Eldalote/Divelamp/BodyModel/Housing/Offerte/MainOnderkant3d.png

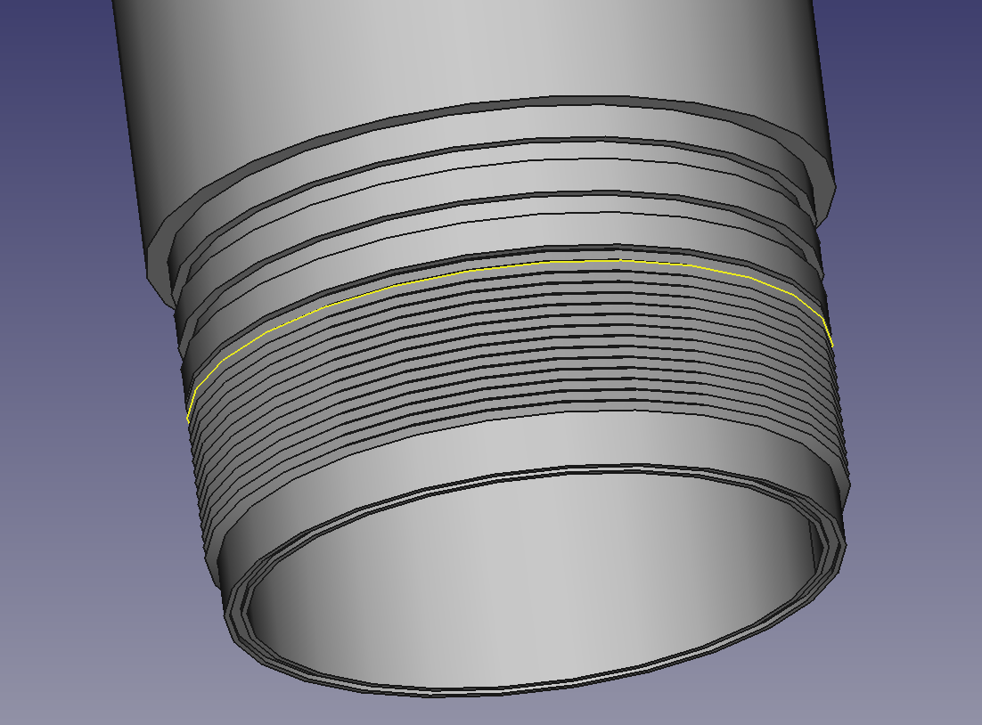
BodyModel/Housing/Offerte/MainOnderkant3d.png
