Eldalote/Divelamp/KiCadProject/OptionalOuterUSB/3D View & Output/OuterUSB Front.png

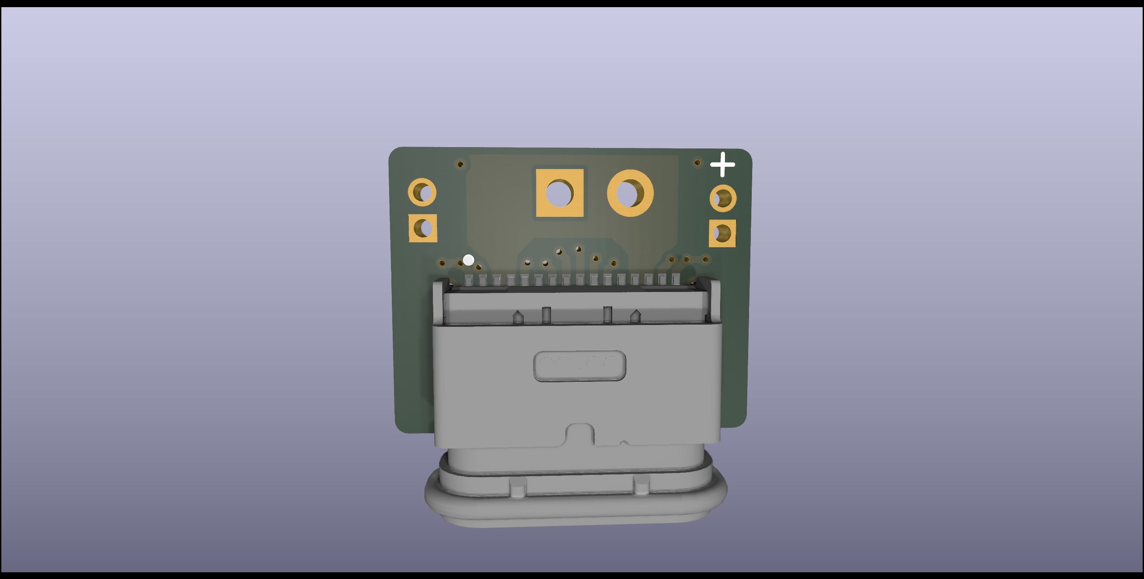
KiCadProject/OptionalOuterUSB/3D View & Output/OuterUSB Front.png
