Eldalote/Divelamp/Notes-TODOs.txt

Nog te bestellen / vergeten:
CMU 2287
SHR-05V-S connector + cables / qwicc cables /  KIT-15081

Xt60 en xt30 connectors + cable assemblies

2130830005 waterproof usb connector

assortiment aan kabeltjes

22uF ceramic caps 0805
