Eldalote/Divelamp/BodyModel/Housing/Offerte/Endstuk3d.png

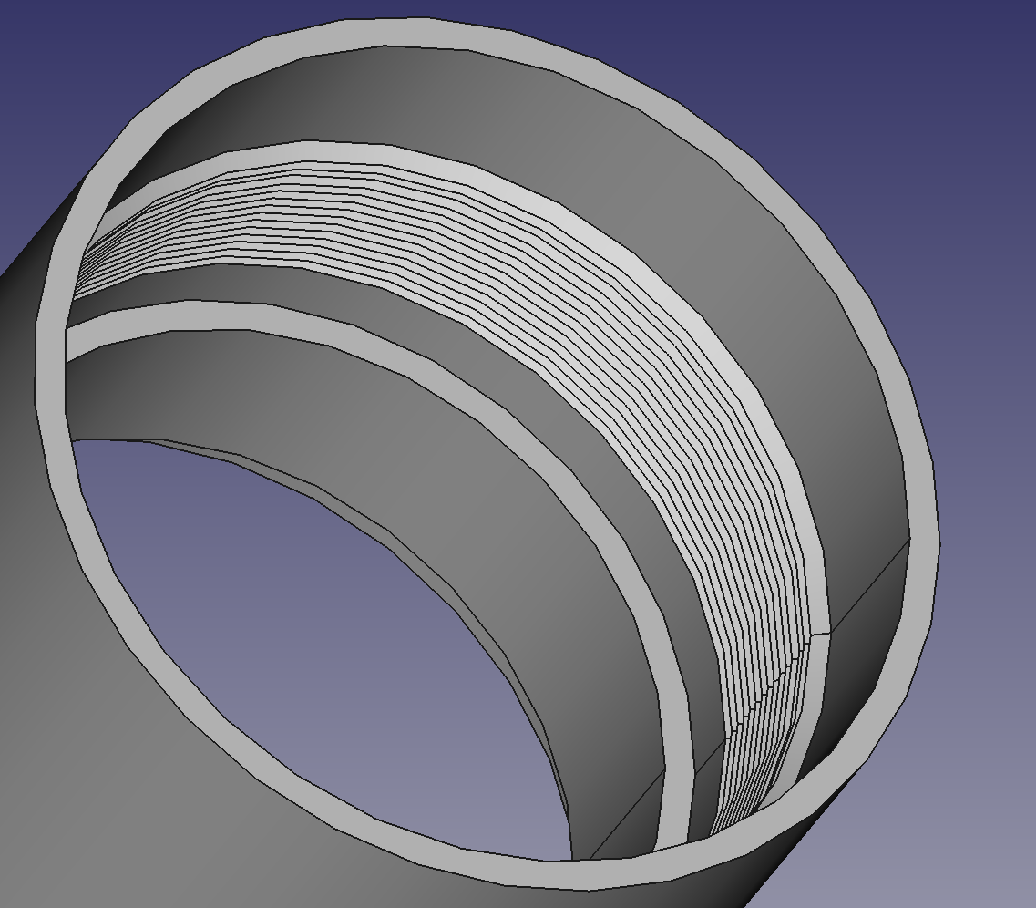
BodyModel/Housing/Offerte/Endstuk3d.png
