Eldalote/Divelamp/BodyModel/Housing/Offerte/EndstukOverzicht.png

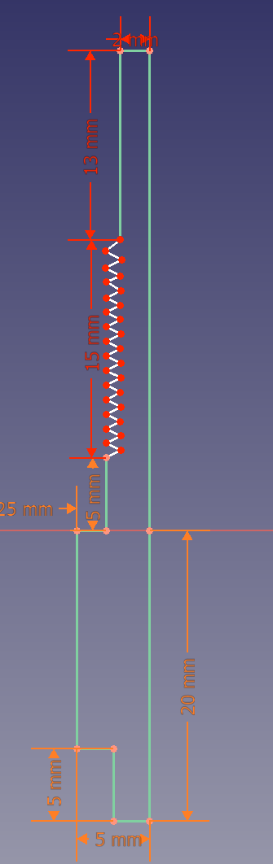
BodyModel/Housing/Offerte/EndstukOverzicht.png
