Eldalote/Divelamp/BodyModel/Housing/Offerte/Mainbovenkantdetail.png

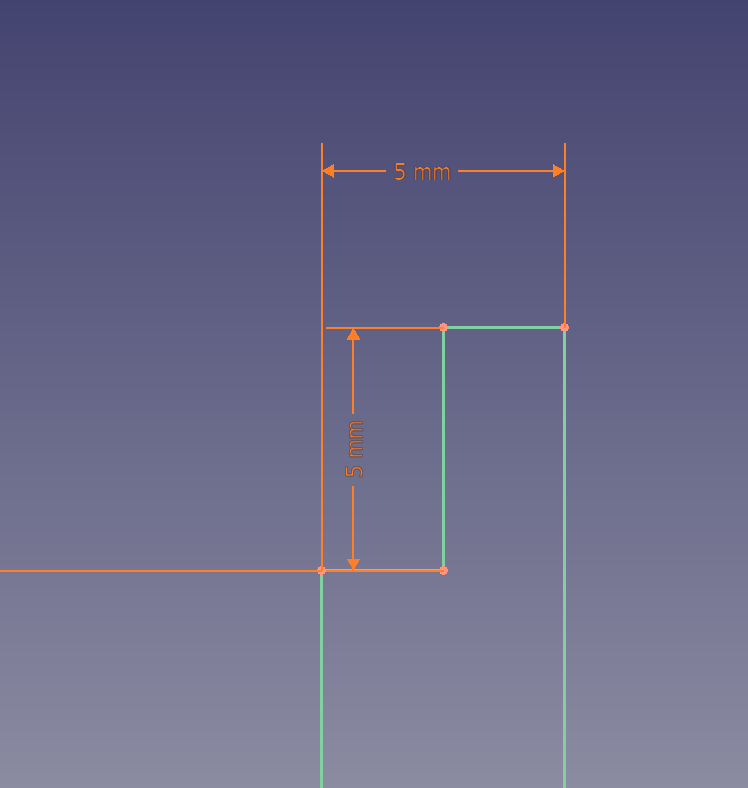
BodyModel/Housing/Offerte/Mainbovenkantdetail.png
