Eldalote/Divelamp/BodyModel/Housing/Offerte/MainOnderkantdetail2d.png

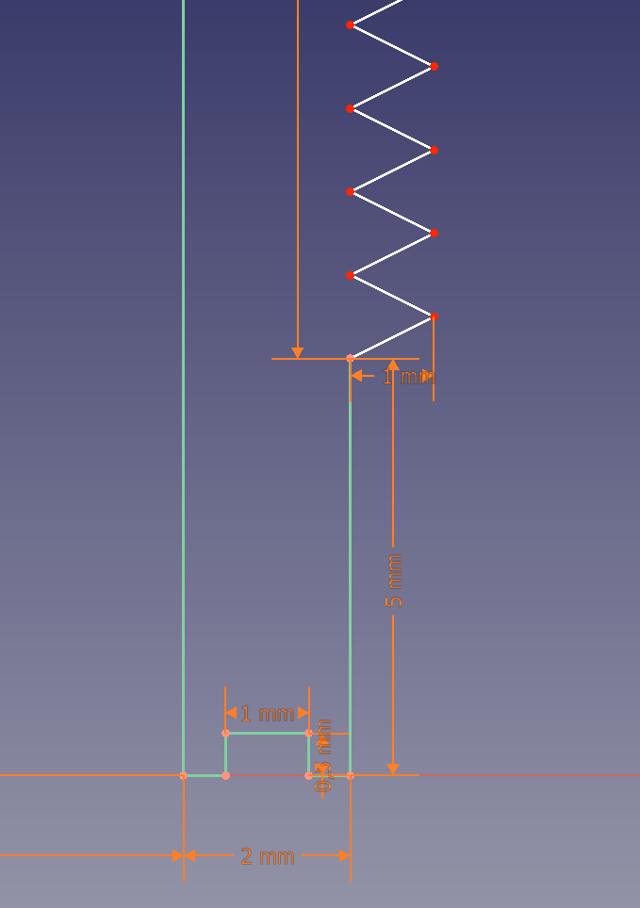
BodyModel/Housing/Offerte/MainOnderkantdetail2d.png
