Eldalote/Divelamp/BodyModel/Housing/Offerte/Mainoringgrooves2d.png

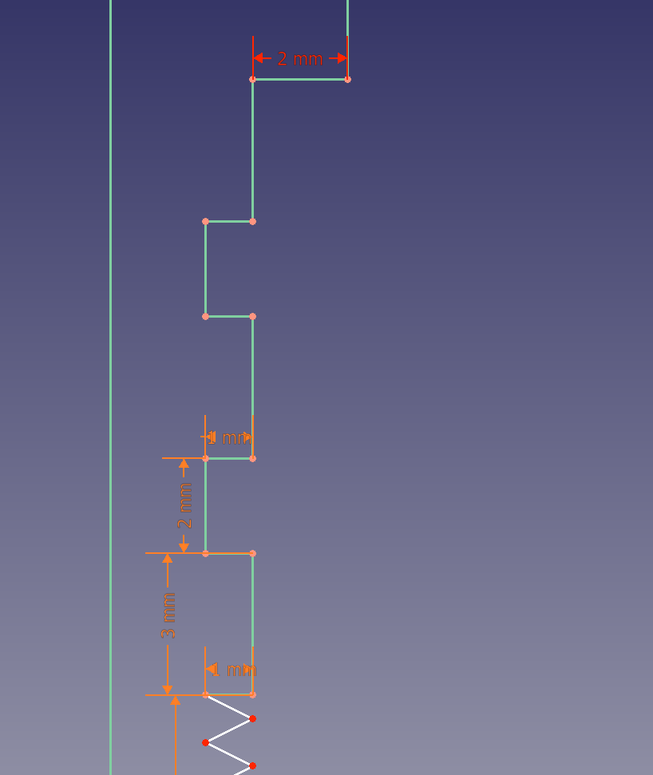
BodyModel/Housing/Offerte/Mainoringgrooves2d.png
