Eldalote/Divelamp/BodyModel/Housing/Offerte/MainOverzicht.png

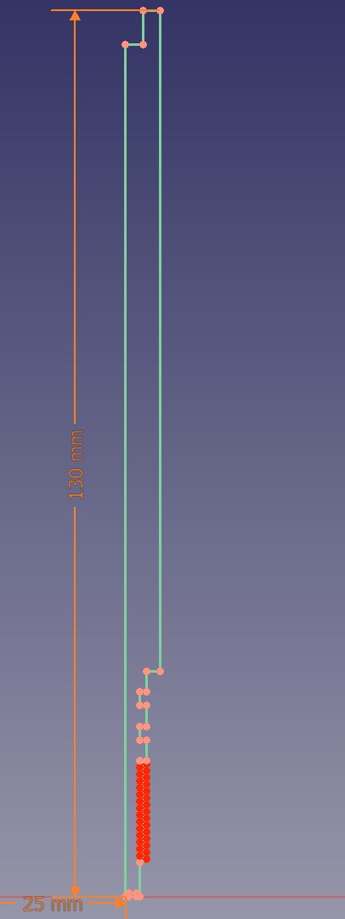
BodyModel/Housing/Offerte/MainOverzicht.png
