Eldalote/Divelamp/KiCadProject/BatteryManagementBoard/3D View & output/BMB Back Angle.png

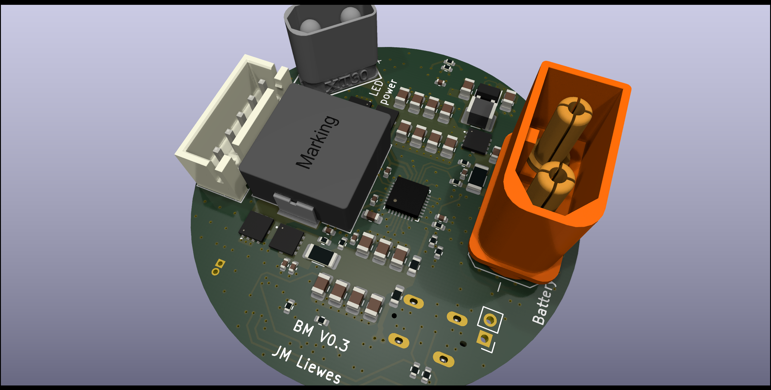
KiCadProject/BatteryManagementBoard/3D View & output/BMB Back Angle.png
