Eldalote/Divelamp/KiCadProject/BatteryManagementBoard/3D View & output/BMB Back.png

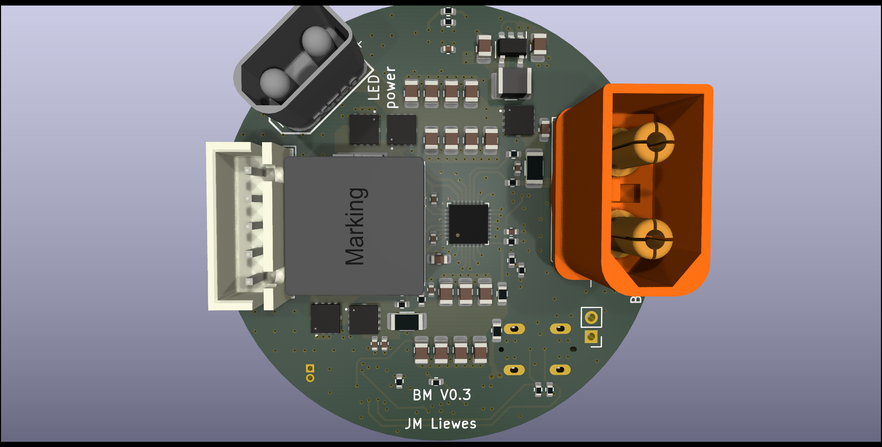
KiCadProject/BatteryManagementBoard/3D View & output/BMB Back.png
