Eldalote/Divelamp/KiCadProject/BatteryManagementBoard/3D View & output/BMB Front Angle.png

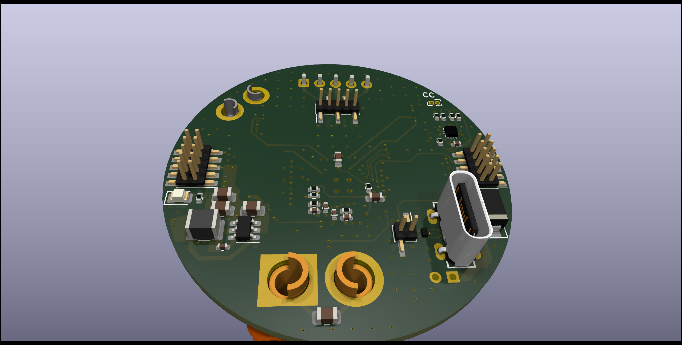
KiCadProject/BatteryManagementBoard/3D View & output/BMB Front Angle.png
