Eldalote/Divelamp/KiCadProject/BatteryManagementBoard/3D View & output/BMB Front.png

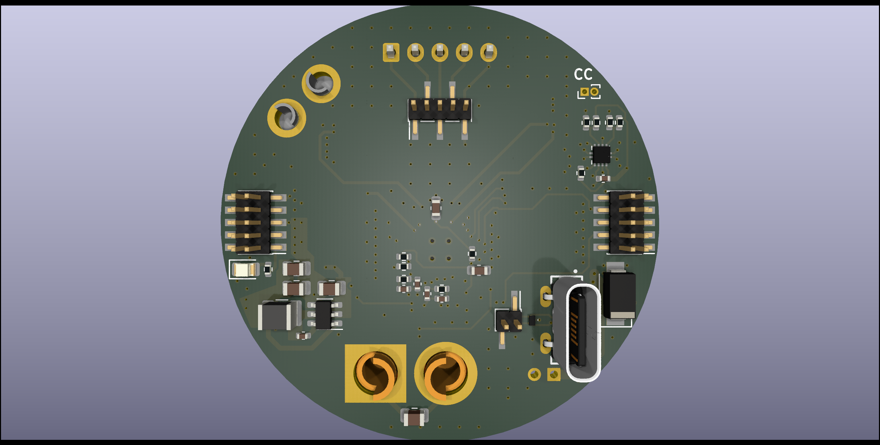
KiCadProject/BatteryManagementBoard/3D View & output/BMB Front.png
