Eldalote/Divelamp/KiCadProject/BatteryManagementBoard/BatteryManagementOverview.png

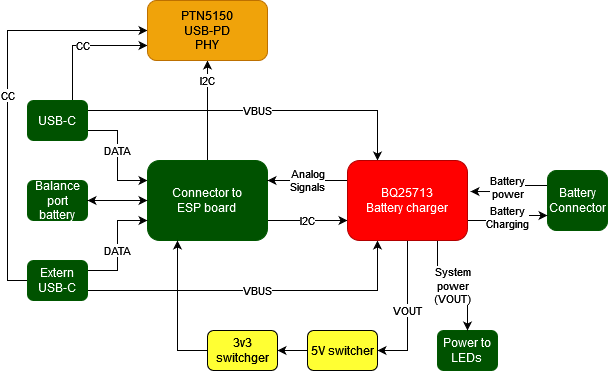
KiCadProject/BatteryManagementBoard/BatteryManagementOverview.png
