Eldalote/Divelamp/KiCadProject/BatteryManagementBoard/VeryRoughSketch.png

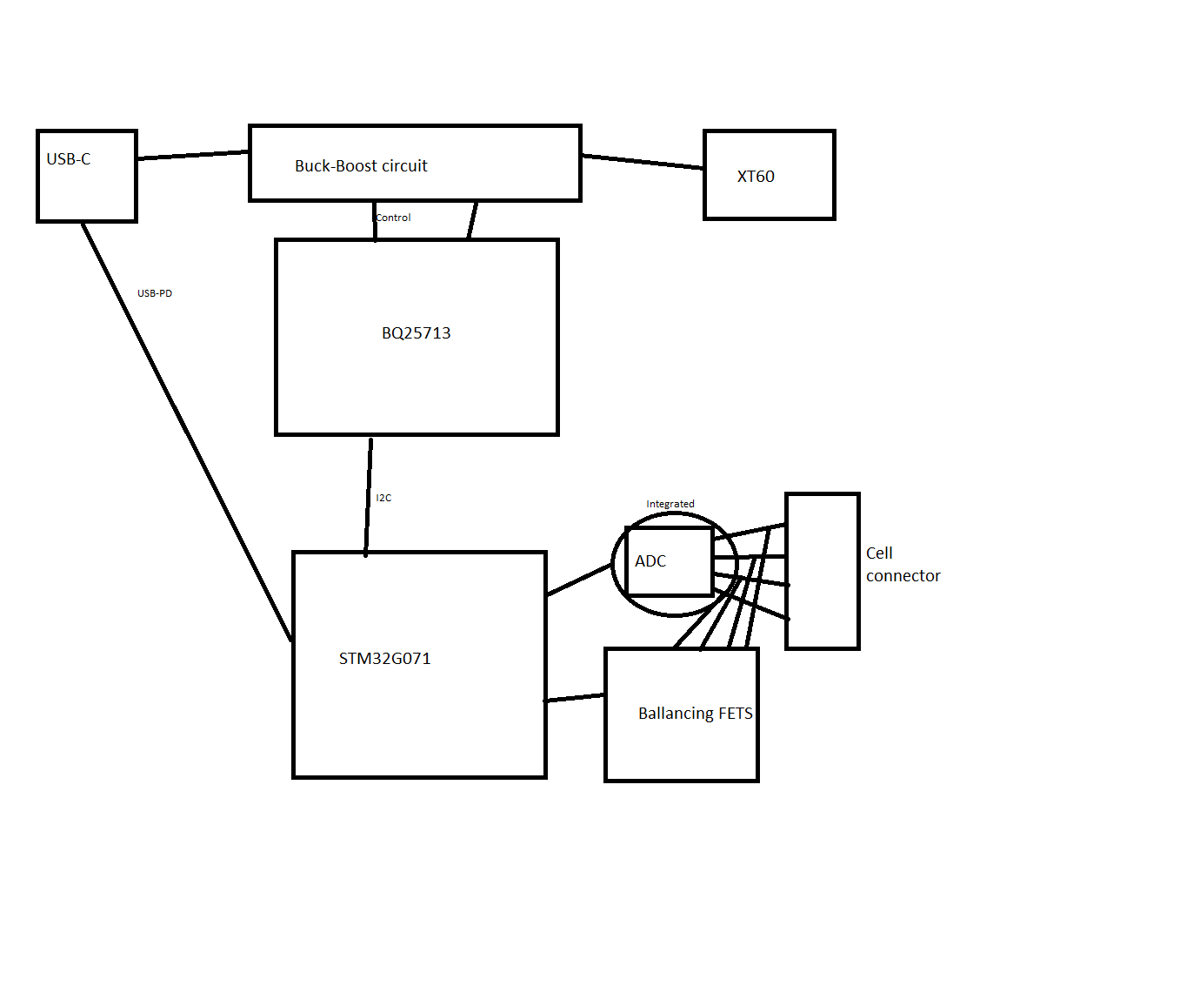
KiCadProject/BatteryManagementBoard/VeryRoughSketch.png
