Eldalote/Divelamp/KiCadProject/ESPBoard/3D view & Output/ESPBoard back Angle.png

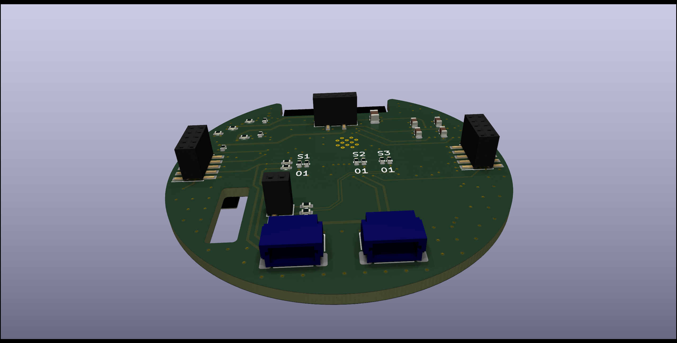
KiCadProject/ESPBoard/3D view & Output/ESPBoard back Angle.png
