Eldalote/Divelamp/KiCadProject/ESPBoard/3D view & Output/ESPBoard back.png

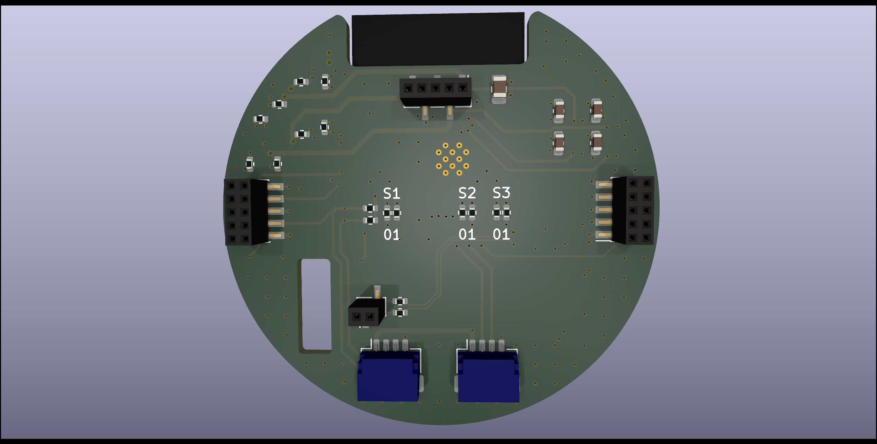
KiCadProject/ESPBoard/3D view & Output/ESPBoard back.png
