Eldalote/Divelamp/KiCadProject/ESPBoard/3D view & Output/ESPBoard Front Angle.png

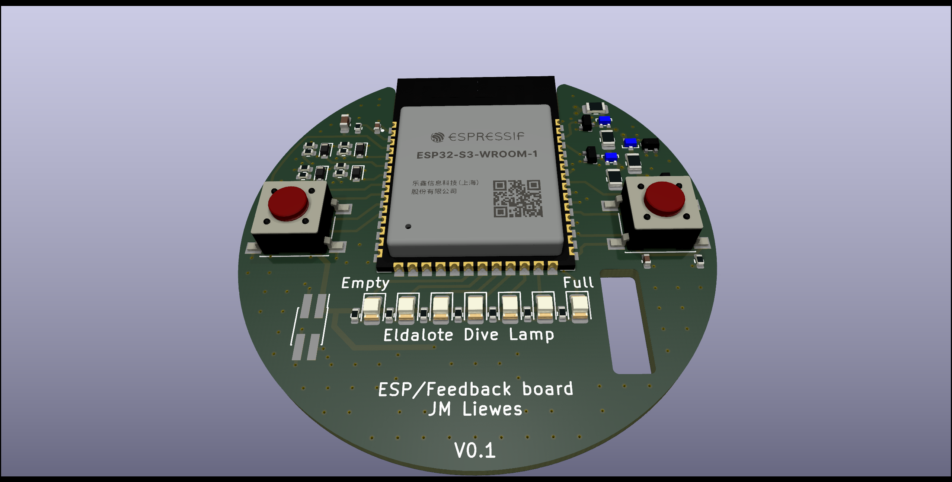
KiCadProject/ESPBoard/3D view & Output/ESPBoard Front Angle.png
