Eldalote/Divelamp/KiCadProject/ESPBoard/3D view & Output/ESPBoard Front.png

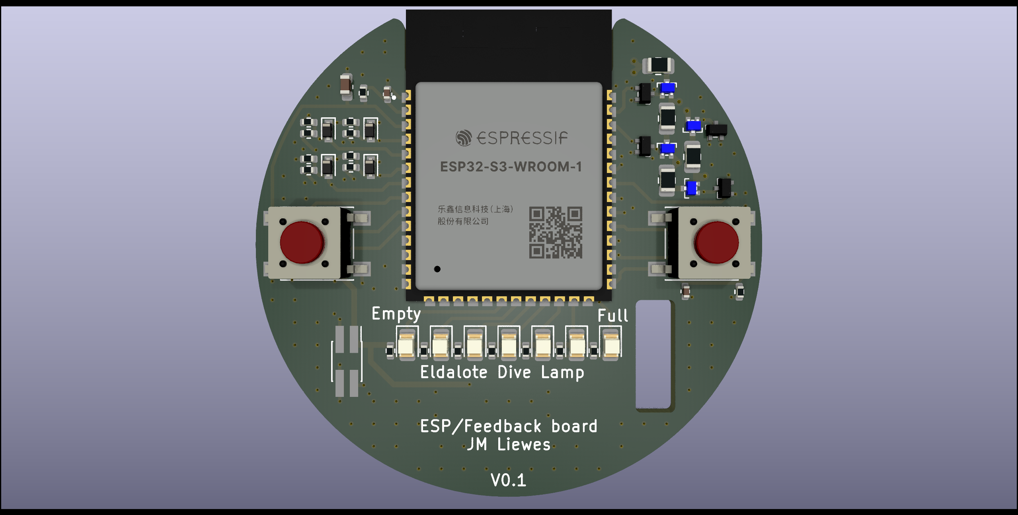
KiCadProject/ESPBoard/3D view & Output/ESPBoard Front.png
