Eldalote/Divelamp/KiCadProject/ESPBoard/ESP Board overview.png

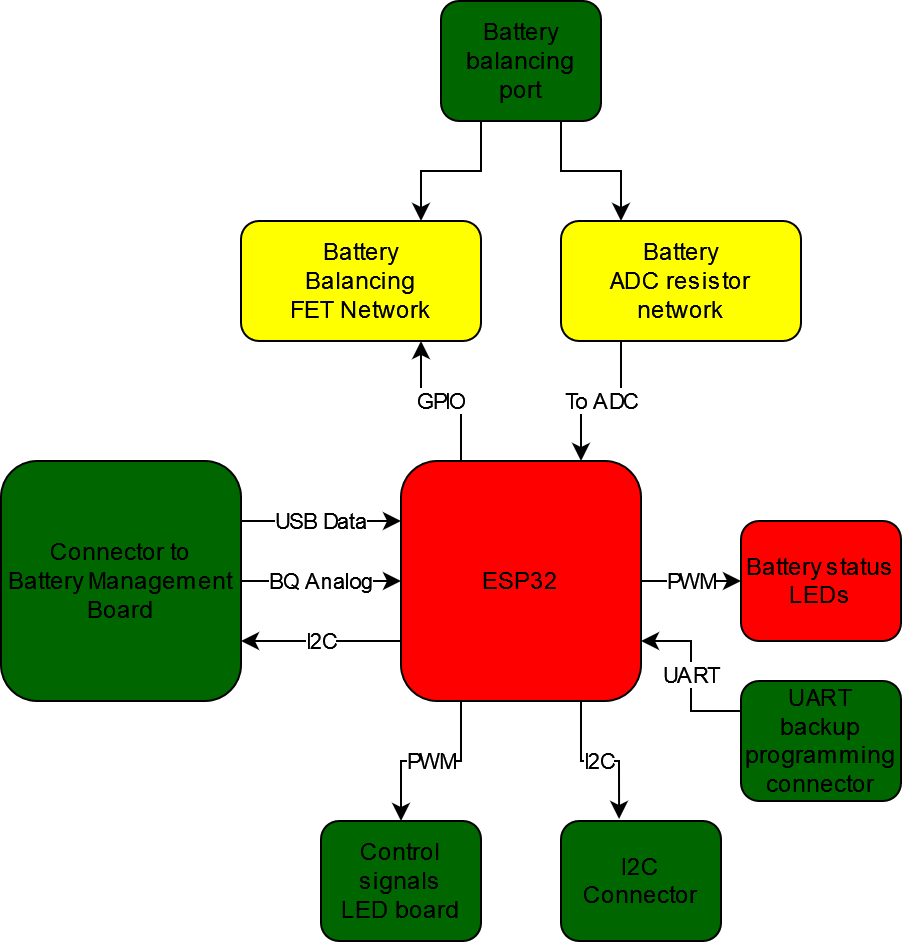
KiCadProject/ESPBoard/ESP Board overview.png
