Eldalote/Divelamp/KiCadProject/HallBoard/3D View & Output/HallBoard Back.png

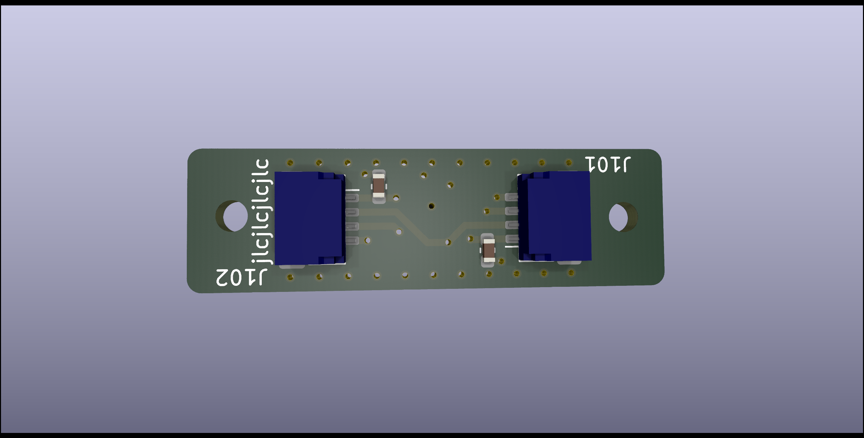
KiCadProject/HallBoard/3D View & Output/HallBoard Back.png
