Eldalote/Divelamp/KiCadProject/HallBoard/3D View & Output/HallBoard.png

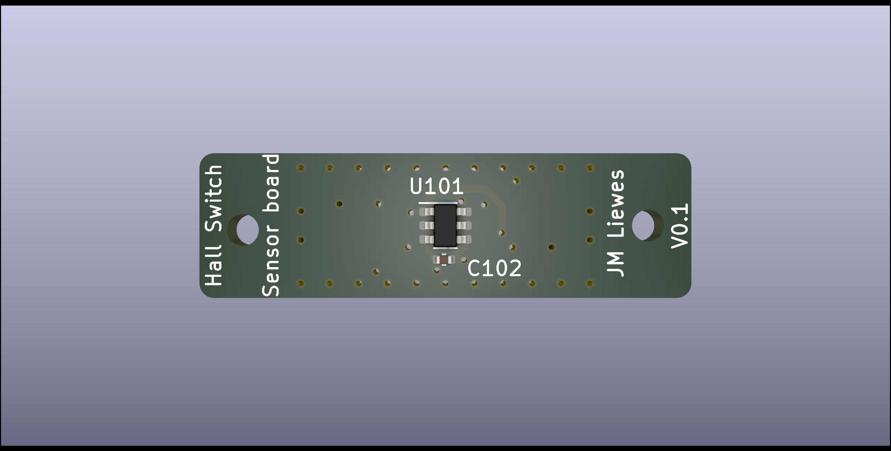
KiCadProject/HallBoard/3D View & Output/HallBoard.png
