Eldalote/Divelamp/KiCadProject/LEDDriverBoard/3D view & Output/LED driver Back.png

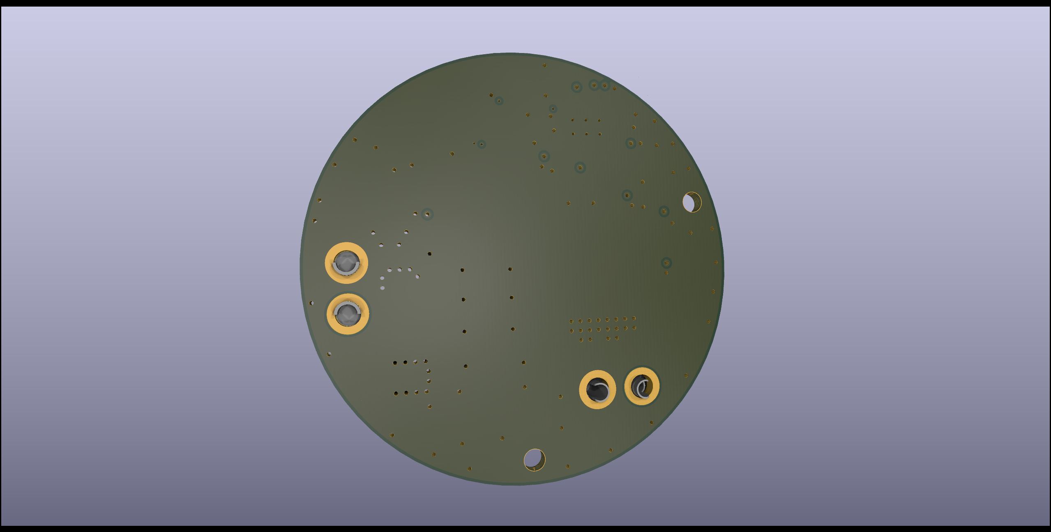
KiCadProject/LEDDriverBoard/3D view & Output/LED driver Back.png
