Eldalote/Divelamp/KiCadProject/LEDDriverBoard/3D view & Output/LED driver front Angle.png

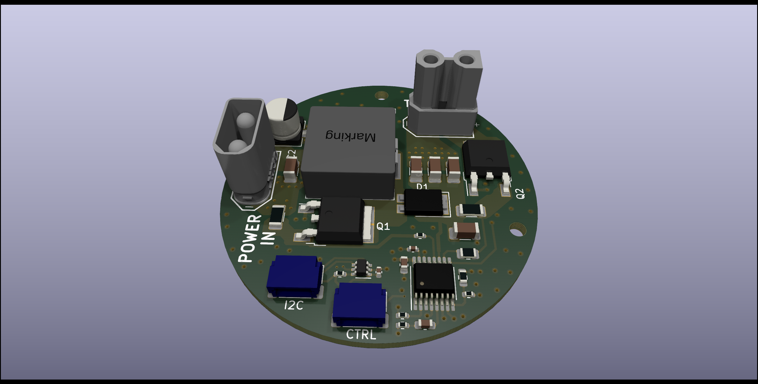
KiCadProject/LEDDriverBoard/3D view & Output/LED driver front Angle.png
