Eldalote/Divelamp/KiCadProject/LEDDriverBoard/3D view & Output/LED driver front.png

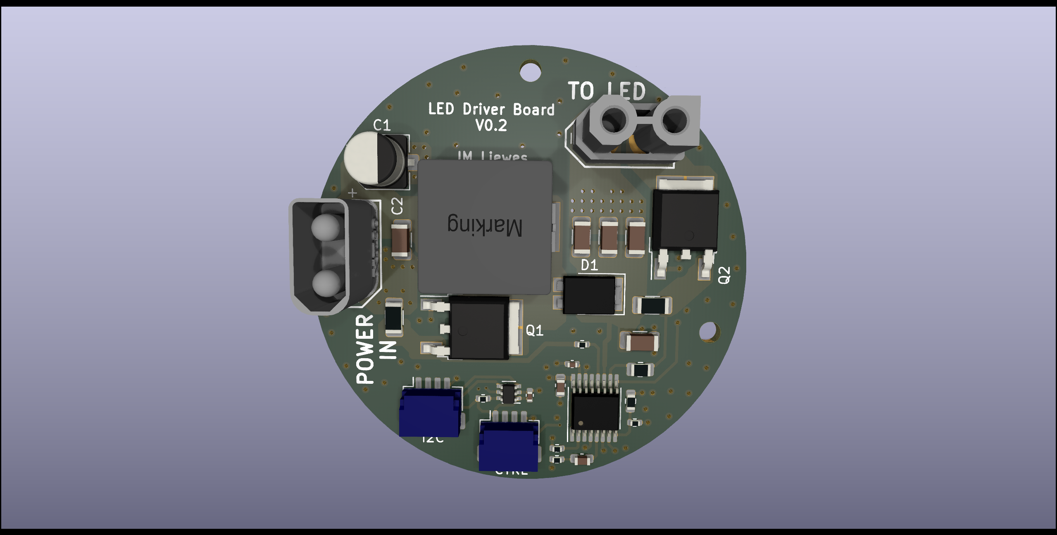
KiCadProject/LEDDriverBoard/3D view & Output/LED driver front.png
