Eldalote/Divelamp/KiCadProject/OptionalOuterUSB/3D View & Output/OuterUSB Back Angle.png

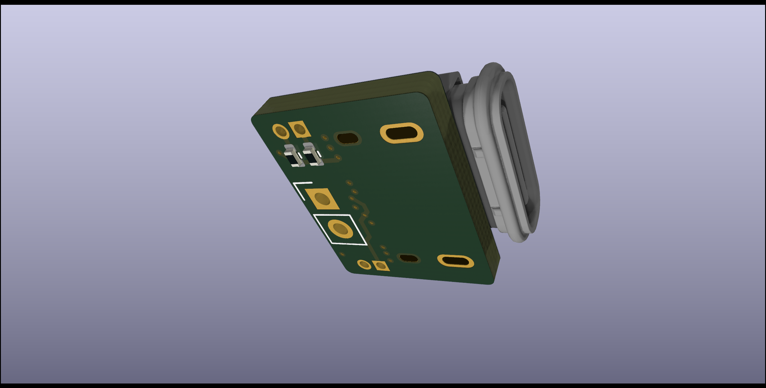
KiCadProject/OptionalOuterUSB/3D View & Output/OuterUSB Back Angle.png
