Eldalote/Divelamp/KiCadProject/OptionalOuterUSB/3D View & Output/OuterUSB Front Angle.png

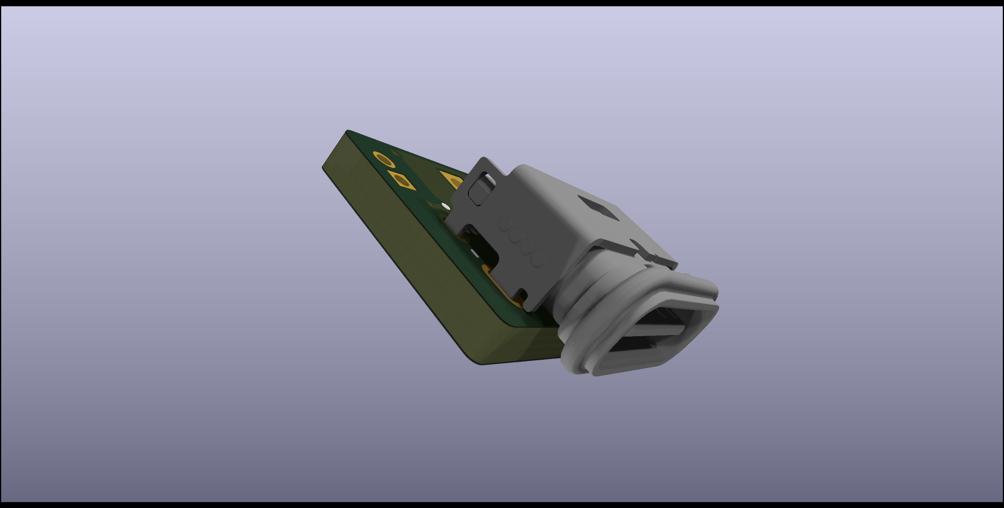
KiCadProject/OptionalOuterUSB/3D View & Output/OuterUSB Front Angle.png
