Eldalote/Divelamp/KiCadProject/SamsungLedBoard/3D View & Output/SamsungLedBoard Front.png

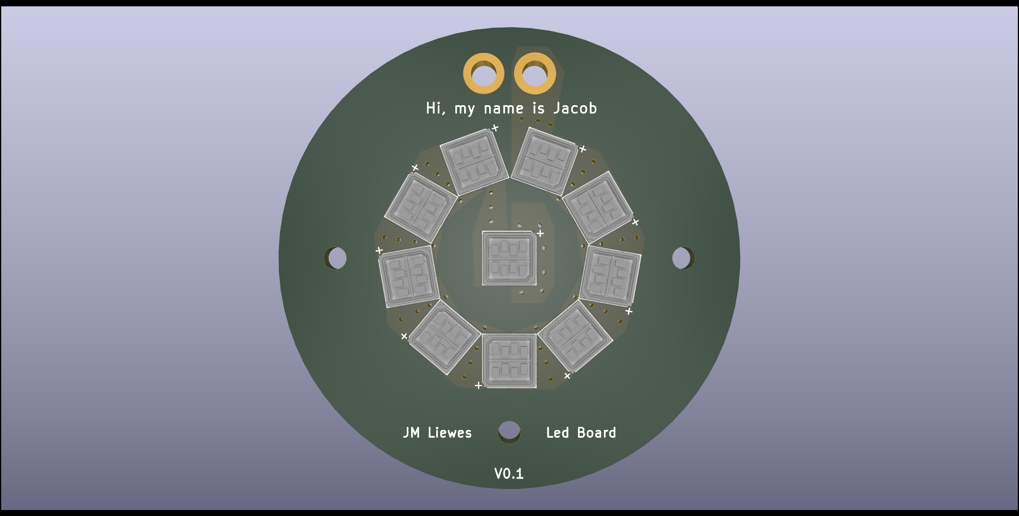
KiCadProject/SamsungLedBoard/3D View & Output/SamsungLedBoard Front.png
