Eldalote/Divelamp/VeryRoughSketch.png

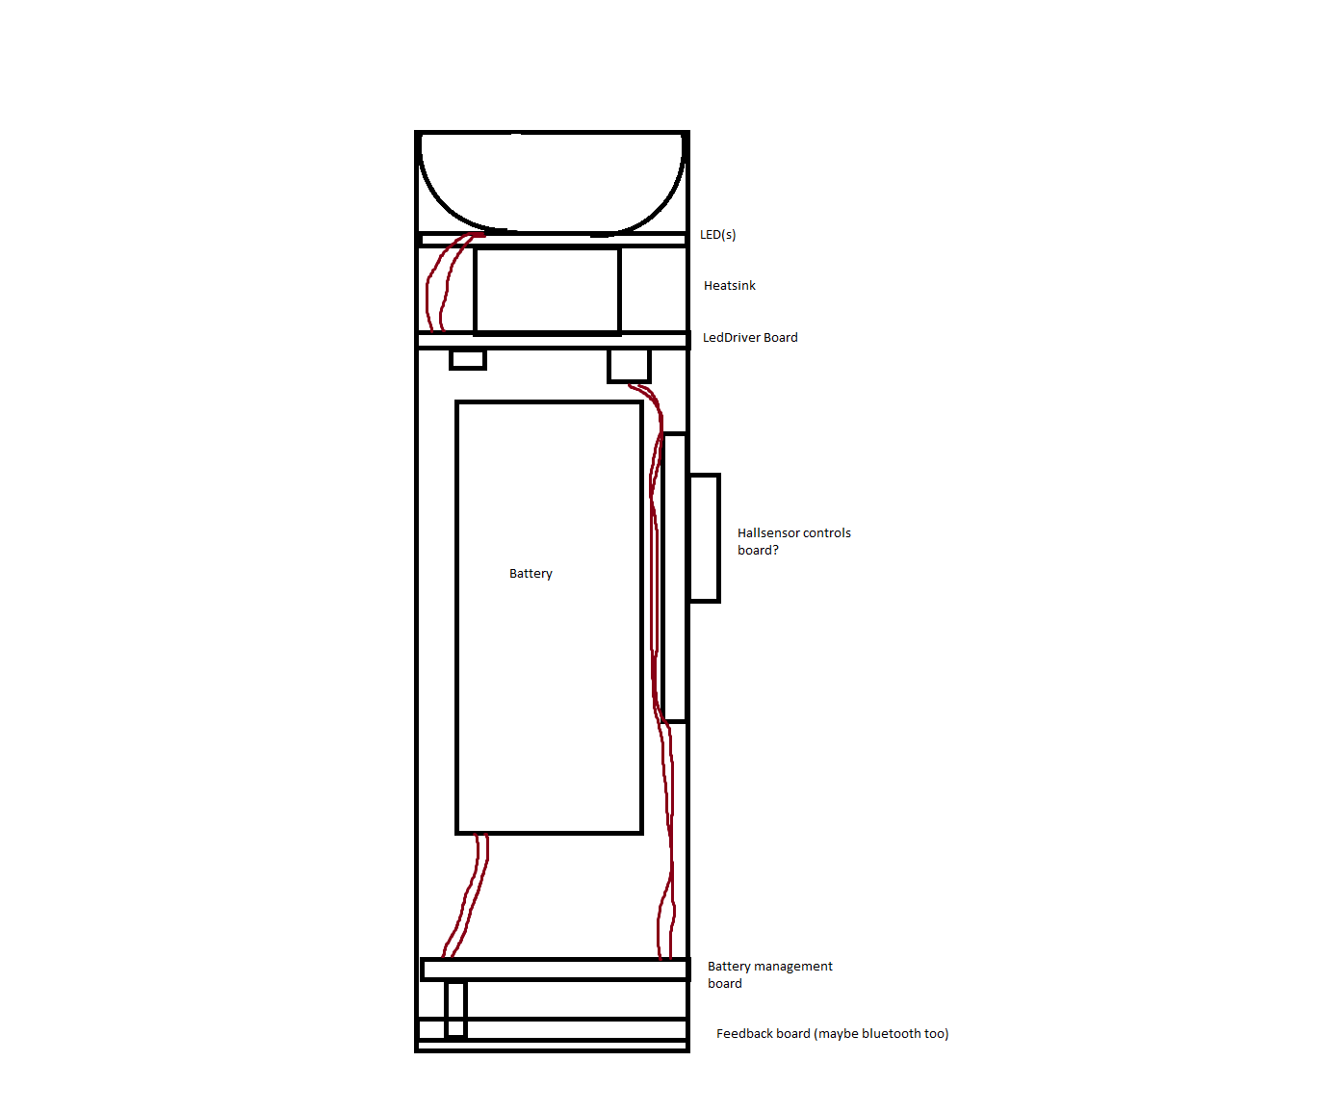
VeryRoughSketch.png
