Eldalote/Divelamp/KiCadProject/LEDDriverBoard/Components.ods

Sheet: New component definition
Component | Components in design | Footprint | Min Value | Max Value | Determined value | Other min ratings? | Hard Selected component? | Soft selected component | Alt soft selected
LED driver IC | U1 | TSSOP-16 |  |  | MAX16833 |  | MAX16833
Power Inductor | L1 | Custom |  |  | 6.8uH | 8.4A Average 9.5A Peak current | SRP1265C-6R8M
Schottsky diode | D1 | PowerDi-5 | 90v 5A |  |  |  |  | SDT5H100P5-7
Switching N-MOSFET | Q1 | TO-252 | 90v 5A |  |  | GDS |  | AOD66920
Dimming P-MOSFET | Q2 | TO-252 | 90v 5A |  |  | GDS |  | SUD50P10-43L-GE3
Connector Cap | c1 | 5x5.3 SMD elec | 22u 50V | 100u |  |  |  | 865080542006
In cap boost | C2 | 1206 | 10u 50V |  |  |  |  | CL31B106KBHNNNE
In cap for ic | C3 | 0603 | 100n 50V |  |  |  |  | CL05B104KB54PNC
VCC regulator cap | C4 | 0402 | 1u 16V
Compensation cap | C5 | 0603 | 25V |  | 220n / 390n |  |  | TMK107B7224KA-T | GCJ188R91E394KA01D
Output Caps | C6,C7,C8,C9 | 1206 | 4.7u 100V |  |  |  |  | GRJ31CZ72A475KE01L
100k Resistor (multiple) | R2, R3, R10 | 0402 | 100K |  |  |  |  | RC0402JR-07100KL
Frequency selection res | R1 | 0402 | 7.3 | 7.4 |  |  |  | RC0402FR-077K32L
Compensation Resistor | R8 | 0402 |  |  | 910Ohm/ 120Ohm |  |  | RC0402FR-07910RL | RC0402FR-07120RL
Switch current sense compensation res | R4 | 0402 |  |  | 4.7kOhm/2.7kOhm |  |  | RC0402FR-134K7L | RC0402FR-072K7L
Switch current sense res | R9 | 1206 |  |  | 51mOhm/33mOhm |  |  | RL1206FR-7W0R051L | D1WEL1206MR033FA-T5
LED current sense extra res | R7 | 0603 |  |  | 100Ohm |  |  | RC0603FR-13100RL
Overvoltage protection res | R5 | 0603 |  |  | 5.1MOhm / 4.75MOhm |  |  | RC0603FR-075M1L | RC0603FR-074M75L
LED current sense res | R6 | 1206 |  |  | 330mOhm/130mOhm |  |  | D1WEL1206MR330F-T5 | CRL1206-FW-R130ELF

Sheet: Sheet1
Component | value | Footprint | Name | octopart
OUTDATED COMPONENT NUMBERING!!!!
C1 | 10uF | 1206 | CL31B106KBHNNNE | https://octopart.com/search?q=CL31B106KBHNNNE&currency=EUR&specs=0
C2 | 4x4.7uF | 1206 | GRM31CC72A475KE11L | https://octopart.com/search?q=GRM31CC72A475KE11L&currency=EUR&specs=0
C3 | 2.2uF | 0603 | CL10A225KO8NNN | https://octopart.com/search?q=CL10A225KO8NNN&currency=EUR&specs=0
C4 | 0.22uF | 0805 | CL21B224KCFSNWE | https://octopart.com/search?q=CL21B224KCFSNWE&currency=EUR&specs=0
C4* | 0.39uF | 0805 | C0805X394K5RAC7800 | https://octopart.com/search?q=C0805X394K5RAC7800&currency=EUR&specs=0
R1 | 4.7kOhm | 0603 | RC0603FR-074K7L | https://octopart.com/search?q=RC0603FR-074K7L&currency=EUR&specs=0
R1* | 2.7kOhm | 0603 | RC0603FR-102K7L | https://octopart.com/search?q=RC0603FR-102K7L&currency=EUR&specs=0
R2 | 100Ohm | 0805 | RC0805FR-07100RL | https://octopart.com/search?q=RC0805FR-07100RL&currency=EUR&specs=0
R3 | 7.5kOhm | 0603 | RC0603FR-137K5L | https://octopart.com/search?q=RC0603FR-137K5L&currency=EUR&specs=0
R4 | 51mOhm | 0603 | ERJ-3BWFR051V | https://octopart.com/search?q=ERJ-3BWFR051V&currency=EUR&specs=0
R4* | 33mOhm | 0603 | D1WEL0603MR033F-T5 | https://octopart.com/search?q=D1WEL0603MR033F-T5&currency=EUR&specs=0
R5 | 5.1MOhm | 0603 | RC0603FR-075M1L | https://octopart.com/search?q=RC0603FR-075M1L&currency=EUR&specs=0
R5* | 4.75MOhm | 0603 | RC0603FR-074M75L | https://octopart.com/search?q=RC0603FR-074M75L&currency=EUR&specs=0
R7 | 330mOhm | 1206 | D1WEL1206MR330F-T5 | https://octopart.com/search?q=D1WEL1206MR330F-T5&currency=EUR&specs=0
R7* | 130mOhm | 1206 | CRL1206-FW-R130ELF | https://octopart.com/search?q=CRL1206-FW-R130ELF&currency=EUR&specs=0
R8 | 100kOhm | 0603 | RC0603FR-07100KL | https://octopart.com/search?q=RC0603FR-07100KL&currency=EUR&specs=0
R9 | 100kOhm | 0603 | RC0603FR-07100KL | https://octopart.com/search?q=RC0603FR-07100KL&currency=EUR&specs=0
R10 | 953Ohm | 0402 | RC0402FR-07953RL | https://octopart.com/search?q=RC0402FR-07953RL&currency=EUR&specs=0
R10* | 120Ohm | 0402 | RC0402FR-07120RL | https://octopart.com/search?q=RC0402FR-07120RL&currency=EUR&specs=0
R11 | 100kOhm | 0603 | RC0603FR-07100KL | https://octopart.com/search?q=RC0603FR-07100KL&currency=EUR&specs=0
D1 | Schottsky | PowerDi5 | SDT5H100P5-7 | https://octopart.com/search?q=SDT5H100P5-7&currency=EUR&specs=0
L1 | 6.8uH | Custom | SRP1265C-6R8M | https://octopart.com/search?q=SRP1265C-6R8M&currency=EUR&specs=0
