Eldalote/Divelamp/BodyModel/Housing/HousingMachining.FCStd

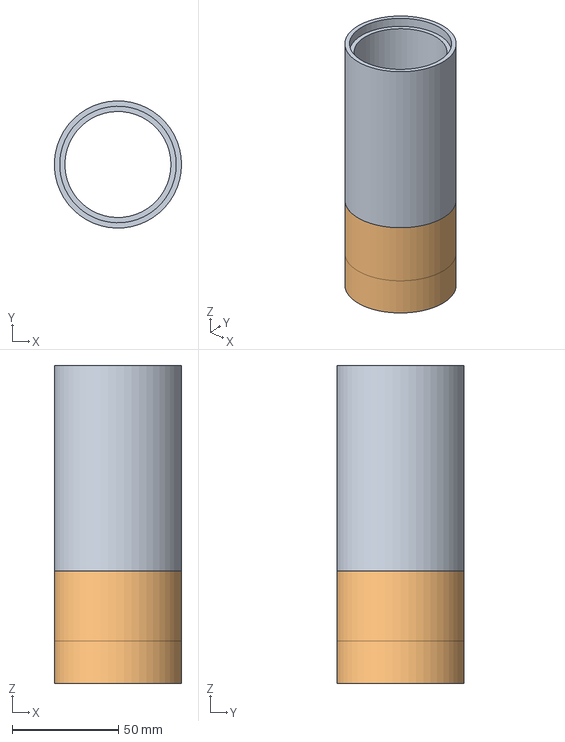
[picture p29: CAD file, 2023-02-27]
BodyModel/Housing/HousingMachining.FCStd
59.9 x 60.0 x 150.0 mm
