Eldalote/Divelamp/BodyModel/Housing/Offerte/HousingOfferte.step

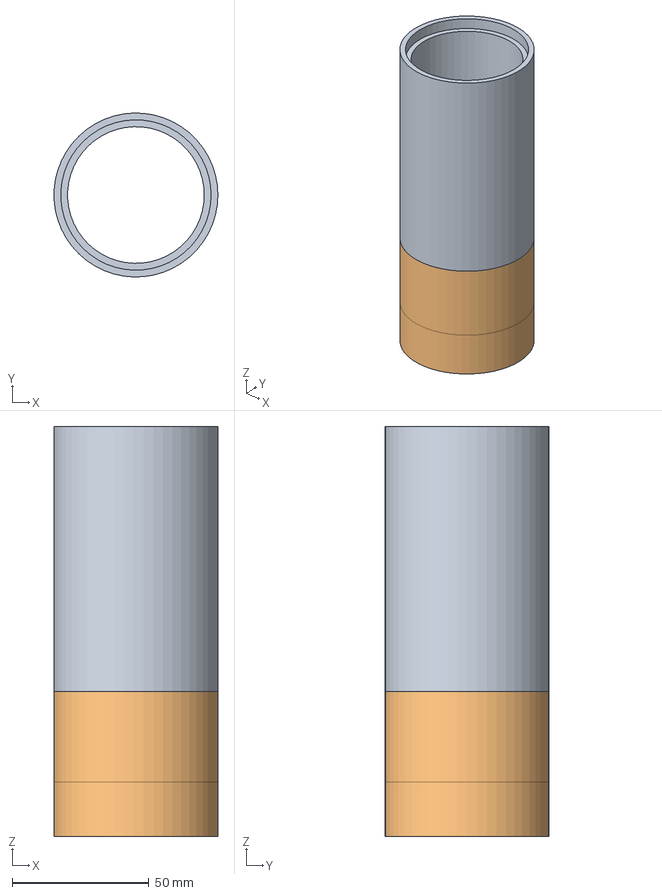
[picture p30: CAD file, 2023-02-23]
BodyModel/Housing/Offerte/HousingOfferte.step
59.9 x 60.0 x 150.0 mm
Sketch
