Eldalote/Divelamp/BodyModel/Parts/Battery/Battery.FCStd

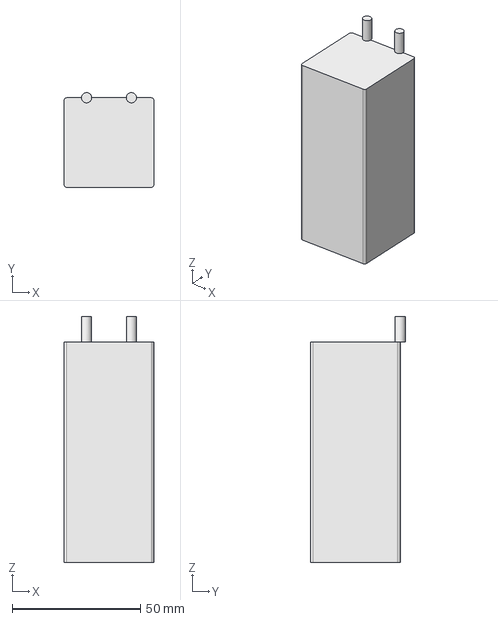
[picture p31: CAD file, 2023-02-06]
BodyModel/Parts/Battery/Battery.FCStd
35.0 x 37.0 x 96.0 mm
