Eldalote/Divelamp/BodyModel/Parts/PCBs/HallBoard.step

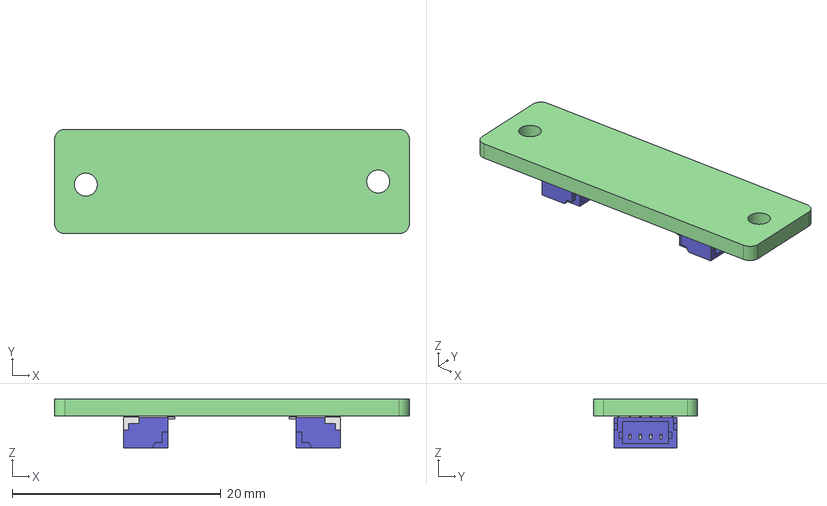
[picture p32: CAD file, 2023-02-02]
BodyModel/Parts/PCBs/HallBoard.step
34.0 x 10.0 x 4.66 mm
HallBoard PCB
