Eldalote/Divelamp/KiCadProject/OptionalOuterUSB/3D View & Output/OuterUSB.step

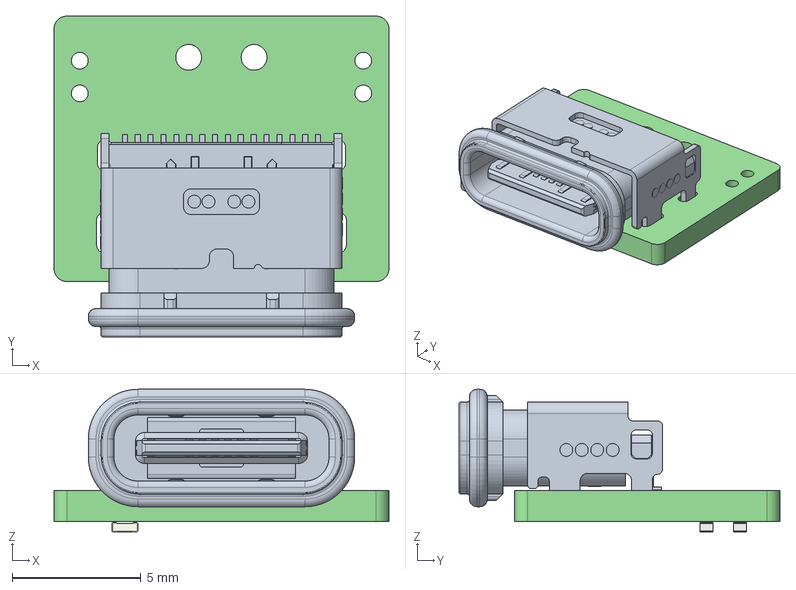
[picture p33: CAD file, 2023-03-17]
KiCadProject/OptionalOuterUSB/3D View & Output/OuterUSB.step
13.0 x 12.4 x 5.53 mm
OuterUSB PCB
