Eldalote/Divelamp/BodyModel/Parts/PCBs/SamsungLedBoard.step

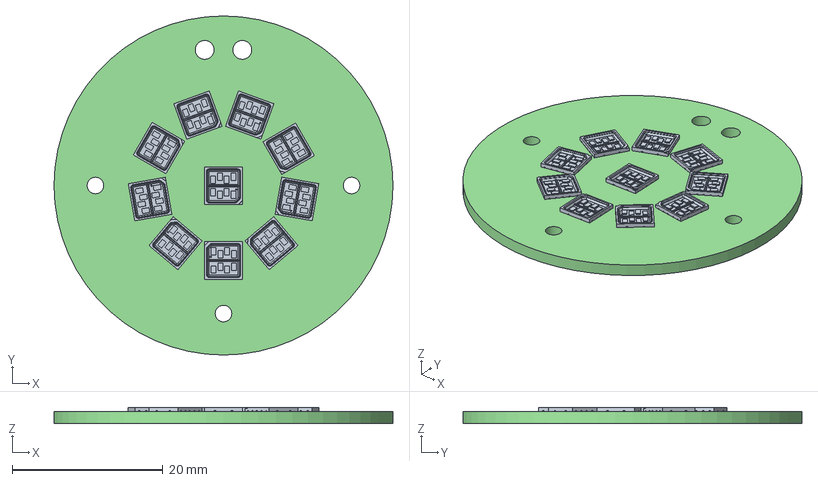
[picture p34: CAD file, 2023-02-02]
BodyModel/Parts/PCBs/SamsungLedBoard.step
45.0 x 45.0 x 2.16 mm
SamsungLedBoard PCB
