Eldalote/Divelamp/KiCadImports/3DModels/STEP_LH502C_LH508C.stp

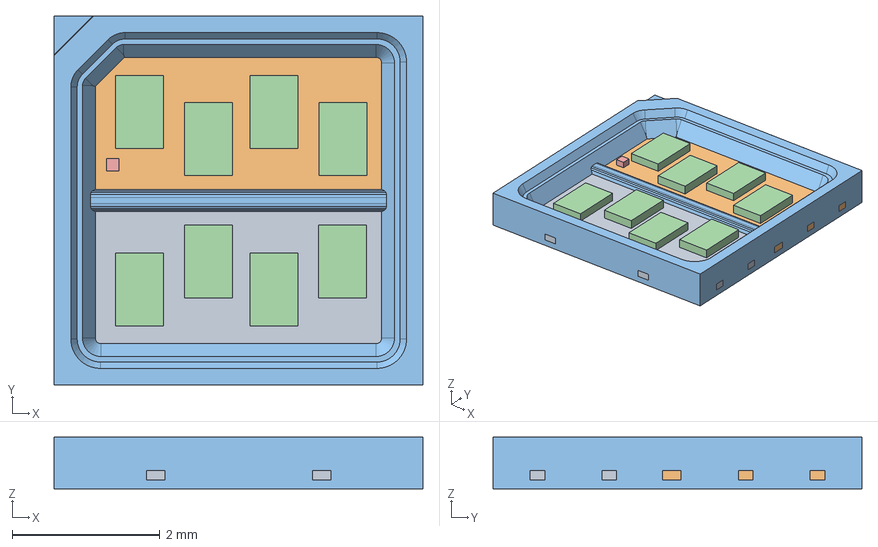
[picture p35: CAD file, 2023-02-01]
KiCadImports/3DModels/STEP_LH502C_LH508C.stp
5.00 x 5.00 x 0.7 mm
DT_MATERIAL11715789 x 2
A$C27796F67788 x 8
DT_OPTIONS11717787
DT_LIGHT11718786 x 2
