Eldalote/Divelamp/BodyModel/Parts/PCBs/OuterUSB.step

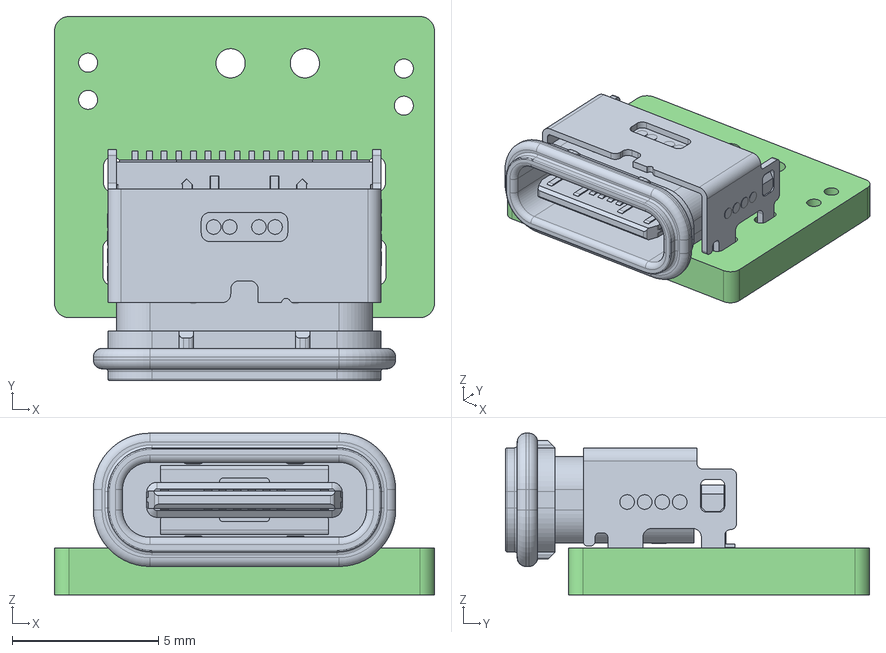
[picture p36: CAD file, 2023-02-02]
BodyModel/Parts/PCBs/OuterUSB.step
13.0 x 12.4 x 5.53 mm
OuterUSB PCB
