Eldalote/Divelamp/KiCadImports/3DModels/SC-89.step

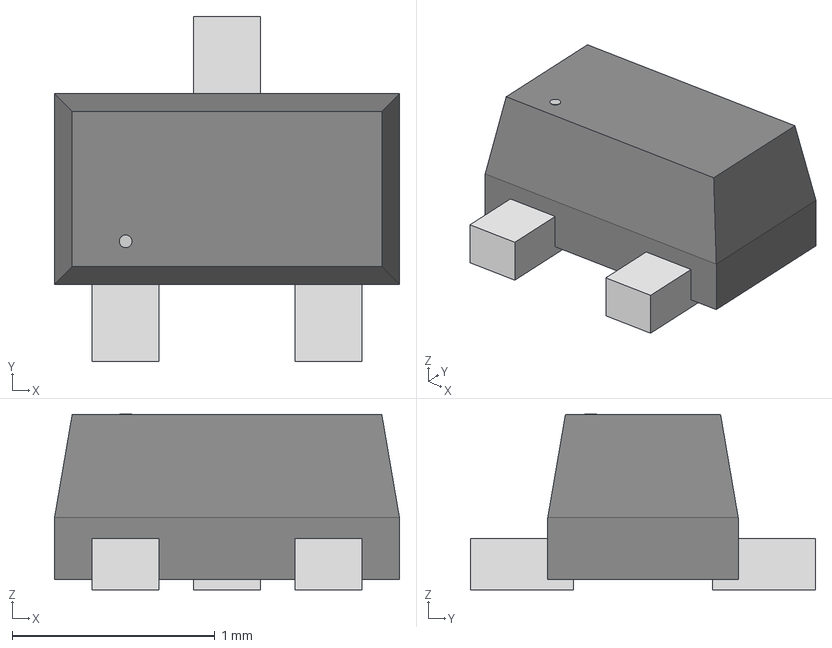
[picture p37: CAD file, 2023-01-25]
KiCadImports/3DModels/SC-89.step
1.70 x 1.70 x 0.866 mm
