Eldalote/Divelamp/KiCadImports/3DModels/SOT1355-1_X2QFN12_NXP.step

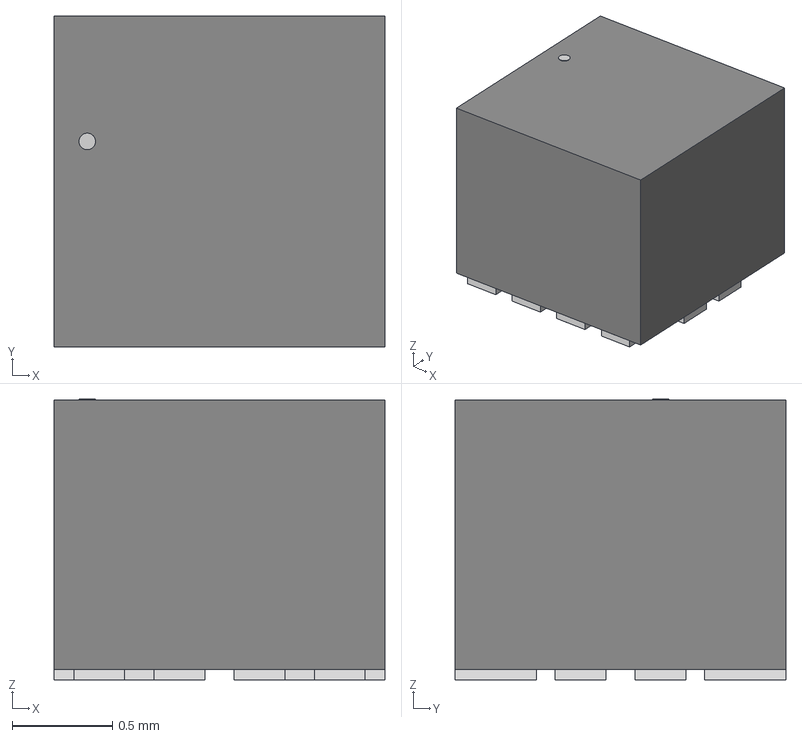
[picture p38: CAD file, 2023-01-25]
KiCadImports/3DModels/SOT1355-1_X2QFN12_NXP.step
1.65 x 1.65 x 1.40 mm
