Eldalote/Divelamp/KiCadImports/3DModels/SOT-723.step

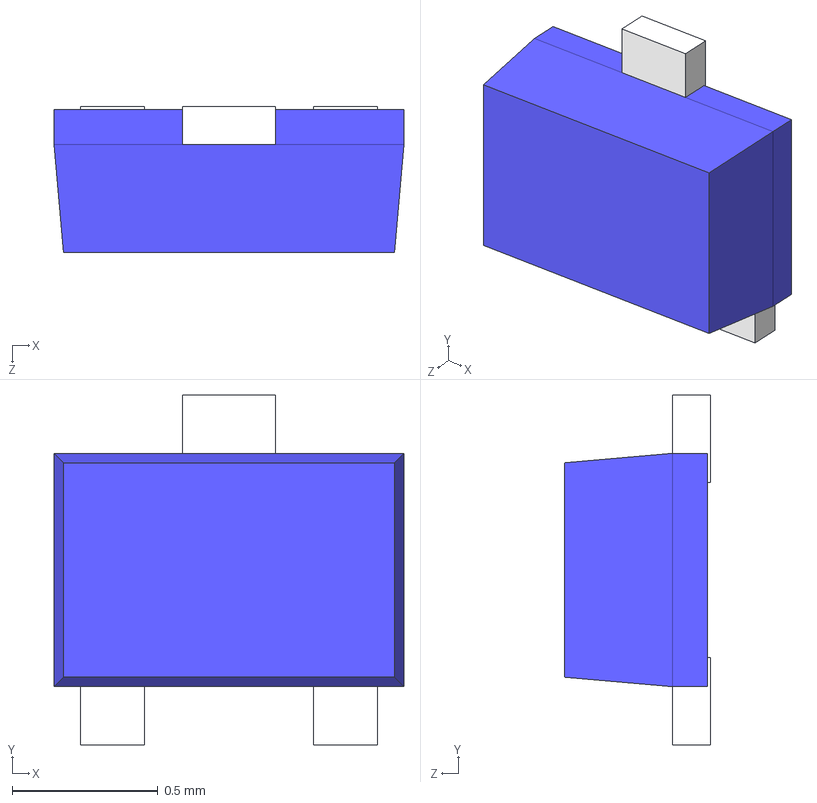
[picture p39: CAD file, 2023-01-25]
KiCadImports/3DModels/SOT-723.step
1.20 x 1.20 x 0.5 mm
