Eldalote/Divelamp/KiCadImports/3DModels/ESD122DMXR.step

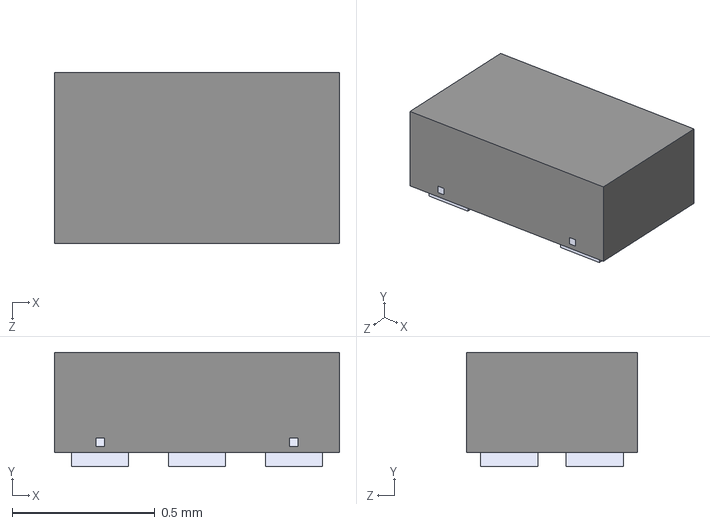
[picture p40: CAD file, 2023-01-09]
KiCadImports/3DModels/ESD122DMXR.step
1.00 x 0.4 x 0.6 mm
