Eldalote/Divelamp/KiCadImports/3DModels/SM04B-SRSS-TB.STEP

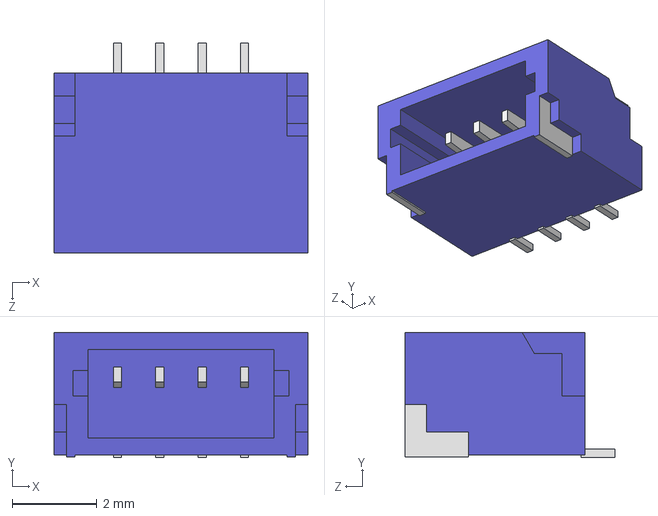
[picture p41: CAD file, 2023-01-08]
KiCadImports/3DModels/SM04B-SRSS-TB.STEP
6.00 x 2.96 x 4.95 mm
