Eldalote/Divelamp/KiCadImports/3DModels/USB4120-03-C.stp

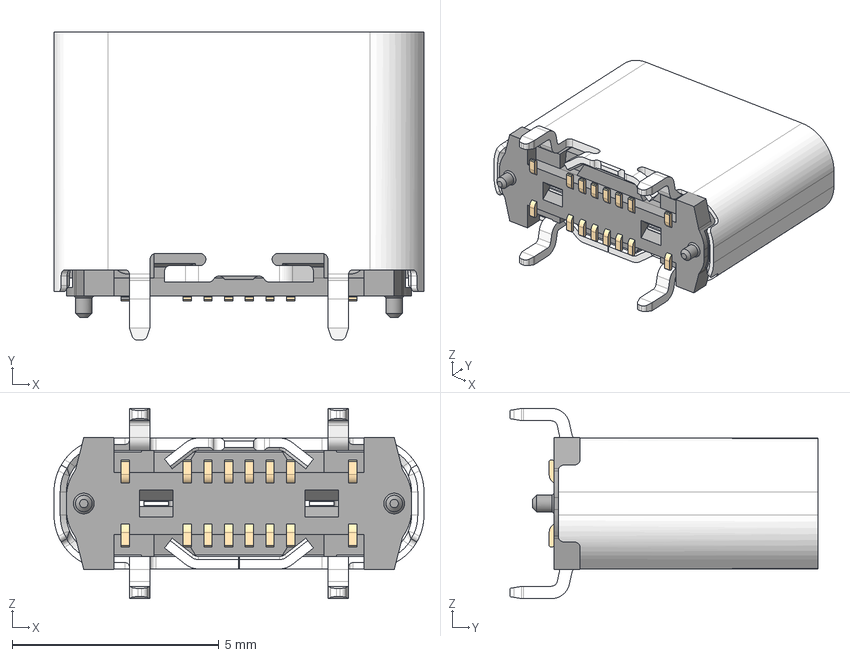
[picture p42: CAD file, 2023-01-04]
KiCadImports/3DModels/USB4120-03-C.stp
8.94 x 7.45 x 4.60 mm
