Eldalote/Divelamp/KiCadImports/3DModels/ESP32-S3-WROOM.step

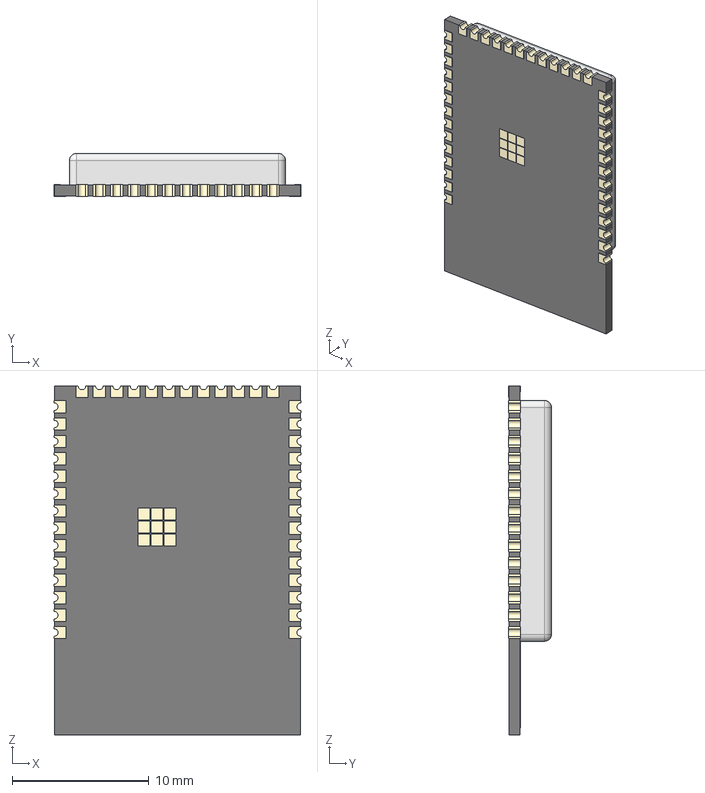
[picture p43: CAD file, 2023-01-04]
KiCadImports/3DModels/ESP32-S3-WROOM.step
18.0 x 3.16 x 25.5 mm
ESP-S3-WROOM_via x 26
ESP32-S3-WROOM_shell
ESP32-S3-WROOM_body
ESP-S3-WROOM_via v3(镜像) x 14
