Eldalote/Divelamp/KiCadImports/3DModels/USB4140-GF-0170-C.stp

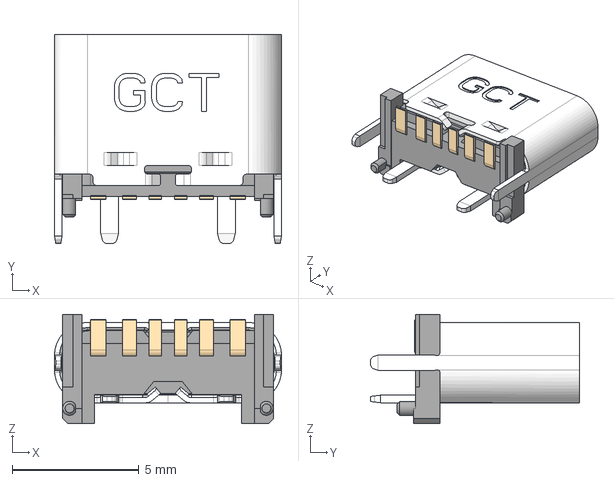
[picture p44: CAD file, 2022-12-09]
KiCadImports/3DModels/USB4140-GF-0170-C.stp
8.94 x 8.23 x 4.30 mm
USB4140-GF-0170-C_PART2
USB4140-GF-0170-C_PART1
