Eldalote/Divelamp/KiCadImports/3DModels/SRP1265C SERIES.stp

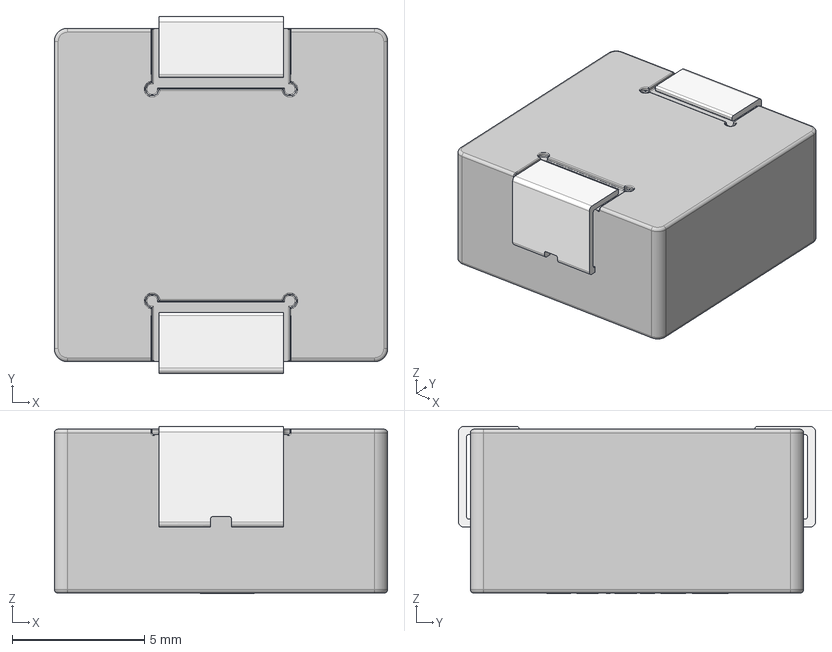
[picture p45: CAD file, 2022-12-02]
KiCadImports/3DModels/SRP1265C SERIES.stp
12.6 x 13.5 x 6.31 mm
