Eldalote/Divelamp/KiCadImports/3DModels/PowerPAK SO-8.stp

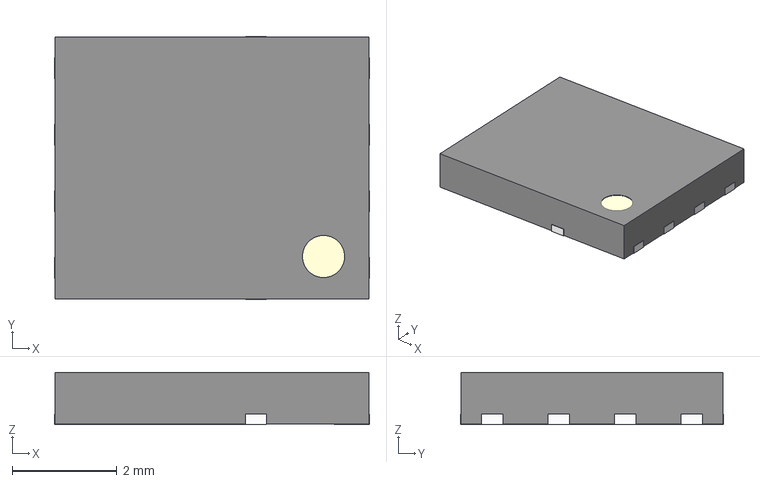
[picture p46: CAD file, 2022-12-02]
KiCadImports/3DModels/PowerPAK SO-8.stp
6.02 x 5.02 x 1.00 mm
pins
