Eldalote/Divelamp/KiCadImports/3DModels/PowerDI5.stp

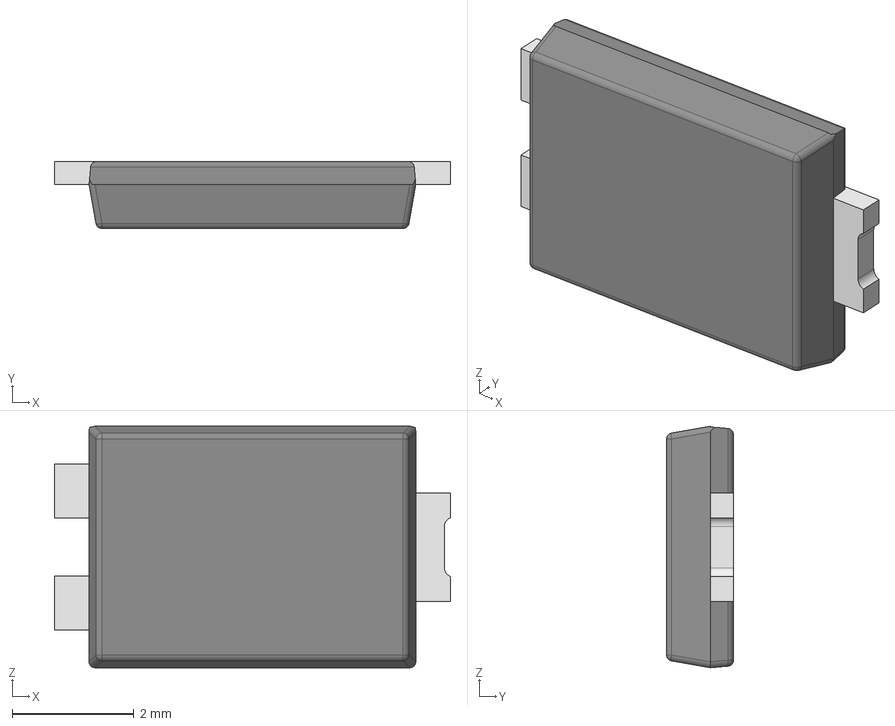
[picture p47: CAD file, 2022-12-02]
KiCadImports/3DModels/PowerDI5.stp
6.51 x 1.10 x 3.97 mm
PD-5 compound
PD-5 LF_0
PD-5 LF
