Eldalote/Divelamp/KiCadImports/3DModels/XT60H-F v3.step

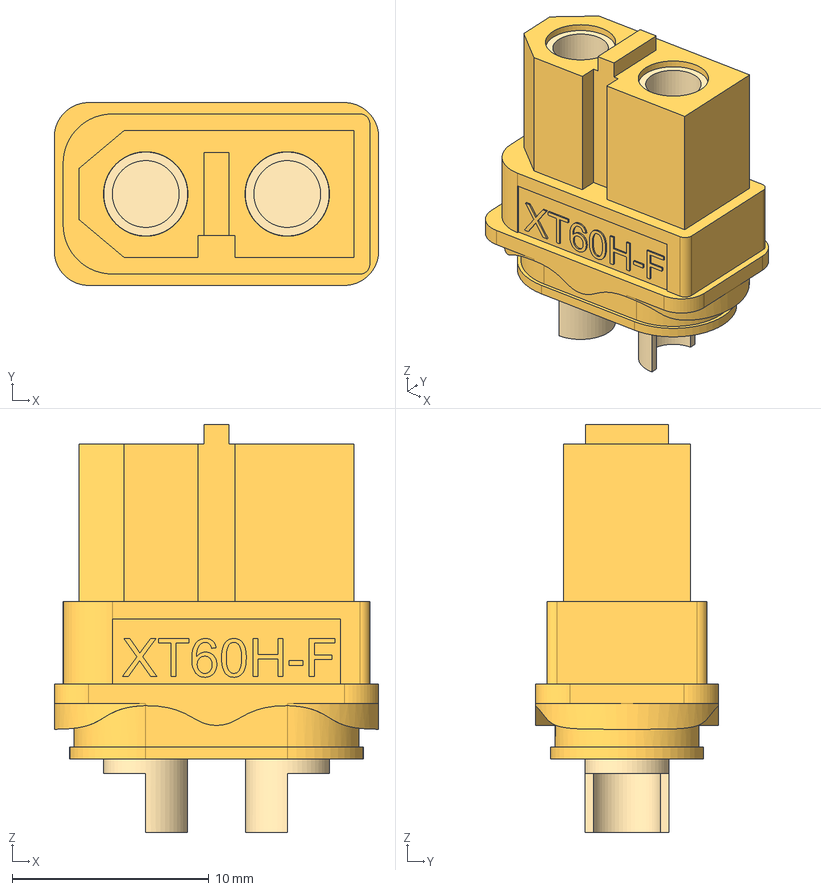
[picture p48: CAD file, 2022-12-02]
KiCadImports/3DModels/XT60H-F v3.step
16.5 x 9.30 x 20.8 mm
Housing
Contact x 2
