Eldalote/Divelamp/KiCadImports/3DModels/XT30-male.stp

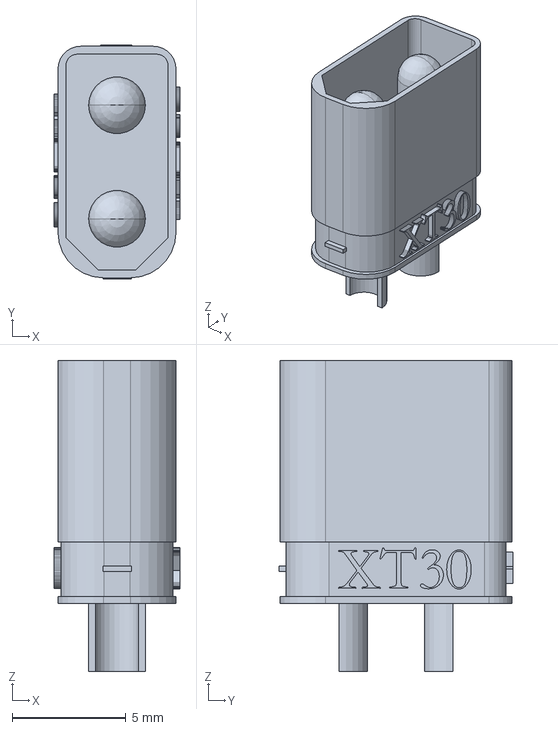
[picture p49: CAD file, 2022-12-02]
KiCadImports/3DModels/XT30-male.stp
5.54 x 10.3 x 13.7 mm
