Eldalote/Divelamp/KiCadImports/3DModels/XT60H-M v6.step

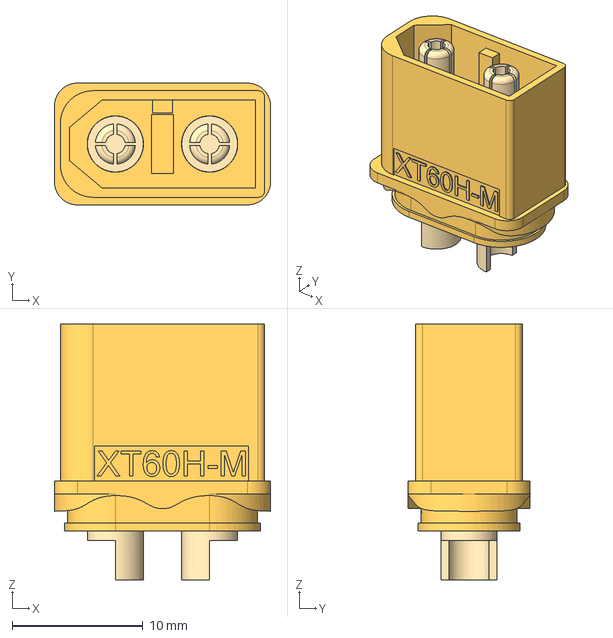
[picture p50: CAD file, 2022-12-02]
KiCadImports/3DModels/XT60H-M v6.step
16.5 x 9.30 x 19.6 mm
Housing
Contact x 2
