Eldalote/Divelamp/(list of files, cad)

Other CAD files:
BodyModel/Housing/Housing.FCStd
BodyModel/Parts/Battery/Battery-BatteryBlock.step
BodyModel/Parts/Battery/Battery-BatteryBlock.stl
KiCadImports/3DModels/2130830005.stp
KiCadImports/3DModels/5050660622.stp
