Eldalote/Divelamp/Assembly help/Hallboard.png

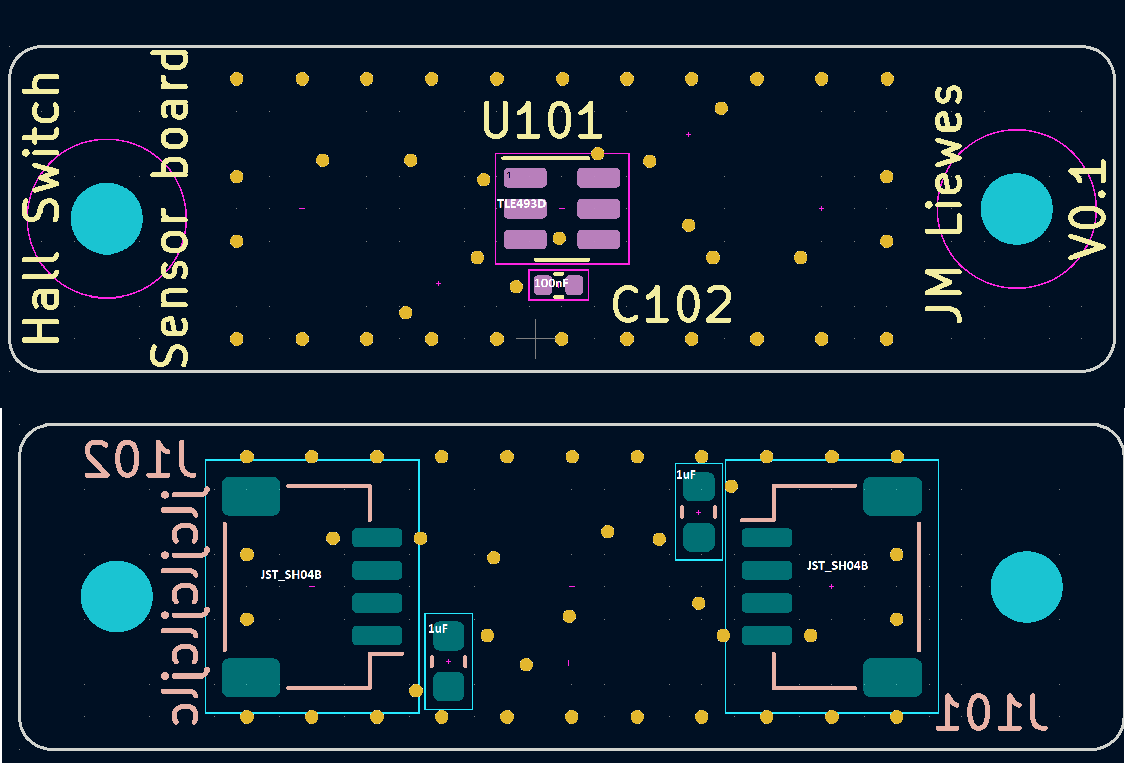
Assembly help/Hallboard.png
