Eldalote/Divelamp/Assembly help/LEDDriver.png

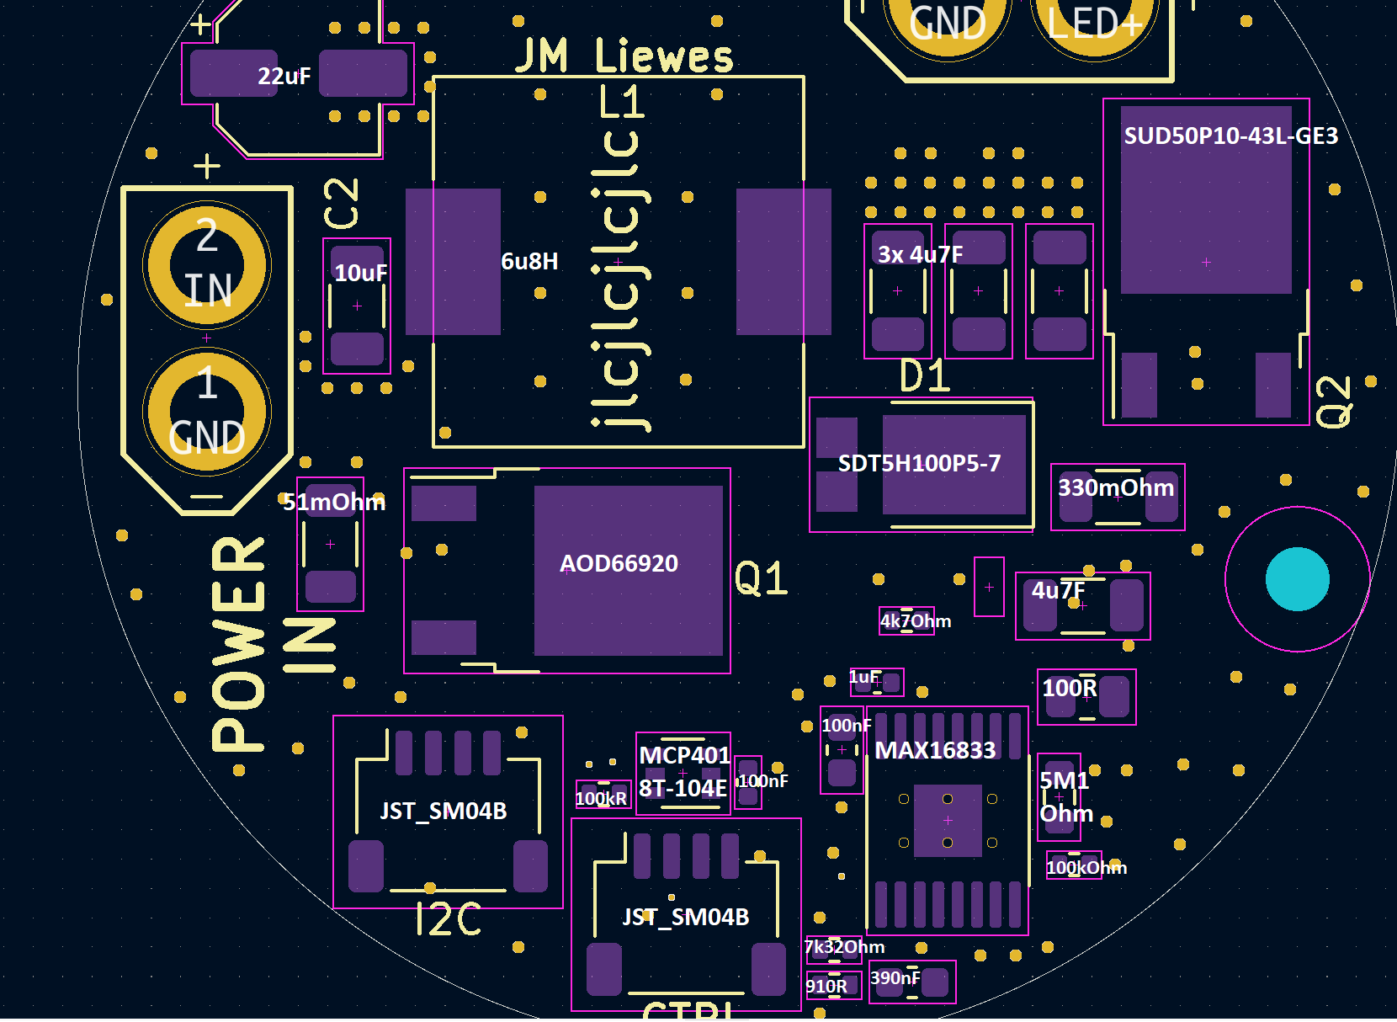
Assembly help/LEDDriver.png
