Eldalote/Divelamp/KiCadProject/OptionalOuterUSB/OuterUSB.kicad_pcb

## KiCad design KiCadProject/OptionalOuterUSB/OuterUSB.kicad_pcb (2023-03-17)

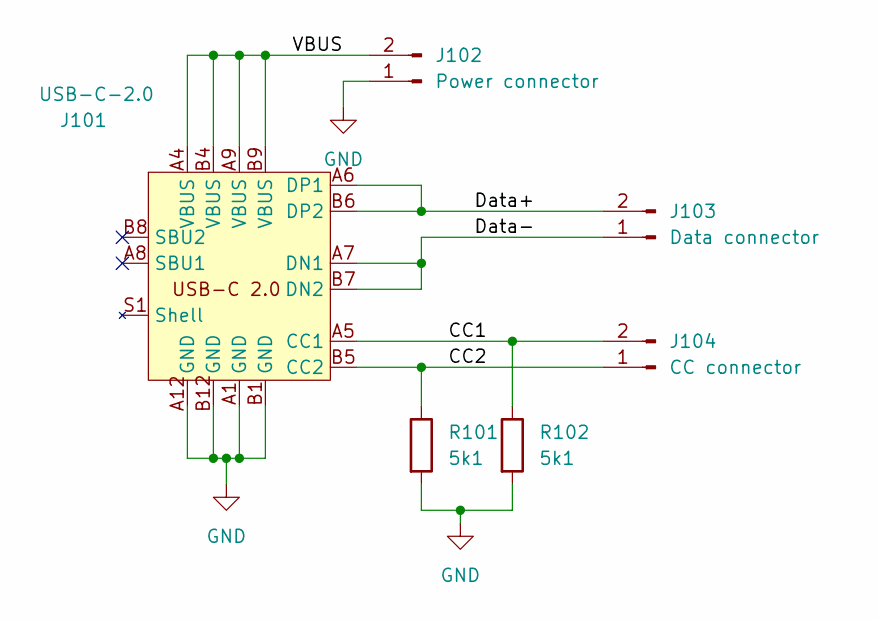
[picture p53: schematic OuterUSB.kicad_sch, Optional External USB-C connector]

Parts:
J101: USB-C-2.0; MOLEX_2130830005
J102: Power connector; PinHeader_1x02_P2.54mm_Vertical
J103: Data connector; PinHeader_1x02_P1.27mm_Vertical
J104: CC connector; PinHeader_1x02_P1.27mm_Vertical
R101, R102: 5k1; R_0402_1005Metric

Connections:
/CC1: J101.A5 (CC1), J104.2, R102.1
/CC2: J101.B5 (CC2), J104.1, R101.1
/Data+: J101.A6 (DP1), J101.B6 (DP2), J103.2
/Data-: J101.A7 (DN1), J101.B7 (DN2), J103.1
/VBUS: J101.A4 (VBUS), J101.A9 (VBUS), J101.B4 (VBUS), J101.B9 (VBUS), J102.2
GND: J101.A1 (GND), J101.A12 (GND), J101.B1 (GND), J101.B12 (GND), J102.1, R101.2, R102.2

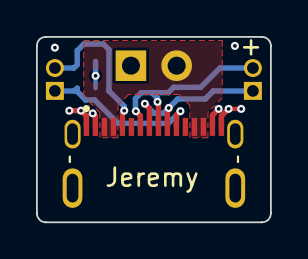
[picture p54: board OuterUSB.kicad_pcb from above]

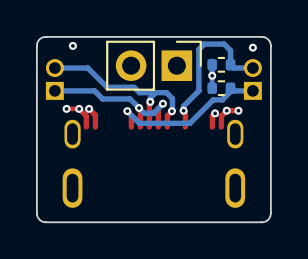
[picture p55: board OuterUSB.kicad_pcb from below]

Board: 4 copper layers, 13.0 x 10.3 mm, 6 parts (4 on the bottom side), 6 nets.
