Eldalote/Divelamp/KiCadProject/LEDDriverBoard/Powerboard.kicad_pcb

## KiCad design KiCadProject/LEDDriverBoard/Powerboard.kicad_pcb (2023-02-06)

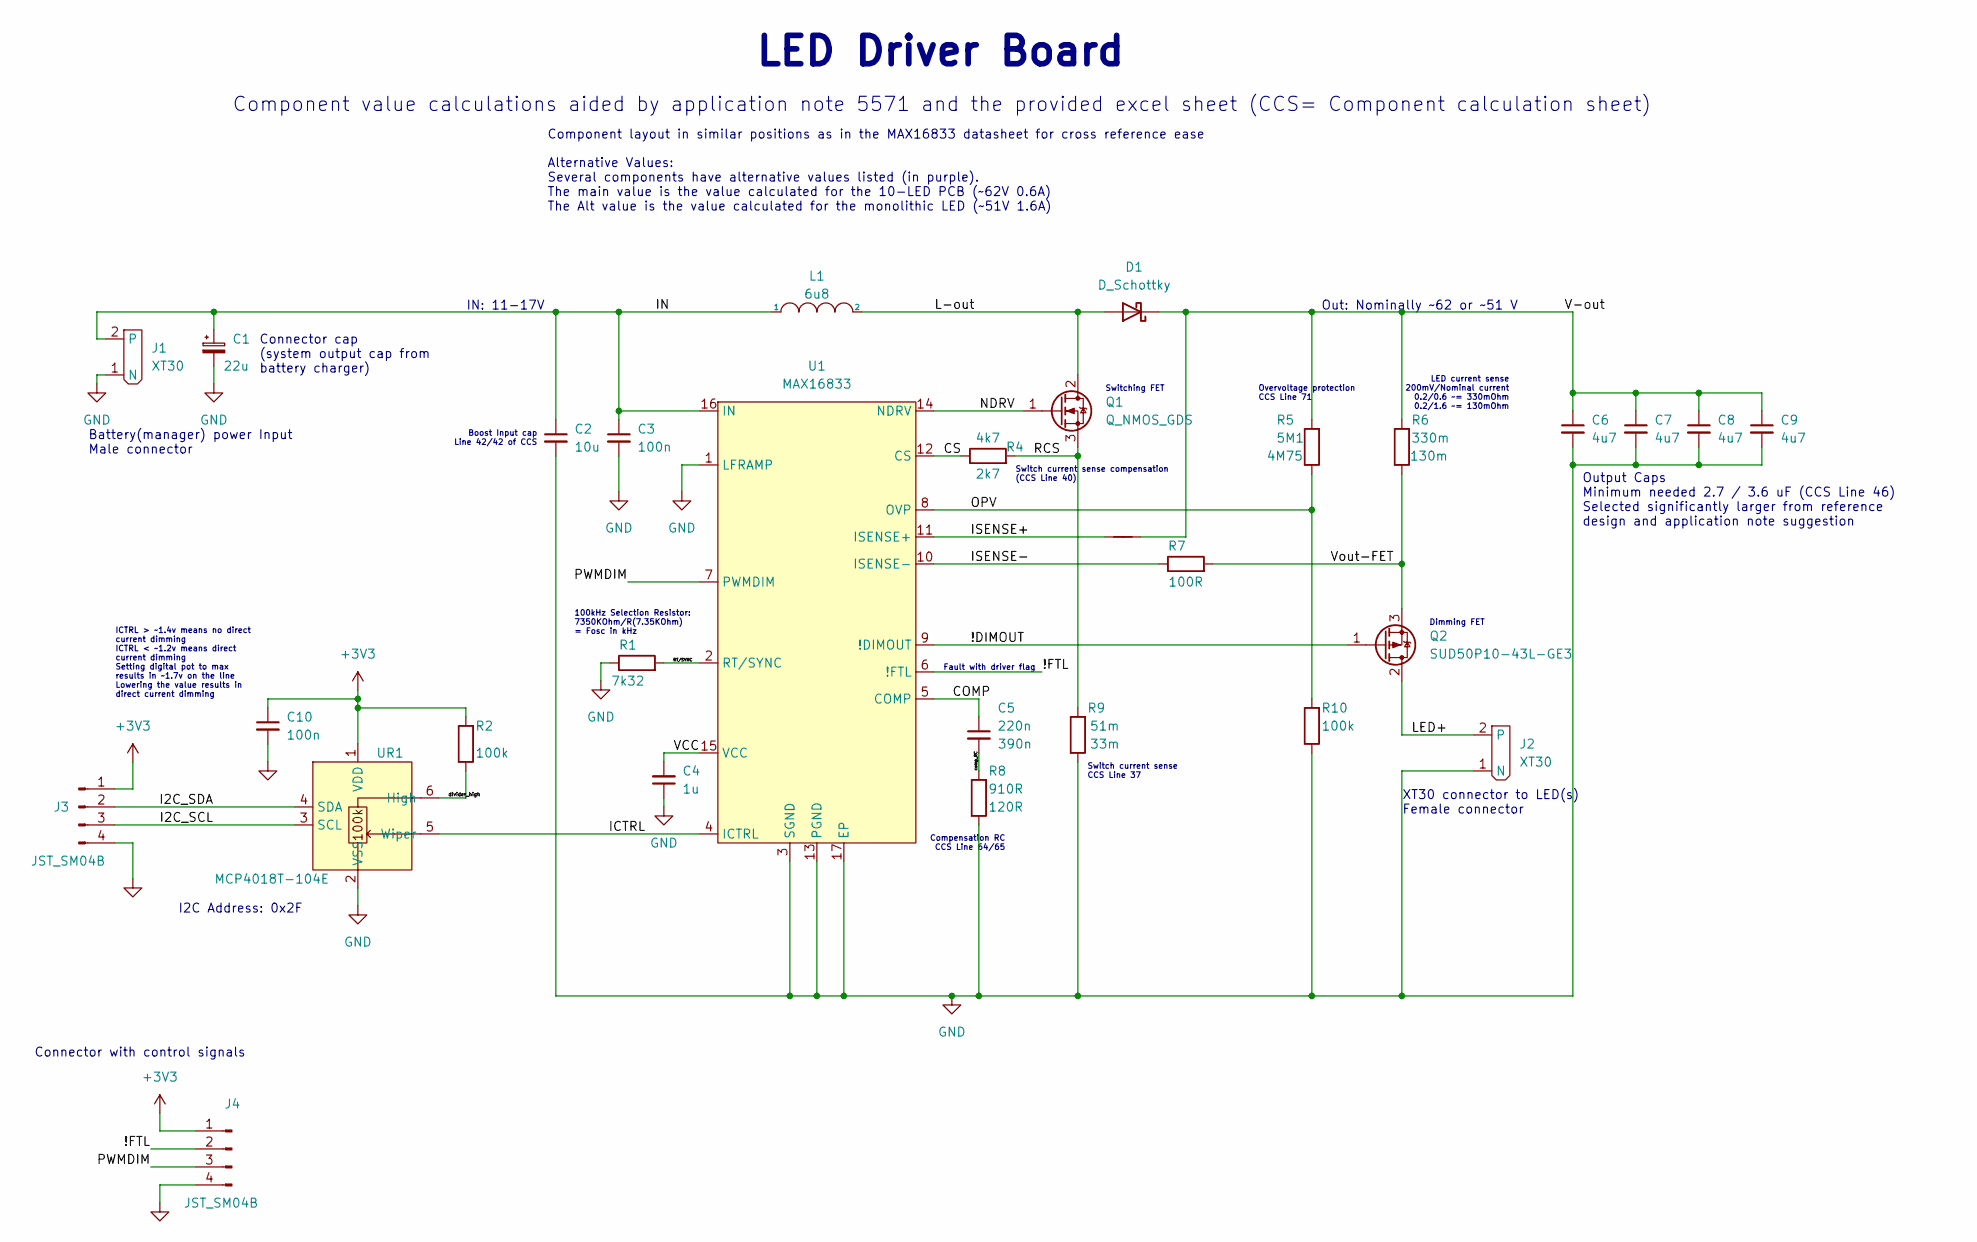
[picture p56: schematic Powerboard.kicad_sch, LED Driver Board]

Parts:
C1: 22u; CP_Elec_5x5.3
C2: 10u; C_1206_3216Metric
C3: 100n; C_0603_1608Metric
C4: 1u; C_0402_1005Metric
C5: 220n; C_0603_1608Metric
C6, C7, C8, C9: 4u7; C_1206_3216Metric
C10: 100n; C_0402_1005Metric
D1: D_Schottky; D_PowerDI-5
J1: XT30
J2: XT30; XT30_Female
J3, J4: JST_SM04B; JST_SH_SM04B-SRSS-TB_1x04-1MP_P1.00mm_Horizontal
L1: 6u8; SRP-1265C
NT1: NetTie_2; NetTie-2_SMD_Pad0.5mm
Q1: Q_NMOS_GDS; TO-252-2
Q2: SUD50P10-43L-GE3; TO-252-2
R1: 7k32; R_0402_1005Metric
R2, R10: 100k; R_0402_1005Metric
R4: 4k7; R_0402_1005Metric
R5: 5M1; R_0603_1608Metric
R6: 330m; R_1206_3216Metric
R7: 100R; R_0805_2012Metric
R8: 910R; R_0402_1005Metric
R9: 51m; R_1206_3216Metric
U1: MAX16833; HTSSOP-16-1EP_4.4x5mm_P0.65mm_EP3.4x5mm_Mask2.46x2.31mm_The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
UR1: MCP4018T-104E; SOT-363_SC-70-6

Connections:
+3V3: C10.1, J3.1, J4.1, R2.2, UR1.1 (VDD)
/!DIMOUT: Q2.1 (G), U1.9 (!DIMOUT)
/!FTL: J4.2, U1.6 (!FTL)
/COMP: C5.1, U1.5 (COMP)
/CS: R4.1, U1.12 (CS)
/I2C_SCL: J3.3, UR1.3 (SCL)
/I2C_SDA: J3.2, UR1.4 (SDA)
/ICTRL: U1.4 (ICTRL), UR1.5 (Wiper)
/IN: C1.1, C2.1, C3.1, J1.2, L1.1, U1.16 (IN)
/ISENSE+: NT1.1, U1.11 (ISENSE+)
/ISENSE-: R7.1, U1.10 (ISENSE-)
/L-out: D1.2 (A), L1.2, Q1.2 (D)
/LED+: J2.2, Q2.2 (D)
/NDRV: Q1.1 (G), U1.14 (NDRV)
/OPV: R5.1, R10.2, U1.8 (OVP)
/PWMDIM: J4.3, U1.7 (PWMDIM)
/RCS: Q1.3 (S), R4.2, R9.2
/RT/SYNC: R1.2, U1.2 (RT/SYNC)
/V-out: C6.1, C7.1, C8.1, C9.1, D1.1 (K), NT1.2, R5.2, R6.2
/VCC: C4.2, U1.15 (VCC)
/Vout-FET: Q2.3 (S), R6.1, R7.2
/comp_RC: C5.2, R8.2
/divider_high: R2.1, UR1.6 (High)
GND: C1.2, C2.2, C3.2, C4.1, C6.2, C7.2, C8.2, C9.2, C10.2, J1.1 (N), J2.1 (N), J3.4, J4.4, R1.1, R8.1, R9.1, R10.1, U1.1 (LFRAMP), U1.3 (SGND), U1.13 (PGND), U1.17 (EP), UR1.2 (VSS)

Notes on the sheet:
Switch current sense CCS Line 37
Connector cap (system output cap from battery charger)
ICTRL > ~1.4v means no direct current dimming ICTRL < ~1.2v means direct current dimming Setting digital pot to max results in ~1.7v on the line Lowering the value results in direct current dimming
LED current sense 200mV/Nominal current 0.2/0.6 ~= 330mOhm 0.2/1.6 ~= 130mOhm
Compensation RC CCS Line 64/65
Dimming FET
Fault with driver flag
XT30 connector to LED(s) Female connector
Switch current sense compensation (CCS Line 40)
Out: Nominally ~62 or ~51 V
Connector with control signals
I2C Address: 0x2F
Switching FET
Overvoltage protection CCS Line 71
Output Caps Minimum needed 2.7 / 3.6 uF (CCS Line 46) Selected significantly larger from reference design and application note suggestion
LED Driver Board
Component value calculations aided by application note 5571 and the provided excel sheet (CCS= Component calculation sheet)
IN: 11-17V
Alternative Values: Several components have alternative values listed (in purple). The main value is the value calculated for the 10-LED PCB (~62V 0.6A) The Alt value is the value calculated for the monolithic LED (~51V 1.6A)
Boost Input cap Line 42/42 of CCS
Component layout in similar positions as in the MAX16833 datasheet for cross reference ease
100kHz Selection Resistor: 7350KOhm/R(7.35KOhm) = Fosc in kHz
Battery(manager) power Input Male connector

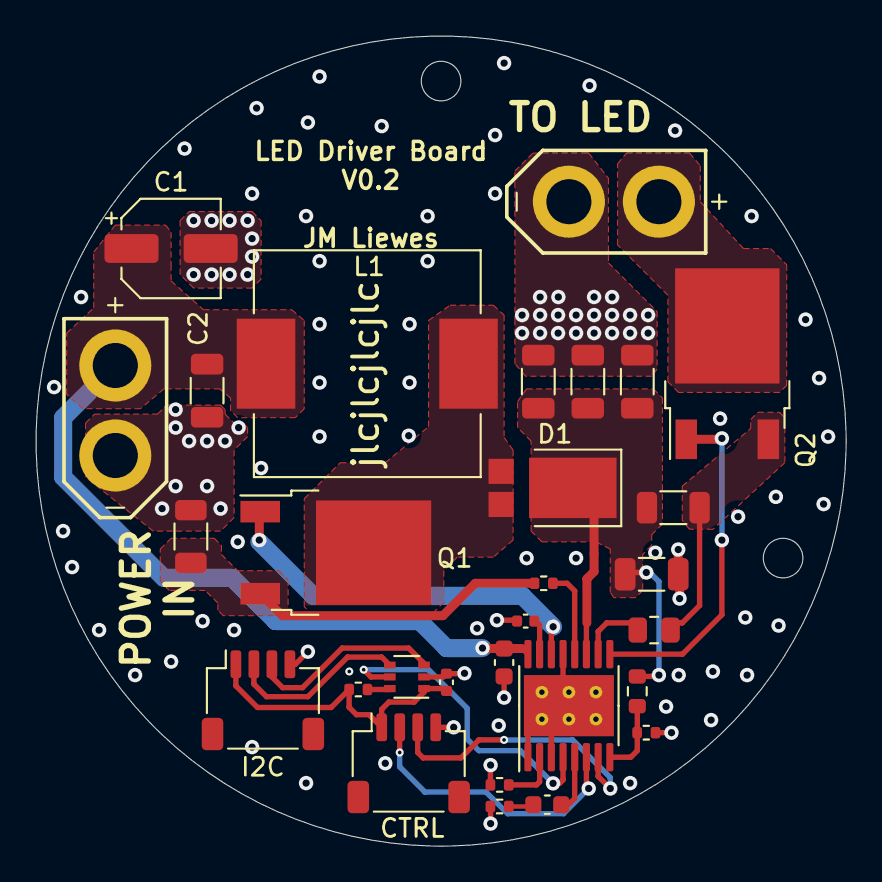
[picture p57: board Powerboard.kicad_pcb from above]

Board: 4 copper layers, 45.0 x 45.0 mm, 30 parts (0 on the bottom side), 24 nets.
