Eldalote/Divelamp/KiCadProject/ESPBoard/ESPBoard.kicad_pcb

## KiCad design KiCadProject/ESPBoard/ESPBoard.kicad_pcb (2023-02-06)

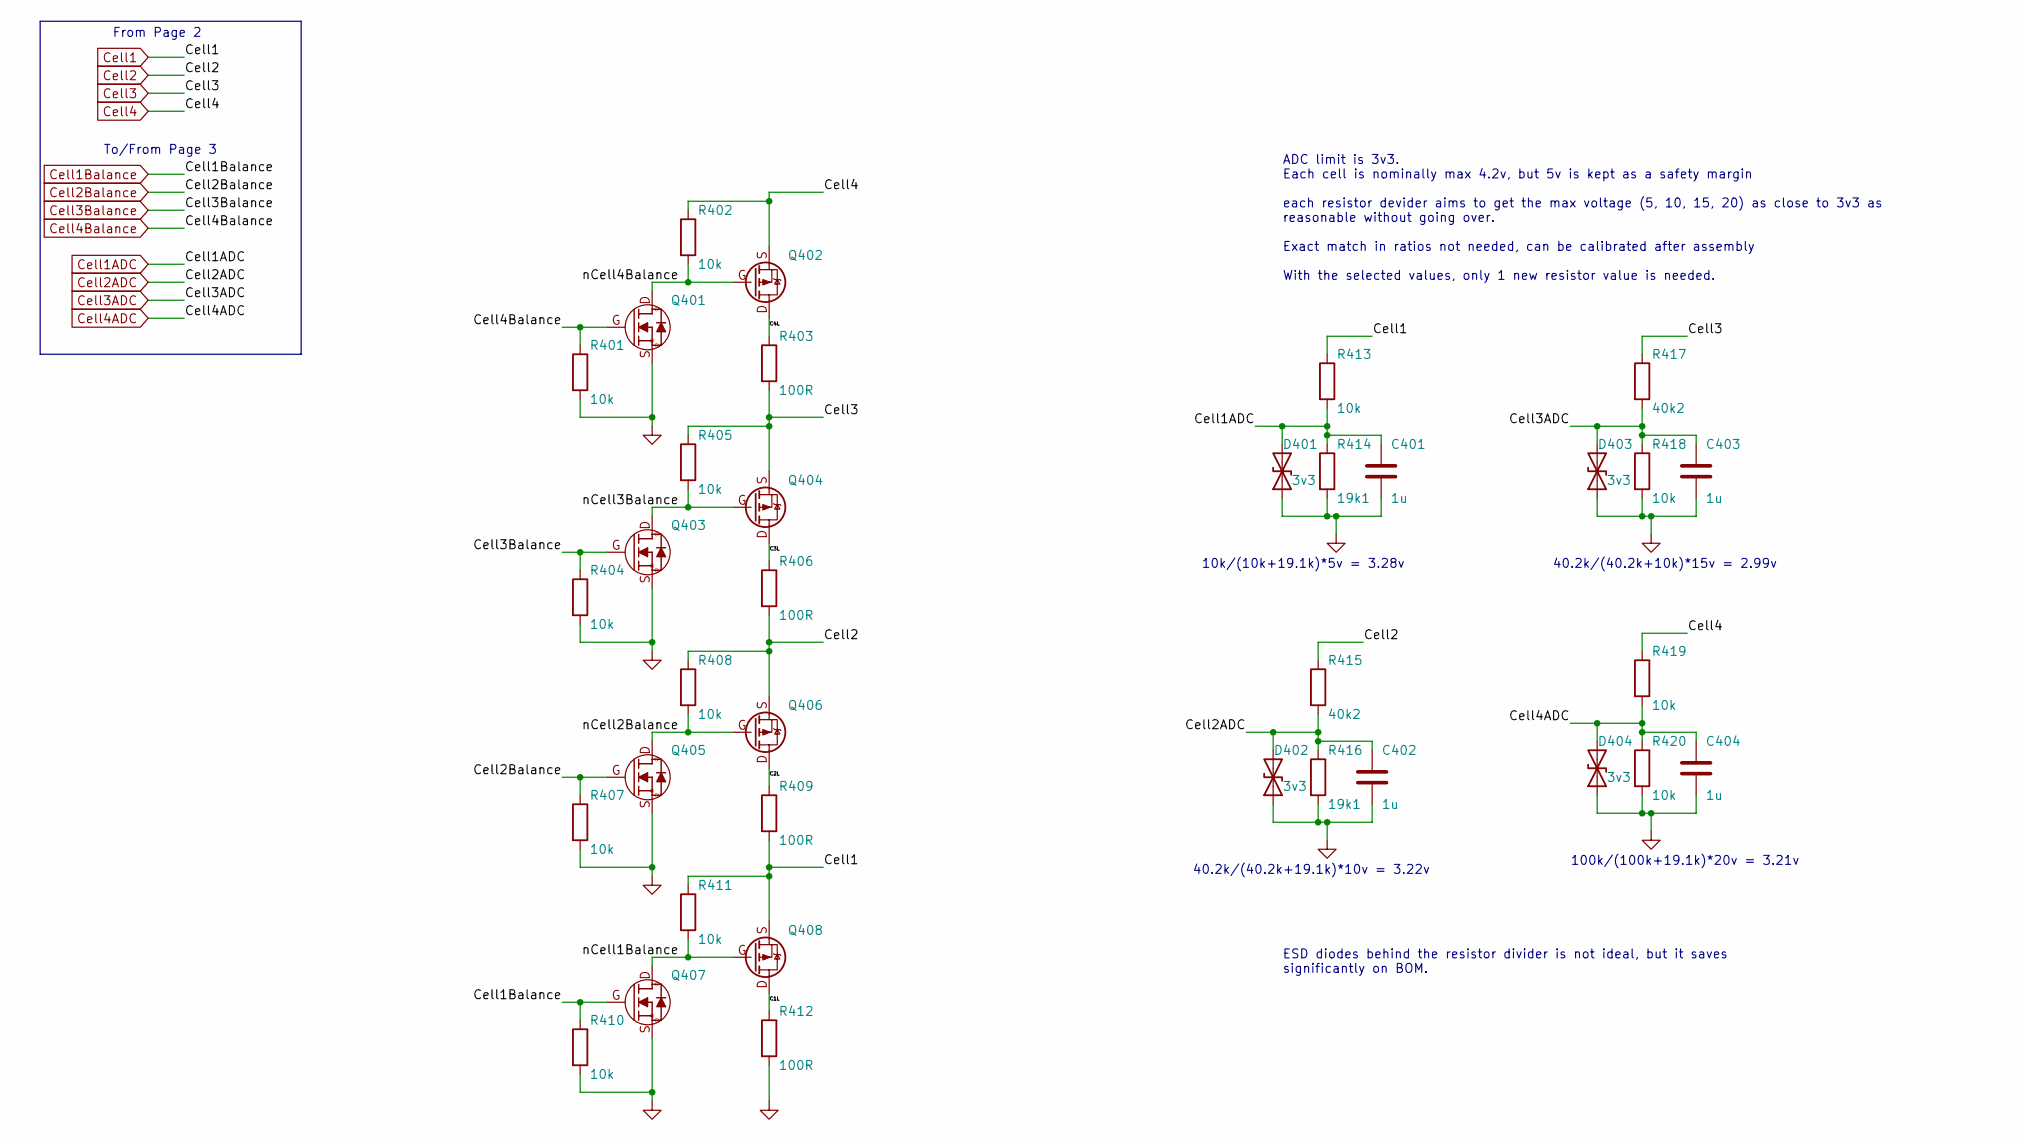
[picture p58: schematic P4SenseBalancing.kicad_sch, ESP & Feedback Board]

Parts:
C401, C402, C403, C404: 1u; C_0603_1608Metric
D401, D402, D403, D404: 3v3; D_SOD-523
Q401, Q403, Q405, Q407: NFET_Gatenames; SC-89(GSD)
Q402, Q404, Q406, Q408: PMOS_Gatenames; SOT-723(GSD)
R401, R402, R404, R405, R407, R408, R410, R411, R413, R418, R419, R420: 10k; R_0402_1005Metric
R403, R406, R409, R412: 100R; R_0805_2012Metric
R414, R416: 19k1; R_0402_1005Metric
R415, R417: 40k2; R_0402_1005Metric

Connections:
/P4 Batsense-Balancing/C1L: Q408.D, R412.1
/P4 Batsense-Balancing/C2L: Q406.D, R409.1
/P4 Batsense-Balancing/C3L: Q404.D, R406.1
/P4 Batsense-Balancing/C4L: Q402.D, R403.1
/P4 Batsense-Balancing/nCell1Balance: Q407.D, Q408.G, R411.2
/P4 Batsense-Balancing/nCell2Balance: Q405.D, Q406.G, R408.2
/P4 Batsense-Balancing/nCell3Balance: Q403.D, Q404.G, R405.2
/P4 Batsense-Balancing/nCell4Balance: Q401.D, Q402.G, R402.2
Cell1: Q408.S, R409.2, R411.1, R413.1; also elsewhere on the board
Cell1ADC: C401.1, D401.2 (A2), R413.2, R414.1; also elsewhere on the board
Cell1Balance: Q407.G, R410.1; also elsewhere on the board
Cell2: Q406.S, R406.2, R408.1, R415.1; also elsewhere on the board
Cell2ADC: C402.1, D402.2 (A2), R415.2, R416.1; also elsewhere on the board
Cell2Balance: Q405.G, R407.1; also elsewhere on the board
Cell3: Q404.S, R403.2, R405.1, R417.1; also elsewhere on the board
Cell3ADC: C403.1, D403.2 (A2), R417.2, R418.1; also elsewhere on the board
Cell3Balance: Q403.G, R404.1; also elsewhere on the board
Cell4: Q402.S, R402.1, R419.1; also elsewhere on the board
Cell4ADC: C404.1, D404.2 (A2), R419.2, R420.1; also elsewhere on the board
Cell4Balance: Q401.G, R401.1; also elsewhere on the board
GND: C401.2, C402.2, C403.2, C404.2, D401.1 (A1), D402.1 (A1), D403.1 (A1), D404.1 (A1), Q401.S, Q403.S, Q405.S, Q407.S, R401.2, R404.2, R407.2, R410.2, R412.2, R414.2, R416.2, R418.2, R420.2; also elsewhere on the board

Notes on the sheet:
10k/(10k+19.1k)*5v = 3.28v
40.2k/(40.2k+10k)*15v = 2.99v
40.2k/(40.2k+19.1k)*10v = 3.22v
100k/(100k+19.1k)*20v = 3.21v
ADC limit is 3v3. Each cell is nominally max 4.2v, but 5v is kept as a safety margin each resistor devider aims to get the max voltage (5, 10, 15, 20) as close to 3v3 as reasonable without going over. Exact match in ratios not needed, can be calibrated after assembly With the selected values, only 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
From Page 2
ESD diodes behind the resistor divider is not ideal, but it saves significantly on BOM.
To/From Page 3

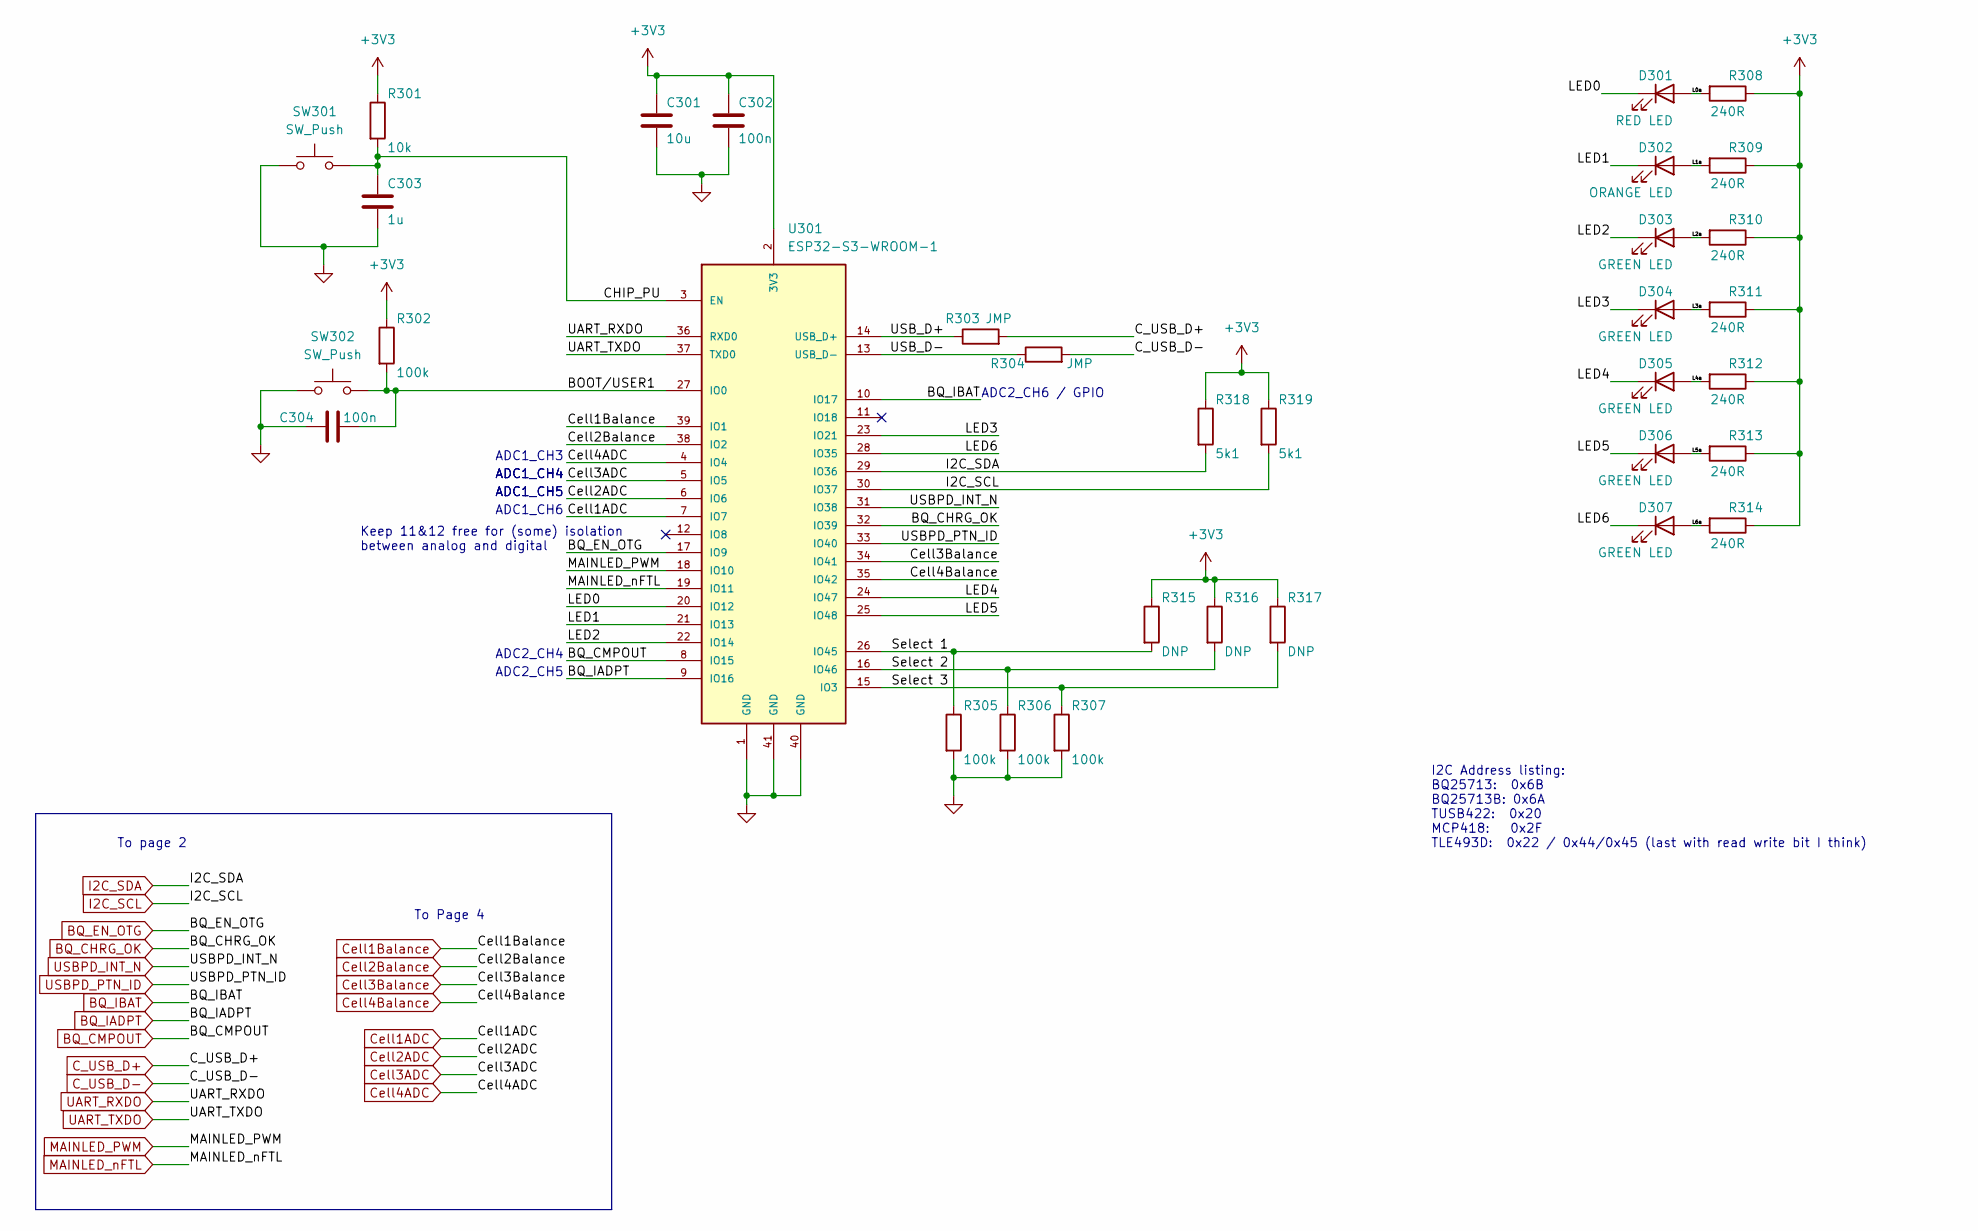
[picture p59: schematic P3ESP32.kicad_sch, ESP & Feedback Board]

Parts:
C301: 10u; C_0805_2012Metric
C302, C304: 100n; C_0402_1005Metric
C303: 1u; C_0603_1608Metric
D301: RED LED; LED_0805_2012Metric
D302: ORANGE LED; LED_0805_2012Metric
D303, D304, D305, D306, D307: GREEN LED; LED_0805_2012Metric
R301: 10k; R_0402_1005Metric
R302, R305, R306, R307: 100k; R_0402_1005Metric
R303, R304: JMP; R_0402_1005Metric
R308, R309, R310, R311, R312, R313, R314: 240R; R_0402_1005Metric
R315, R316, R317: DNP; R_0402_1005Metric
R318, R319: 5k1; R_0402_1005Metric
SW301, SW302: SW_Push; SW_Push_1P1T_NO_6x6mm_H9.5mm
U301: ESP32-S3-WROOM-1; XCVR_ESP32-S3-WROOM-1

Connections:
+3V3: C301.1, C302.1, R301.1, R302.1, R308.1, R309.1, R310.1, R311.1, R312.1, R313.1, R314.1, R315.1, R316.1, R317.1, R318.1, R319.1, U301.2 (3V3); also elsewhere on the board
/P3 ESP32/BOOT/USER1: C304.2, R302.2, SW302.2, U301.27 (IO0)
/P3 ESP32/CHIP_PU: C303.1, R301.2, SW301.2, U301.3 (EN)
/P3 ESP32/L0a: D301.2 (A), R308.2
/P3 ESP32/L1a: D302.2 (A), R309.2
/P3 ESP32/L2a: D303.2 (A), R310.2
/P3 ESP32/L3a: D304.2 (A), R311.2
/P3 ESP32/L4a: D305.2 (A), R312.2
/P3 ESP32/L5a: D306.2 (A), R313.2
/P3 ESP32/L6a: D307.2 (A), R314.2
/P3 ESP32/LED0: D301.1 (K), U301.20 (IO12)
/P3 ESP32/LED1: D302.1 (K), U301.21 (IO13)
/P3 ESP32/LED2: D303.1 (K), U301.22 (IO14)
/P3 ESP32/LED3: D304.1 (K), U301.23 (IO21)
/P3 ESP32/LED4: D305.1 (K), U301.24 (IO47)
/P3 ESP32/LED5: D306.1 (K), U301.25 (IO48)
/P3 ESP32/LED6: D307.1 (K), U301.28 (IO35)
/P3 ESP32/Select 1: R305.1, R315.2, U301.26 (IO45)
/P3 ESP32/Select 2: R306.1, R316.2, U301.16 (IO46)
/P3 ESP32/Select 3: R307.1, R317.2, U301.15 (IO3)
/P3 ESP32/USB_D+: R303.1, U301.14 (USB_D+)
/P3 ESP32/USB_D-: R304.1, U301.13 (USB_D-)
BQ_CHRG_OK: U301.32 (IO39); also elsewhere on the board
BQ_CMPOUT: U301.8 (IO15); also elsewhere on the board
BQ_EN_OTG: U301.17 (IO9); also elsewhere on the board
BQ_IADPT: U301.9 (IO16); also elsewhere on the board
BQ_IBAT: U301.10 (IO17); also elsewhere on the board
C_USB_D+: R303.2; also elsewhere on the board
C_USB_D-: R304.2; also elsewhere on the board
Cell1ADC: U301.7 (IO7); also elsewhere on the board
Cell1Balance: U301.39 (IO1); also elsewhere on the board
Cell2ADC: U301.6 (IO6); also elsewhere on the board
Cell2Balance: U301.38 (IO2); also elsewhere on the board
Cell3ADC: U301.5 (IO5); also elsewhere on the board
Cell3Balance: U301.34 (IO41); also elsewhere on the board
Cell4ADC: U301.4 (IO4); also elsewhere on the board
Cell4Balance: U301.35 (IO42); also elsewhere on the board
GND: C301.2, C302.2, C303.2, C304.1, R305.2, R306.2, R307.2, SW301.1, SW302.1, U301.1 (GND), U301.40 (GND), U301.41 (GND); also elsewhere on the board
I2C_SCL: R319.2, U301.30 (IO37); also elsewhere on the board
I2C_SDA: R318.2, U301.29 (IO36); also elsewhere on the board
MAINLED_PWM: U301.18 (IO10); also elsewhere on the board
MAINLED_nFTL: U301.19 (IO11); also elsewhere on the board
UART_RXDO: U301.36 (RXD0); also elsewhere on the board
UART_TXDO: U301.37 (TXD0); also elsewhere on the board
USBPD_INT_N: U301.31 (IO38); also elsewhere on the board
USBPD_PTN_ID: U301.33 (IO40); also elsewhere on the board

Notes on the sheet:
ADC1_CH4
To page 2
I2C Address listing: BQ25713: 0x6B BQ25713B: 0x6A TUSB422: 0x20 MCP418: 0x2F TLE493D: 0x22 / 0x44/0x45 (last with read write bit I think)
To Page 4
ADC1_CH5
ADC1_CH3
ADC2_CH4
ADC2_CH5
Keep 11&12 free for (some) isolation between analog and digital
ADC2_CH6 / GPIO
ADC1_CH6

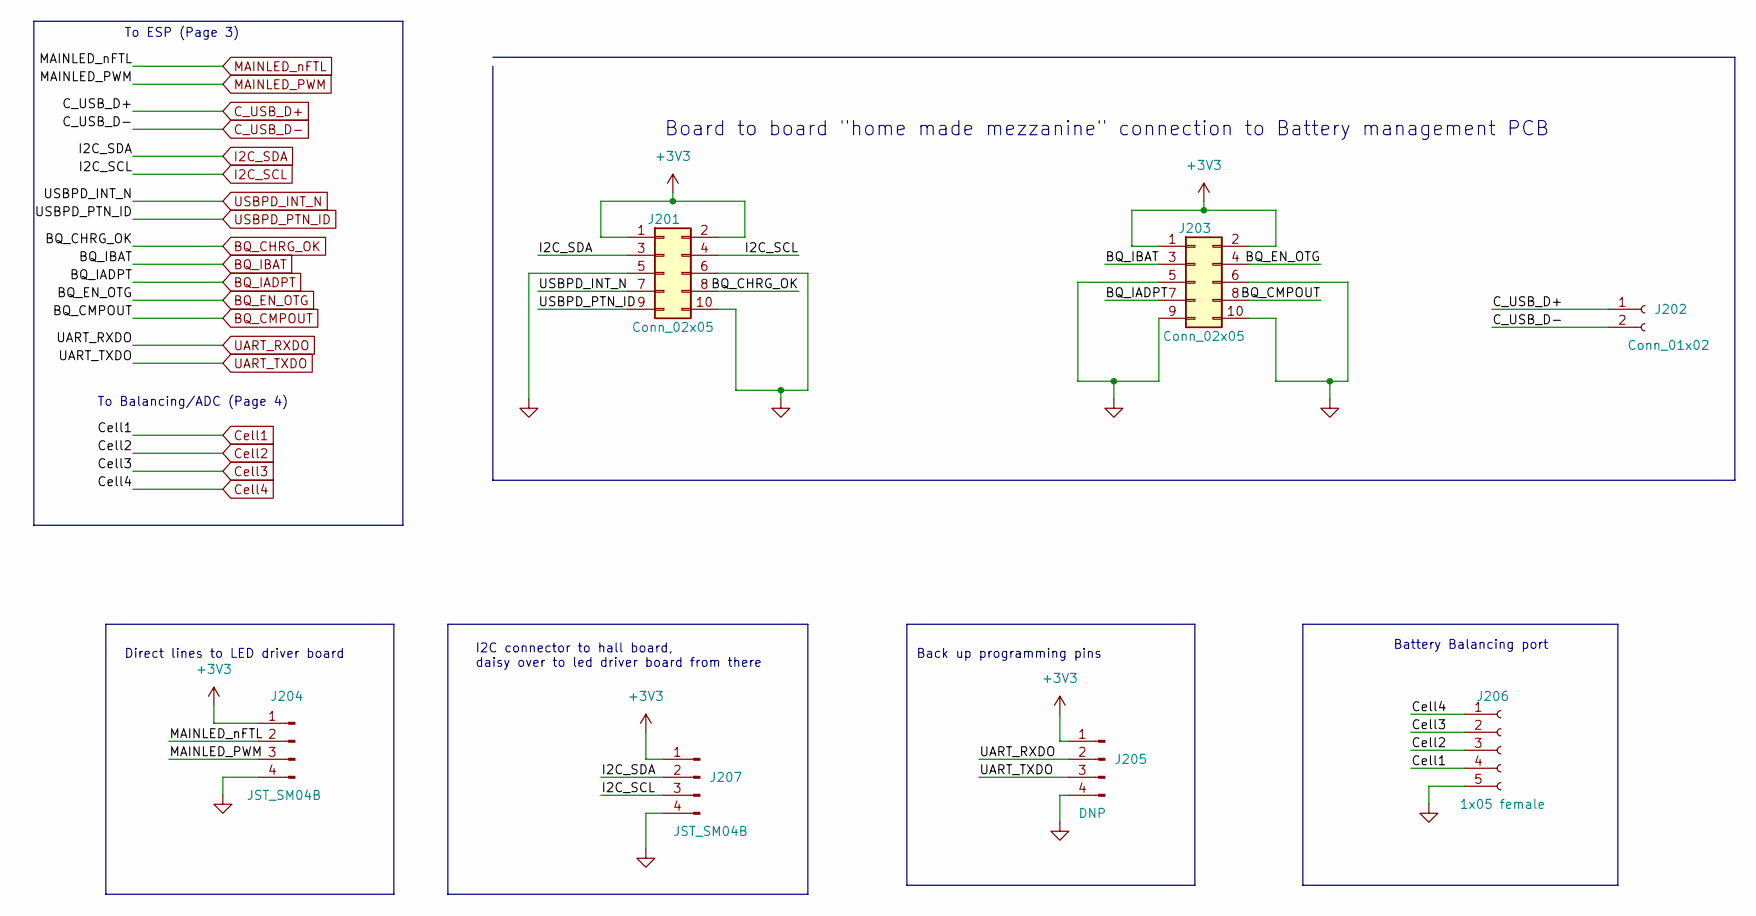
[picture p60: schematic P2Connectos.kicad_sch, ESP & Feedback Board]

Parts:
J201, J203: Conn_02x05; PinSocket_2x05_P1.27mm_Vertical_SMD
J202: Conn_01x02; PinSocket_1x02_P1.27mm_Vertical_SMD_Pin1Left
J204, J207: JST_SM04B; JST_SH_SM04B-SRSS-TB_1x04-1MP_P1.00mm_Horizontal
J205: DNP; PinHeader_2x02_P1.27mm_Vertical_SMD
J206: 1x05 female; PinSocket_1x05_P1.27mm_Vertical_SMD_Pin1Left

Connections:
+3V3: J201.1, J201.2, J203.1, J203.2, J204.1, J205.1, J207.1; also elsewhere on the board
BQ_CHRG_OK: J201.8; also elsewhere on the board
BQ_CMPOUT: J203.8; also elsewhere on the board
BQ_EN_OTG: J203.4; also elsewhere on the board
BQ_IADPT: J203.7; also elsewhere on the board
BQ_IBAT: J203.3; also elsewhere on the board
C_USB_D+: J202.1; also elsewhere on the board
C_USB_D-: J202.2; also elsewhere on the board
Cell1: J206.4; also elsewhere on the board
Cell2: J206.3; also elsewhere on the board
Cell3: J206.2; also elsewhere on the board
Cell4: J206.1; also elsewhere on the board
GND: J201.5, J201.6, J201.10, J203.5, J203.6, J203.9, J203.10, J204.4, J205.4, J206.5, J207.4; also elsewhere on the board
I2C_SCL: J201.4, J207.3; also elsewhere on the board
I2C_SDA: J201.3, J207.2; also elsewhere on the board
MAINLED_PWM: J204.3; also elsewhere on the board
MAINLED_nFTL: J204.2; also elsewhere on the board
UART_RXDO: J205.2; also elsewhere on the board
UART_TXDO: J205.3; also elsewhere on the board
USBPD_INT_N: J201.7; also elsewhere on the board
USBPD_PTN_ID: J201.9; also elsewhere on the board

Notes on the sheet:
To ESP (Page 3)
Back up programming pins
To Balancing/ADC (Page 4)
Board to board "home made mezzanine" connection to Battery management PCB
Battery Balancing port
I2C connector to hall board, daisy over to led driver board from there
Direct lines to LED driver board

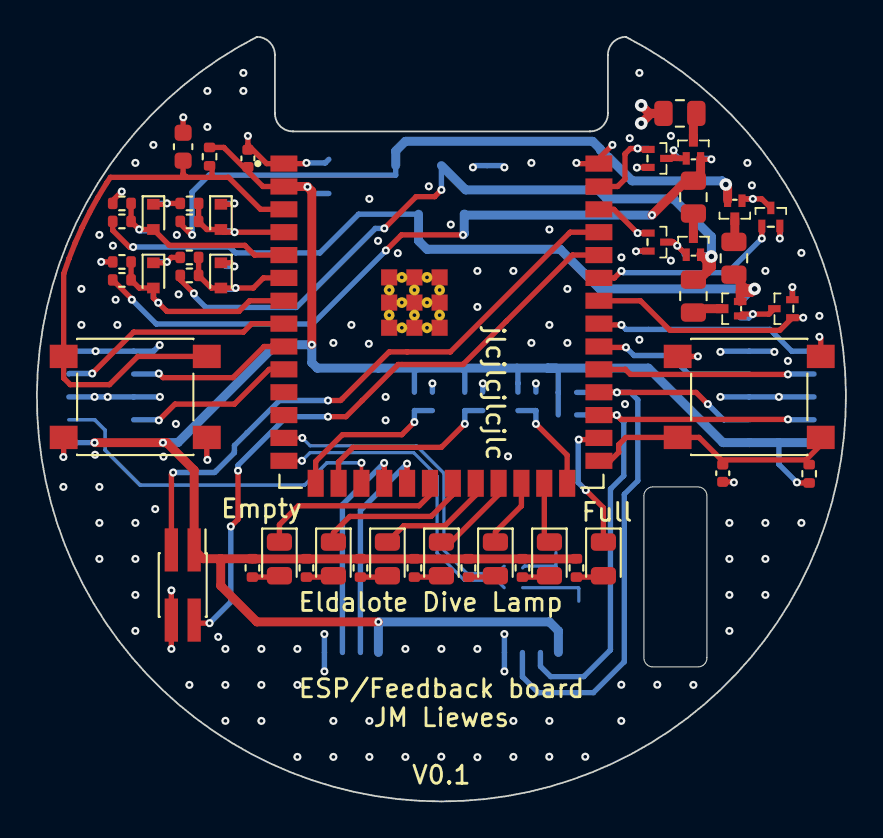
[picture p61: board ESPBoard.kicad_pcb from above]

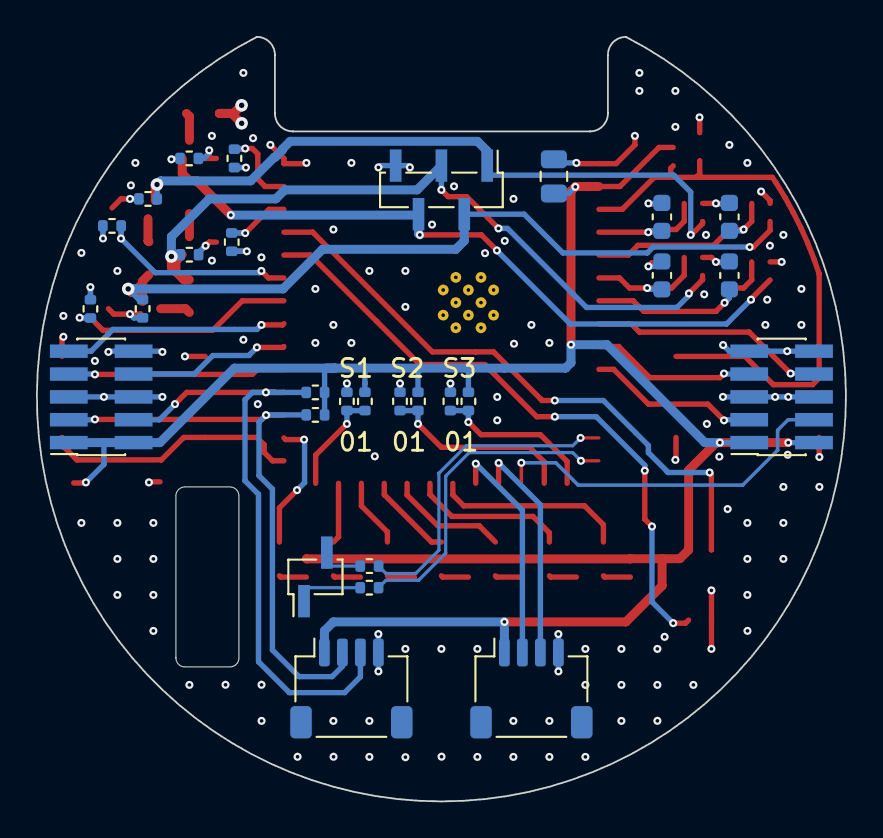
[picture p62: board ESPBoard.kicad_pcb from below]

Board: 4 copper layers, 44.9 x 42.5 mm, 76 parts (29 on the bottom side), 58 nets.
