Eldalote/Divelamp/KiCadProject/BatteryManagementBoard/BatteryManagementBoard.kicad_pcb

## KiCad design KiCadProject/BatteryManagementBoard/BatteryManagementBoard.kicad_pcb (2023-02-06)

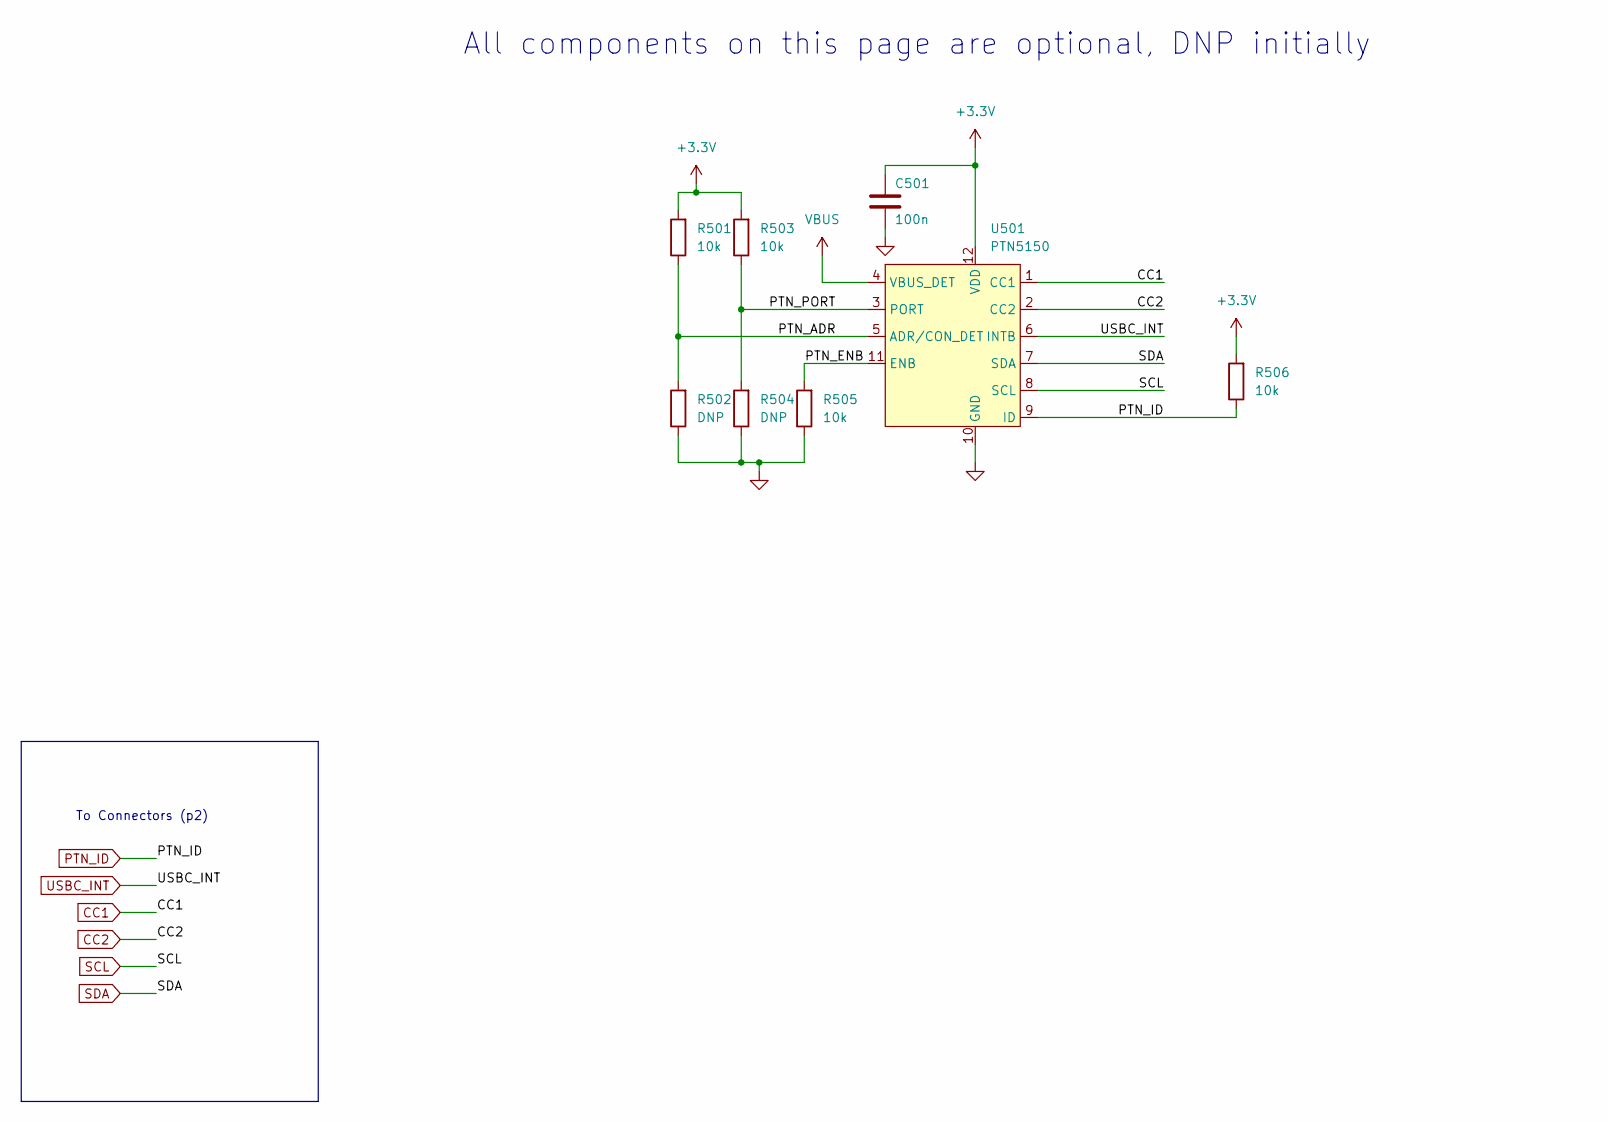
[picture p63: schematic P5PTN5150.kicad_sch]

Parts:
C501: 100n; C_0402_1005Metric
R501, R503, R505, R506: 10k; R_0402_1005Metric
R502, R504: DNP; R_0402_1005Metric
U501: PTN5150; Texas_X2QFN-12_1.6x1.6mm_P0.4mm

Connections:
+3.3V: C501.1, R501.2, R503.2, R506.2, U501.12 (VDD); also elsewhere on the board
/P5-PTN5150 (Optional)/PTN_ADR: R501.1, R502.2, U501.5 (ADR/CON_DET)
/P5-PTN5150 (Optional)/PTN_ENB: R505.2, U501.11 (ENB)
/P5-PTN5150 (Optional)/PTN_PORT: R503.1, R504.2, U501.3 (PORT)
CC1: U501.1 (CC1); also elsewhere on the board
CC2: U501.2 (CC2); also elsewhere on the board
GND: C501.2, R502.1, R504.1, R505.1, U501.10 (GND); also elsewhere on the board
PTN_ID: R506.1, U501.9 (ID); also elsewhere on the board
SCL: U501.8 (SCL); also elsewhere on the board
SDA: U501.7 (SDA); also elsewhere on the board
USBC_INT: U501.6 (INTB); also elsewhere on the board
VBUS: U501.4 (VBUS_DET); also elsewhere on the board

Notes on the sheet:
All components on this page are optional, DNP initially
To Connectors (p2)
