Eldalote/Divelamp/KiCadProject/BatteryManagementBoard/BatteryManagementBoard.kicad_pcb

## KiCad design KiCadProject/BatteryManagementBoard/BatteryManagementBoard.kicad_pcb (continued)

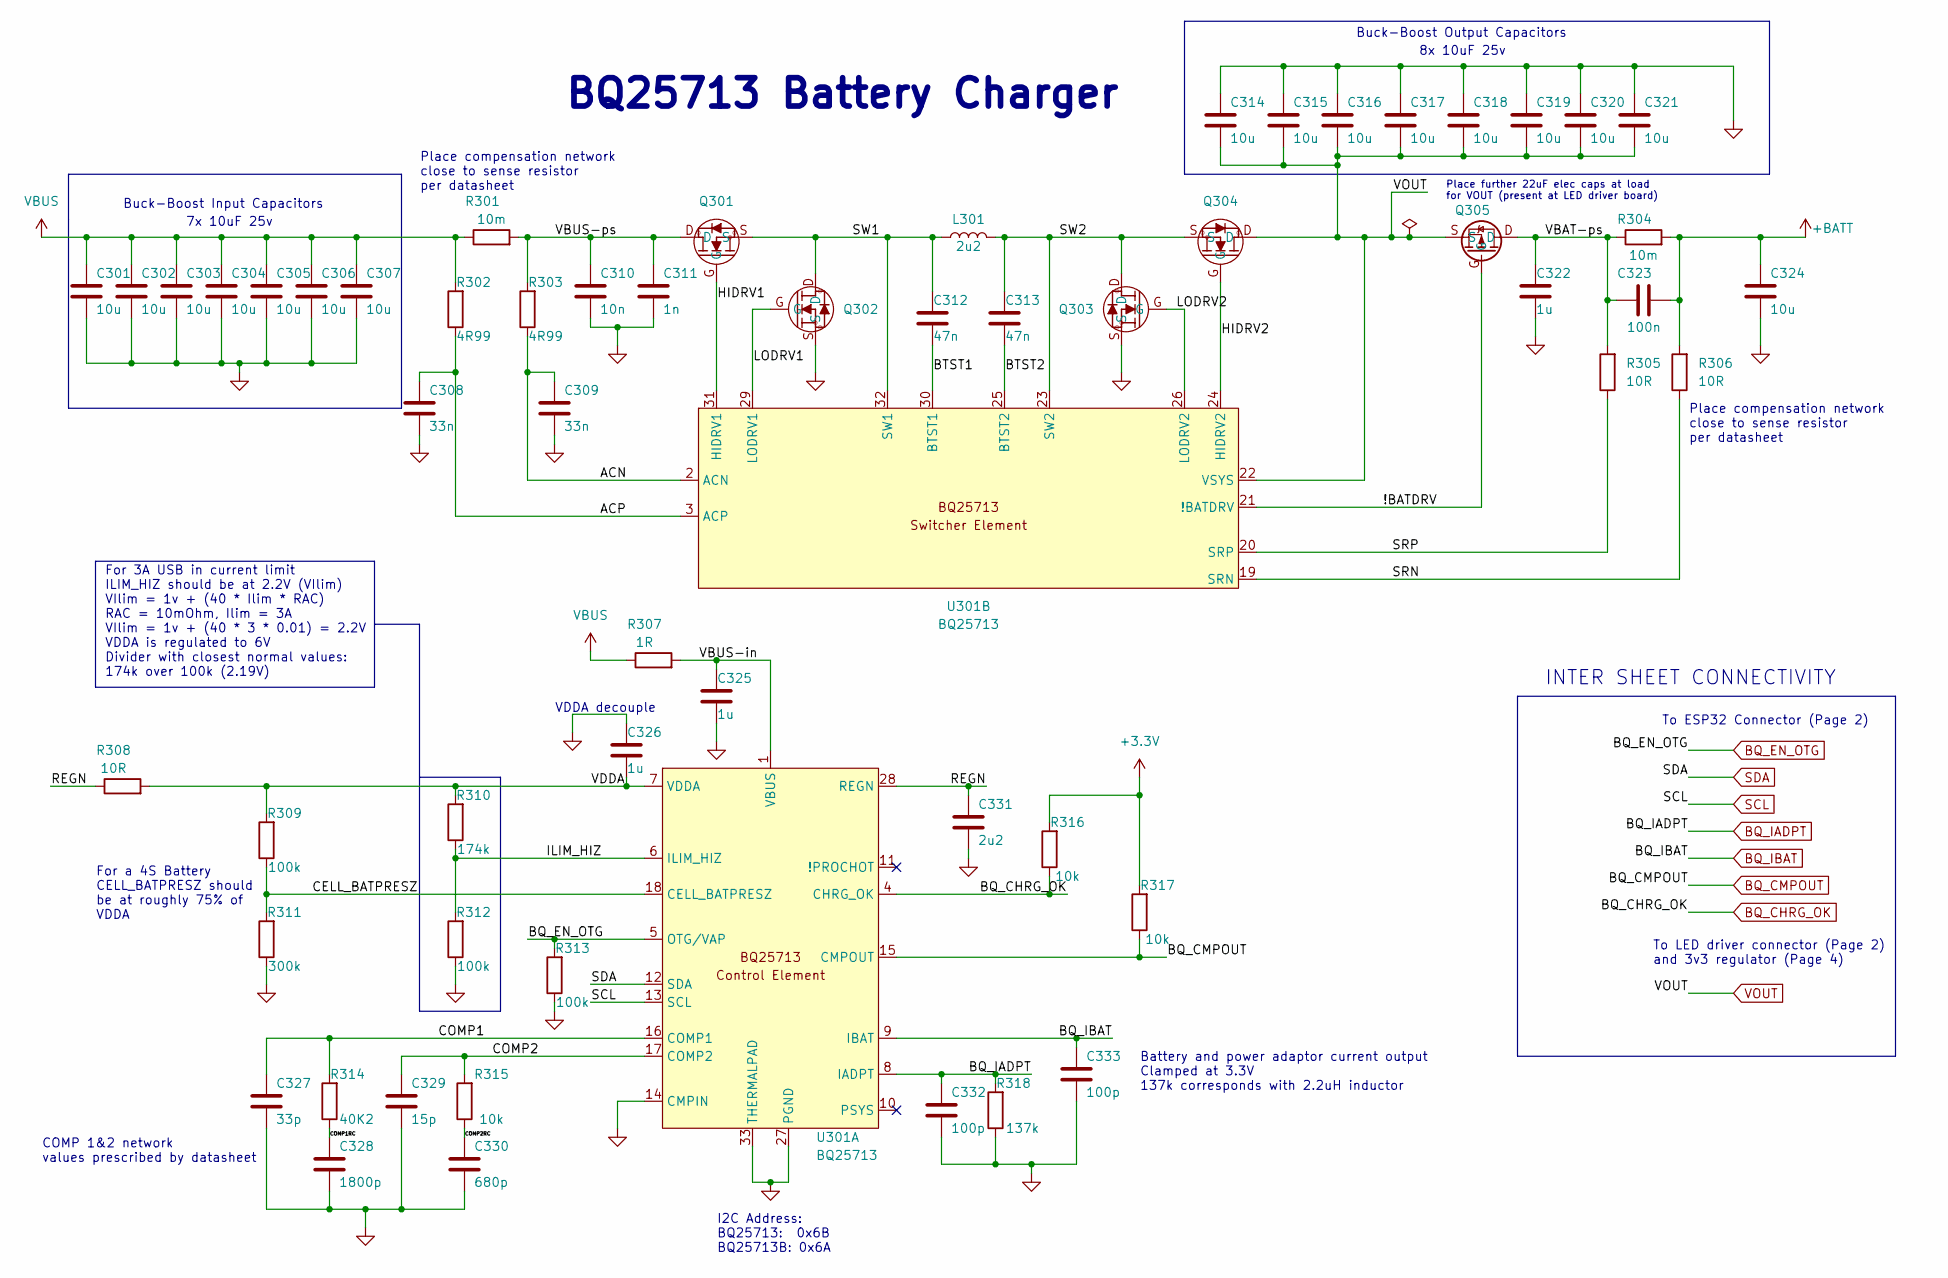
[picture p64: schematic P3Charger.kicad_sch]

Parts:
C301, C302, C303, C304, C305, C306, C307, C314, C315, C316, C317, C318, C319, C320, C321, C324: 10u; C_0805_2012Metric
C308, C309: 33n; C_0402_1005Metric
C310: 10n; C_0402_1005Metric
C311: 1n; C_0402_1005Metric
C312, C313: 47n; C_0402_1005Metric
C322, C325, C326: 1u; C_0603_1608Metric
C323: 100n; C_0402_1005Metric
C327: 33p; C_0402_1005Metric
C328: 1800p; C_0402_1005Metric
C329: 15p; C_0402_1005Metric
C330: 680p; C_0402_1005Metric
C331: 2u2; C_0603_1608Metric
C332, C333: 100p; C_0402_1005Metric
L301: 2u2; SRP-1265C
Q301, Q302, Q303, Q304: NFET_Gatenames; DFN3x3A_8L_EP1_P
Q305: PMOS_Gatenames; DFN3x3A_8L_EP1_P
R301, R304: 10m; R_1206_3216Metric
R302, R303: 4R99; R_0402_1005Metric
R305, R306, R308: 10R; R_0402_1005Metric
R307: 1R; R_0603_1608Metric
R309, R312, R313: 100k; R_0402_1005Metric
R310: 174k; R_0402_1005Metric
R311: 300k; R_0402_1005Metric
R314: 40K2; R_0402_1005Metric
R315, R316, R317: 10k; R_0402_1005Metric
R318: 137k; R_0402_1005Metric
U301: BQ25713; Texas_S-PWQFN-N32_EP2.8x2.8mm

Connections:
+3.3V: R316.2, R317.2; also elsewhere on the board
+BATT: C323.2, C324.1, R304.2, R306.2; also elsewhere on the board
/P3-Charger/!BATDRV: Q305.G, U301.21 (!BATDRV)
/P3-Charger/ACN: C309.1, R303.1, U301.2 (ACN)
/P3-Charger/ACP: C308.1, R302.1, U301.3 (ACP)
/P3-Charger/BTST1: C312.2, U301.30 (BTST1)
/P3-Charger/BTST2: C313.2, U301.25 (BTST2)
/P3-Charger/CELL_BATPRESZ: R309.1, R311.2, U301.18 (CELL_BATPRESZ)
/P3-Charger/COMP1: C327.1, R314.2, U301.16 (COMP1)
/P3-Charger/COMP1RC: C328.1, R314.1
/P3-Charger/COMP2: C329.1, R315.2, U301.17 (COMP2)
/P3-Charger/COMP2RC: C330.1, R315.1
/P3-Charger/HIDRV1: Q301.G, U301.31 (HIDRV1)
/P3-Charger/HIDRV2: Q304.G, U301.24 (HIDRV2)
/P3-Charger/ILIM_HIZ: R310.1, R312.2, U301.6 (ILIM_HIZ)
/P3-Charger/LODRV1: Q302.G, U301.29 (LODRV1)
/P3-Charger/LODRV2: Q303.G, U301.26 (LODRV2)
/P3-Charger/REGN: C331.1, R308.1, U301.28 (REGN)
/P3-Charger/SRN: R306.1, U301.19 (SRN)
/P3-Charger/SRP: R305.1, U301.20 (SRP)
/P3-Charger/SW1: C312.1, L301.1, Q301.S, Q302.D, U301.32 (SW1)
/P3-Charger/SW2: C313.1, L301.2, Q303.D, Q304.S, U301.23 (SW2)
/P3-Charger/VBAT-ps: C322.1, C323.1, Q305.D, R304.1, R305.2
/P3-Charger/VBUS-in: C325.1, R307.2, U301.1 (VBUS)
/P3-Charger/VBUS-ps: C310.1, C311.1, Q301.D, R301.2, R303.2
/P3-Charger/VDDA: C326.1, R308.2, R309.2, R310.2, U301.7 (VDDA)
BQ_CHRG_OK: R316.1, U301.4 (CHRG_OK); also elsewhere on the board
BQ_CMPOUT: R317.1, U301.15 (CMPOUT); also elsewhere on the board
BQ_EN_OTG: R313.2, U301.5 (OTG/VAP); also elsewhere on the board
BQ_IADPT: C332.1, R318.2, U301.8 (IADPT); also elsewhere on the board
BQ_IBAT: C333.1, U301.9 (IBAT); also elsewhere on the board
GND: C301.2, C302.2, C303.2, C304.2, C305.2, C306.2, C307.2, C308.2, C309.2, C310.2, C311.2, C314.1, C315.1, C316.1, C317.1, C318.1, C319.1, C320.1, C321.1, C322.2, C324.2, C325.2, C326.2, C327.2, C328.2, C329.2, C330.2, C331.2, C332.2, C333.2, Q302.S, Q303.S, R311.1, R312.1, R313.1, R318.1, U301.14 (CMPIN), U301.27 (PGND), U301.33 (THERMALPAD); also elsewhere on the board
SCL: U301.13 (SCL); also elsewhere on the board
SDA: U301.12 (SDA); also elsewhere on the board
VBUS: C301.1, C302.1, C303.1, C304.1, C305.1, C306.1, C307.1, R301.1, R302.2, R307.1; also elsewhere on the board
VOUT: C314.2, C315.2, C316.2, C317.2, C318.2, C319.2, C320.2, C321.2, Q304.D, Q305.S, U301.22 (VSYS); also elsewhere on the board

Notes on the sheet:
To LED driver connector (Page 2) and 3v3 regulator (Page 4)
Buck-Boost Input Capacitors
INTER SHEET CONNECTIVITY
For a 4S Battery CELL_BATPRESZ should be at roughly 75% of VDDA
7x 10uF 25v
8x 10uF 25v
COMP 1&2 network values prescribed by datasheet
Place further 22uF elec caps at load for VOUT (present at LED driver board)
BQ25713 Battery Charger
VDDA decouple
To ESP32 Connector (Page 2)
Place compensation network close to sense resistor per datasheet
Buck-Boost Output Capacitors
Battery and power adaptor current output Clamped at 3.3V 137k corresponds with 2.2uH inductor
I2C Address: BQ25713: 0x6B BQ25713B: 0x6A
For 3A USB in current limit ILIM_HIZ should be at 2.2V (VIlim) VIlim = 1v + (40 * Ilim * RAC) RAC = 10mOhm, Ilim = 3A VIlim = 1v + (40 * 3 * 0.01) = 2.2V VDDA is regulated to 6V Divider with closest normal values: 174k over 100k (2.19V)

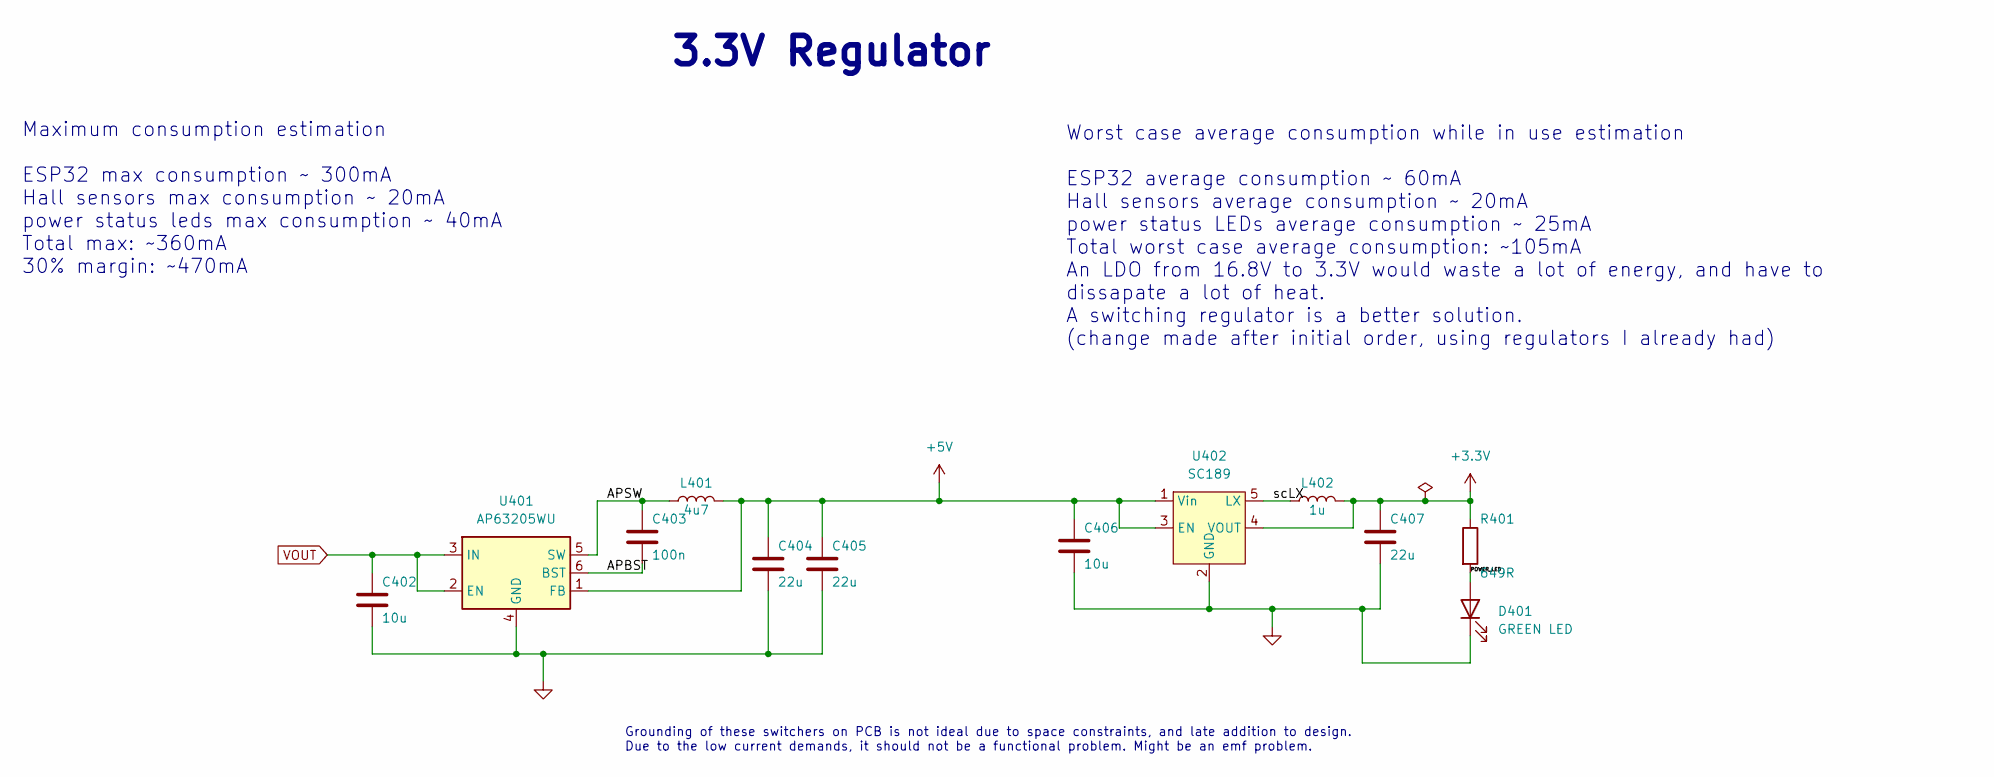
[picture p65: schematic P4LPregulator.kicad_sch]

Parts:
C402, C406: 10u; C_0805_2012Metric
C403: 100n; C_0402_1005Metric
C404, C405, C407: 22u; C_0805_2012Metric
D401: GREEN LED; LED_0805_2012Metric
L401: 4u7; L_1210_3225Metric
L402: 1u; L_1210_3225Metric
R401: 649R; R_0402_1005Metric
U401: AP63205WU; TSOT-23-6
U402: SC189; SOT-23-5

Connections:
+3.3V: C407.1, L402.2, R401.1, U402.4 (VOUT); also elsewhere on the board
+5V: C404.1, C405.1, C406.1, L401.2, U401.1 (FB), U402.1 (Vin), U402.3 (EN)
/P4 - 3V3 Regulator/APBST: C403.2, U401.6 (BST)
/P4 - 3V3 Regulator/APSW: C403.1, L401.1, U401.5 (SW)
/P4 - 3V3 Regulator/POWER_LED: D401.2 (A), R401.2
/P4 - 3V3 Regulator/scLX: L402.1, U402.5 (LX)
GND: C402.2, C404.2, C405.2, C406.2, C407.2, D401.1 (K), U401.4 (GND), U402.2 (GND); also elsewhere on the board
VOUT: C402.1, U401.2 (EN), U401.3 (IN); also elsewhere on the board

Notes on the sheet:
Worst case average consumption while in use estimation ESP32 average consumption ~ 60mA Hall sensors average consumption ~ 20mA power status LEDs average consumption ~ 25mA Total worst case average consumption: ~105mA An LDO from 16.8V to 3.3V would waste a lot of energy, and have to dissapate a lo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
Grounding of these switchers on PCB is not ideal due to space constraints, and late addition to design. Due to the low current demands, it should not be a functional problem. Might be an emf problem.
Maximum consumption estimation ESP32 max consumption ~ 300mA Hall sensors max consumption ~ 20mA power status leds max consumption ~ 40mA Total max: ~360mA 30% margin: ~470mA
3.3V Regulator

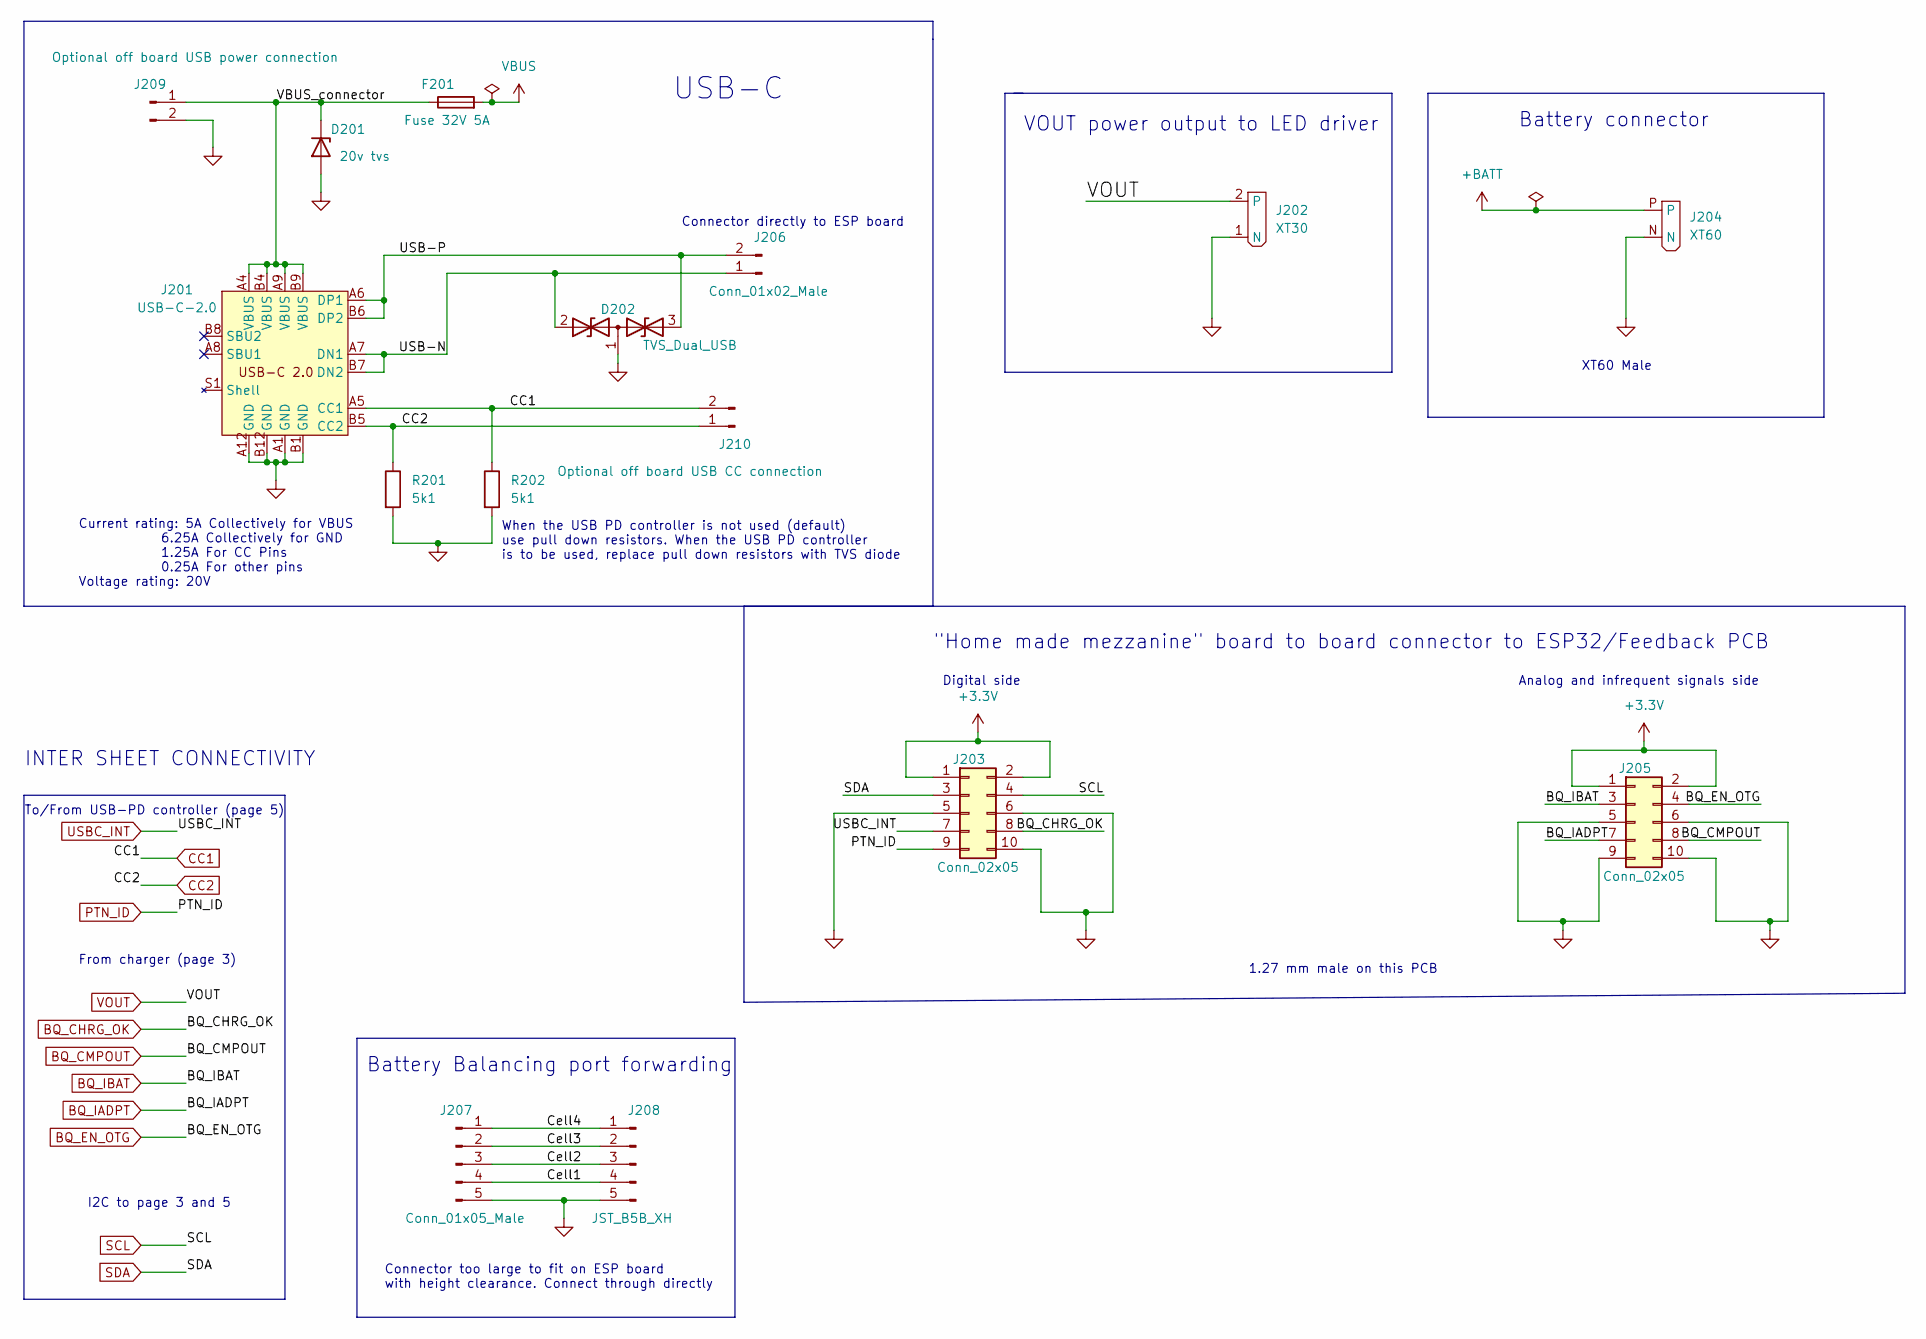
[picture p66: schematic P2Connectos.kicad_sch]

Parts:
D201: 20v tvs; D_SMA
D202: TVS_Dual_USB; IC_ESD122DMXR
F201: Fuse 32V 5A; Fuse_0603_1608Metric
J201: USB-C-2.0; GCT_USB4120-03-C_REVA
J202: XT30
J203, J205: Conn_02x05; PinHeader_2x05_P1.27mm_Vertical_SMD
J204: XT60
J206: Conn_01x02_Male; PinHeader_1x02_P1.27mm_Vertical_SMD_Pin1Left
J207: Conn_01x05_Male; PinHeader_1x05_P1.27mm_Vertical_SMD_Pin1Left
J208: JST_B5B_XH; JST_XH_B5B-XH-A_1x05_P2.50mm_Vertical
J209: Optional off board USB power connection; PinHeader_1x02_P2.00mm_Vertical
J210: Optional off board USB CC connection; PinHeader_1x02_P1.00mm_Vertical
R201, R202: 5k1; R_0402_1005Metric

Connections:
+3.3V: J203.1, J203.2, J205.1, J205.2; also elsewhere on the board
+BATT: J204.P; also elsewhere on the board
/P2-Connectors/Cell1: J207.4, J208.4
/P2-Connectors/Cell2: J207.3, J208.3
/P2-Connectors/Cell3: J207.2, J208.2
/P2-Connectors/Cell4: J207.1, J208.1
/P2-Connectors/USB-N: D202.2 (A1), J201.A7 (DN1), J201.B7 (DN2), J206.1
/P2-Connectors/USB-P: D202.3 (A2), J201.A6 (DP1), J201.B6 (DP2), J206.2
/P2-Connectors/VBUS_connector: D201.1 (K), F201.1, J201.A4 (VBUS), J201.A9 (VBUS), J201.B4 (VBUS), J201.B9 (VBUS), J209.1
BQ_CHRG_OK: J203.8; also elsewhere on the board
BQ_CMPOUT: J205.8; also elsewhere on the board
BQ_EN_OTG: J205.4; also elsewhere on the board
BQ_IADPT: J205.7; also elsewhere on the board
BQ_IBAT: J205.3; also elsewhere on the board
CC1: J201.A5 (CC1), J210.2, R202.1; also elsewhere on the board
CC2: J201.B5 (CC2), J210.1, R201.1; also elsewhere on the board
GND: D201.2 (A), D202.1 (common), J201.A1 (GND), J201.A12 (GND), J201.B1 (GND), J201.B12 (GND), J202.1 (N), J203.5, J203.6, J203.10, J204.N, J205.5, J205.6, J205.9, J205.10, J207.5, J208.5, J209.2, R201.2, R202.2; also elsewhere on the board
PTN_ID: J203.9; also elsewhere on the board
SCL: J203.4; also elsewhere on the board
SDA: J203.3; also elsewhere on the board
USBC_INT: J203.7; also elsewhere on the board
VBUS: F201.2; also elsewhere on the board
VOUT: J202.2; also elsewhere on the board

Notes on the sheet:
1.27 mm male on this PCB
VOUT power output to LED driver
Digital side
I2C to page 3 and 5
Connector too large to fit on ESP board with height clearance. Connect through directly
Battery Balancing port forwarding
USB-C
Analog and infrequent signals side
Battery connector
XT60 Male
INTER SHEET CONNECTIVITY
From charger (page 3)
Connector directly to ESP board
Current rating: 5A Collectively for VBUS 6.25A Collectively for GND 1.25A For CC Pins 0.25A For other pins Voltage rating: 20V
To/From USB-PD controller (page 5)
"Home made mezzanine" board to board connector to ESP32/Feedback PCB
When the USB PD controller is not used (default) use pull down resistors. When the USB PD controller is to be used, replace pull down resistors with TVS diode

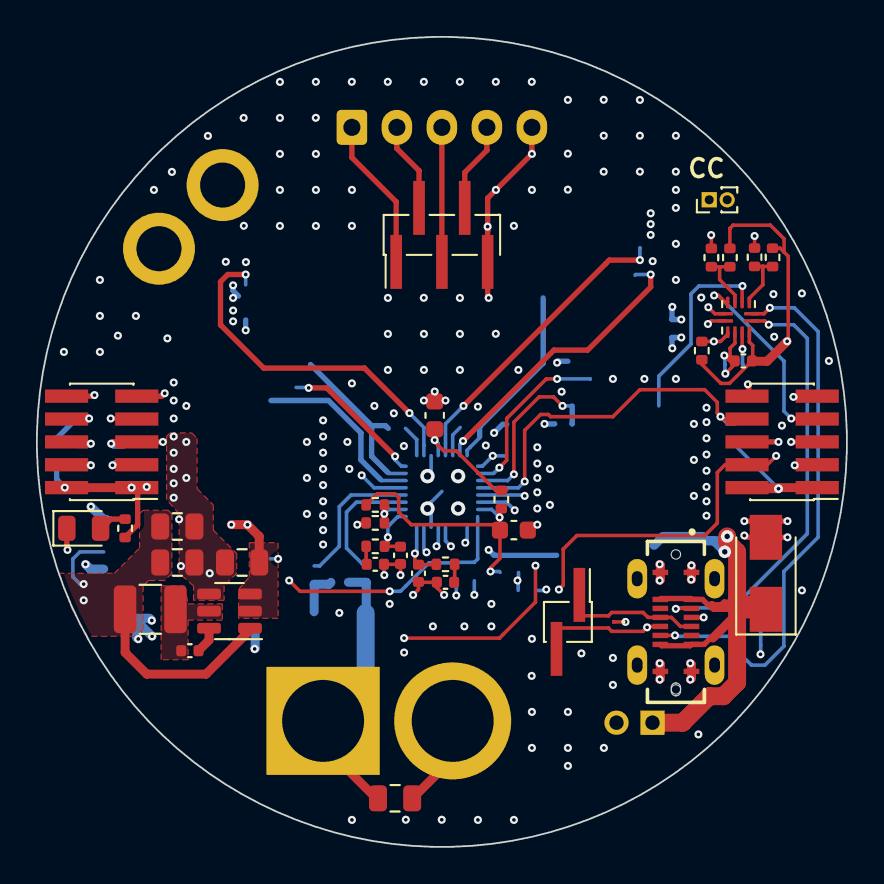
[picture p67: board BatteryManagementBoard.kicad_pcb from above]

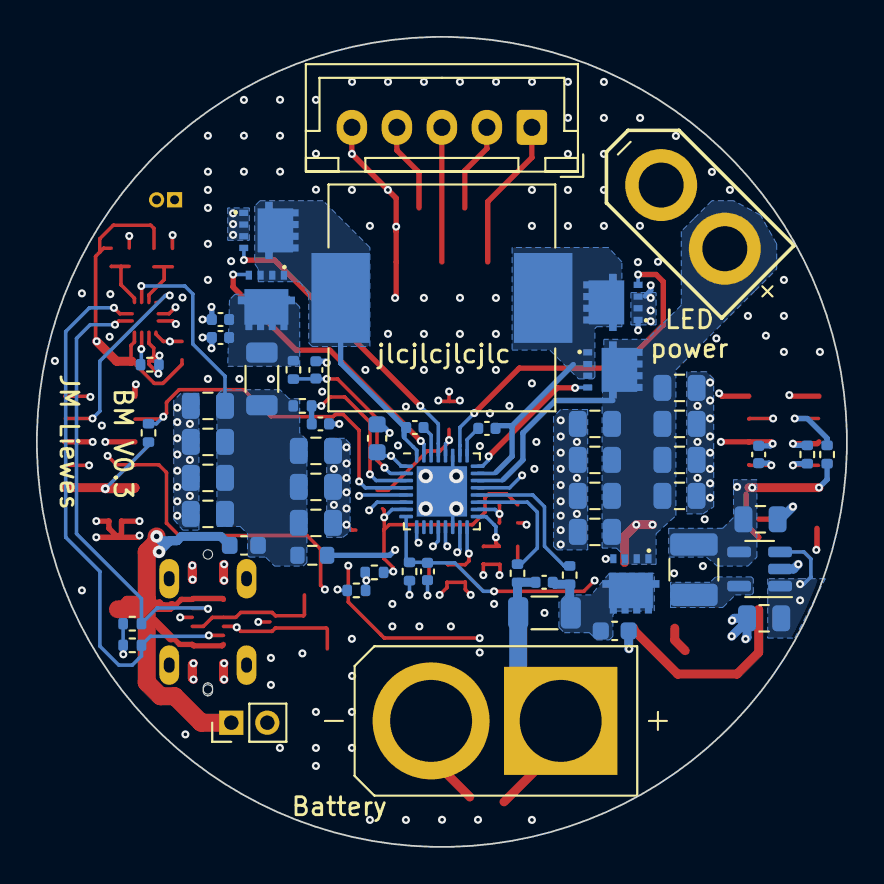
[picture p68: board BatteryManagementBoard.kicad_pcb from below]

Board: 6 copper layers, 45.0 x 45.0 mm, 93 parts (58 on the bottom side), 55 nets.
