Eldalote/Divelamp/KiCadProject/HallBoard/HallBoard.kicad_pcb

## KiCad design KiCadProject/HallBoard/HallBoard.kicad_pcb (2023-02-06)

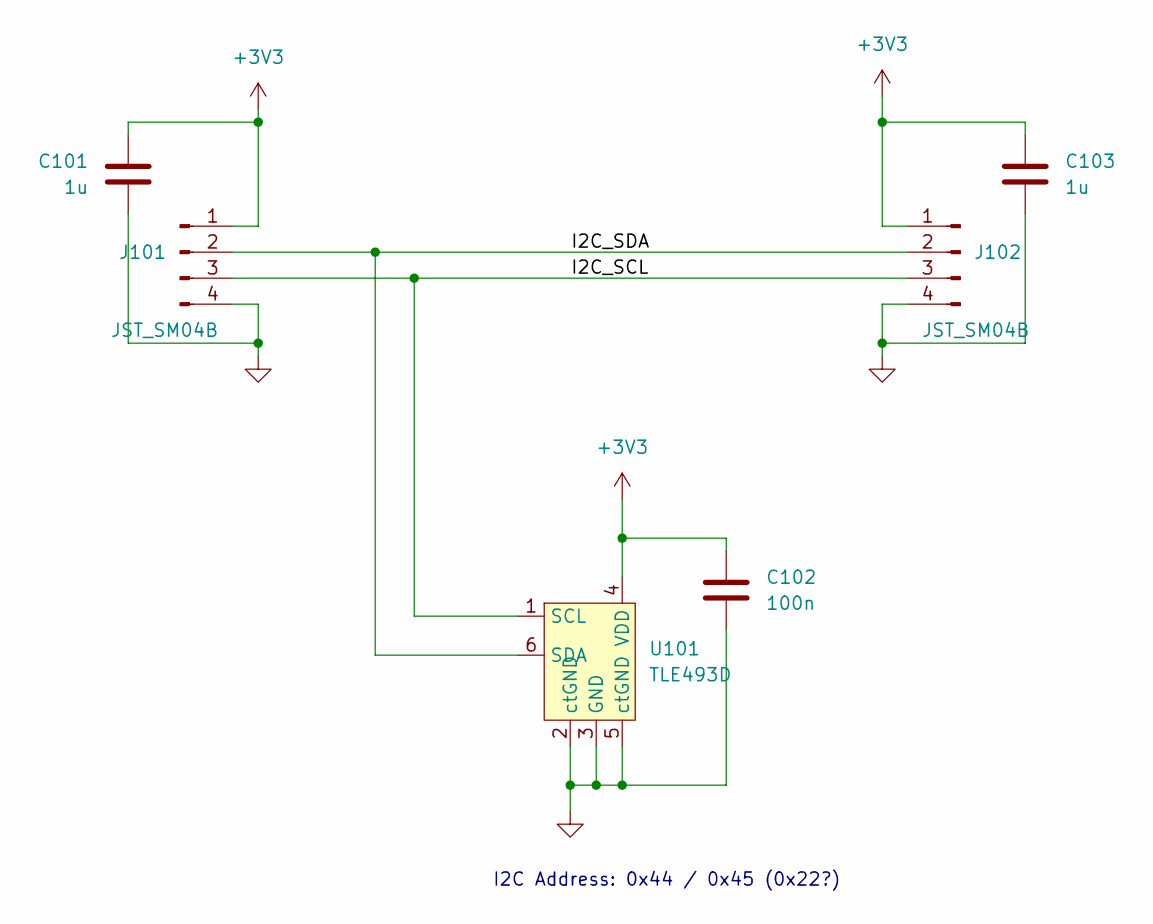
[picture p69: schematic HallBoard.kicad_sch, Hall Sensor for outside interaction]

Parts:
C101, C103: 1u; C_0603_1608Metric
C102: 100n; C_0402_1005Metric
J101, J102: JST_SM04B; JST_SH_SM04B-SRSS-TB_1x04-1MP_P1.00mm_Horizontal
U101: TLE493D; SOT-23-6

Connections:
+3V3: C101.1, C102.1, C103.1, J101.1, J102.1, U101.4 (VDD)
/I2C_SCL: J101.3, J102.3, U101.1 (SCL)
/I2C_SDA: J101.2, J102.2, U101.6 (SDA)
GND: C101.2, C102.2, C103.2, J101.4, J102.4, U101.2 (GND), U101.3 (GND), U101.5 (GND)

Notes on the sheet:
I2C Address: 0x44 / 0x45 (0x22?)

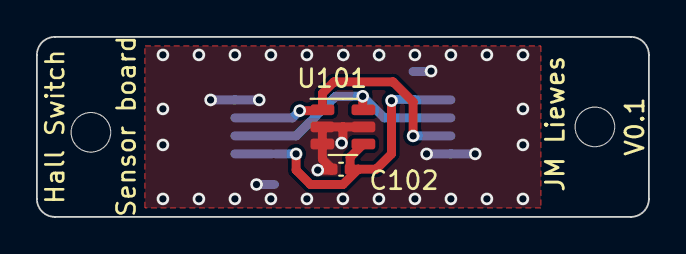
[picture p70: board HallBoard.kicad_pcb from above]

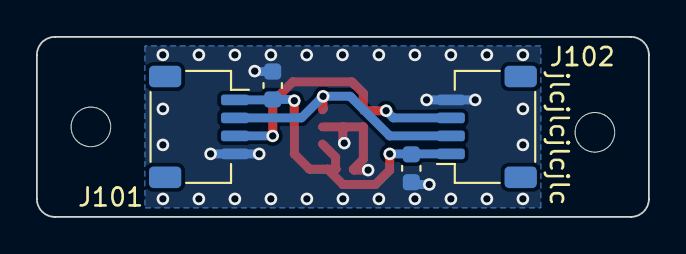
[picture p71: board HallBoard.kicad_pcb from below]

Board: 2 copper layers, 34.0 x 10.0 mm, 6 parts (4 on the bottom side), 4 nets.
