Eldalote/Divelamp/KiCadProject/SamsungLedBoard/SamsungLedBoard.kicad_pcb

## KiCad design KiCadProject/SamsungLedBoard/SamsungLedBoard.kicad_pcb (2023-02-06)

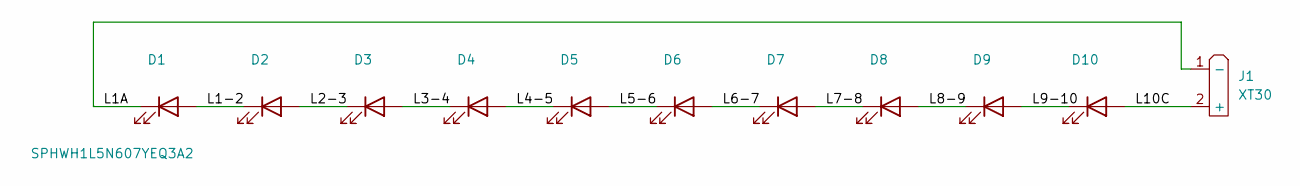
[picture p72: schematic SamsungLedBoard.kicad_sch, LED board for Samsung LEDs]

Parts:
D1, D2, D3, D4, D5, D6, D7, D8, D9, D10: SPHWH1L5N607YEQ3A2; LED5050_Samsung_LH502C
J1: XT30

Connections:
/L1-2: D1.2 (A), D2.1 (K)
/L1A: D1.1 (K), J1.1 (-)
/L2-3: D2.2 (A), D3.1 (K)
/L3-4: D3.2 (A), D4.1 (K)
/L4-5: D4.2 (A), D5.1 (K)
/L5-6: D5.2 (A), D6.1 (K)
/L6-7: D6.2 (A), D7.1 (K)
/L7-8: D7.2 (A), D8.1 (K)
/L8-9: D8.2 (A), D9.1 (K)
/L9-10: D9.2 (A), D10.1 (K)
/L10C: D10.2 (A), J1.2 (+)

Board: 2 copper layers, 11 parts (1 on the bottom side), 11 nets, no tracks yet.
