Eldalote/Divelamp/(commit log)

2022-11-14 Working on the component selection for the max16733
    [LEDDriver.kicad_sch, MAX16833_boost_calc.xls, Powerboard.kicad_pcb, Powerboard.kicad_sch, SamsungLedBoard.kicad_pcb, SamsungLedBoard.kicad_sch]
2022-11-16 Passive components selected, only fets and diode to go
    [LEDDriver.kicad_sch, MAX16833_boost_calc.xls, Powerboard.kicad_sch]
2022-11-21 Component selection for max16833 done?
    [Components.ods, LEDDriver.kicad_sch, MAX16833_boost_calc.xls, Powerboard.kicad_sch]
2022-12-01 Refinement work, and start PCB layout
    [Components.ods, LEDDriver.kicad_sch, Powerboard.kicad_pcb, Powerboard.kicad_sch]
2022-12-02 Much more refinement. Re-selected some components for more logical ones. Got all 3d models in place.
    [Components.ods, MAX16833_boost_calc.xls, PowerDI5.stp, PowerPAK SO-8.stp, Powerboard.kicad_pcb, Powerboard.kicad_sch, SRP1265C SERIES.stp, XT30-male.stp]
2022-12-03 Should be final placement on powerboard now, just finishing touches left.
    [Other side.kicad_pcb, Powerboard.kicad_pcb, Powerboard.kicad_sch]
2022-12-05 Led driver board v0.1 done
    [Components.ods, MAX16833_boost_calc.xls, Powerboard.kicad_pcb, Powerboard.kicad_sch]
2022-12-09 Started on the battery management board
    [BatteryManagementBoard.kicad_pcb, BatteryManagementBoard.kicad_sch, Components.ods, LEDDriver.kicad_sch, MAX16833_boost_calc.xls, Other side.kicad_pcb, P2Connectos.kicad_sch, P3Charger.kicad_sch]
2022-12-14 BQ25713 layout start
    [BatteryManagementBoard.kicad_sch, P2Connectos.kicad_sch, P3Charger.kicad_sch]
2022-12-16 BQ25713 and LDO done? Stm32 next I think
    [BatteryManagementBoard.kicad_sch, P2Connectos.kicad_sch, P3Charger.kicad_sch, P6LPregulator.kicad_sch, Powerboard.kicad_sch]
2022-12-21 Change to design: No more STM32, just use resistors for USB-C PD, en move the battery cell measuring and leveling to the other board.
    [5050660622.stp, BatteryManagementBoard.kicad_pcb, BatteryManagementBoard.kicad_sch, P2Connectos.kicad_sch, P3Charger.kicad_sch, P4LPregulator.kicad_sch]
2023-01-04 jan 4
    [BatteryManagementBoard.kicad_pcb, BatteryManagementBoard.kicad_sch, ESP32-S3-WROOM.step, ESPBoard.kicad_pcb, ESPBoard.kicad_sch, P2Connectos.kicad_sch, P3Charger.kicad_sch, P3ESP32.kicad_sch]
2023-01-05 ESP board layout mostly done. Small updates to battery management board
    [BatteryManagementBoard.kicad_sch, ESPBoard.kicad_pcb, ESPBoard.kicad_sch, P2Connectos.kicad_sch, P3Charger.kicad_sch, P3ESP32.kicad_sch, P4LPregulator.kicad_sch, P4SenseBalancing.kicad_sch]
2023-01-09 Final touches before component order and PCB layout
    [BatteryManagementBoard.kicad_pcb, BatteryManagementBoard.kicad_sch, ESD122DMXR.step, ESPBoard.kicad_sch, HallBoard.kicad_pcb, HallBoard.kicad_sch, P2Connectos.kicad_sch, P3Charger.kicad_sch]
2023-01-09 Final tweaks before component order and PCB completion mk2
    [BatteryManagementBoard.kicad_sch, P3Charger.kicad_sch]
2023-01-12 Components selected, MfID added to schematics, and components ordered
    [BatteryManagementBoard.kicad_sch, Components.ods, ESPBoard.kicad_pcb, ESPBoard.kicad_sch, HallBoard.kicad_sch, P2Connectos.kicad_sch, P3Charger.kicad_sch, P3ESP32.kicad_sch]
2023-01-16 Layout on the battery management board
    [BatteryManagementBoard.kicad_pcb, BatteryManagementBoard.kicad_sch, ESPBoard.kicad_pcb, P2Connectos.kicad_sch, P3Charger.kicad_sch, P4LPregulator.kicad_sch]
2023-01-19 Routed Bat management (replaced TUSB because it physically can't be routed with constraints)
    [BatteryManagementBoard.kicad_pcb, BatteryManagementBoard.kicad_sch, ESPBoard.kicad_pcb, P2Connectos.kicad_sch, P5TUSB422.kicad_sch]
2023-01-25 Finished v0.1 of BatMan PCB, started layout of ESP PCB
    [BatteryManagementBoard-B_Cu(signal).gbr, BatteryManagementBoard-B_Mask.gbr, BatteryManagementBoard-B_Paste.gbr, BatteryManagementBoard-B_Silkscreen.gbr, BatteryManagementBoard-Edge_Cuts.gbr, BatteryManagementBoard-F_Cu(signal).gbr, BatteryManagementBoard-F_Mask.gbr, BatteryManagementBoard-F_Paste.gbr]
2023-01-26 Finished V0.1 of ESP PCB
    [ESPBoard.kicad_pcb, ESPBoard.kicad_sch, P3ESP32.kicad_sch]
2023-02-01 All PCB's should be done. Do a final check before ordering.
    [2130830005.stp, BatteryManagementBoard.kicad_pcb, BatteryManagementBoard.kicad_sch, ESPBoard.kicad_pcb, HallBoard.kicad_pcb, LEDDriver.kicad_sch, OuterUSB.kicad_pcb, OuterUSB.kicad_sch]
2023-02-02 Made ready to order PCBs. Some problems with ordering due to misunderstanding. Thinking about solutions
    [BatteryManagementBoard-B_Cu(signal).gbl, BatteryManagementBoard-B_Cu(signal).gbr, BatteryManagementBoard-B_Mask.gbr, BatteryManagementBoard-B_Mask.gbs, BatteryManagementBoard-B_Paste.gbp, BatteryManagementBoard-B_Paste.gbr, BatteryManagementBoard-B_Silkscreen.gbo, BatteryManagementBoard-B_Silkscreen.gbr]
2023-02-06 Started work on body 3d work
    [Battery-BatteryBlock.step, Battery-BatteryBlock.stl, Battery.FCStd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]
2023-02-27 Body 3d print design work
    [HousingMachining.FCStd]
2023-03-20 Housing top
