Eldalote/Divelamp/(notices)

Notices in the files:
KiCadImports/3DModels/USB4140-GF-0170-C.stp:
author */ ('License CC BY-ND 4.0'),
